DeepWiSe888/Octopus/hardware/README.md

# Getting to Know the Hardware

We offer information about the hardware and tips on how to use the hardware. For more details about the hardware, please refer to the schematics. Here, we just list the key components in the following pictures.

## Antenna Array Board

<p align="center">
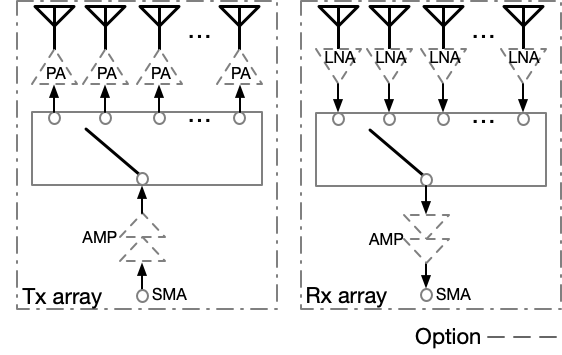
[picture p3: image/array_block.png]
   
</p>

<!-- ![Aaron Swartz](https://raw.githubusercontent.com/DeepWiSe888/Octopus/main/image/array_block.png) -->

The above figure is the top-level schematic of antenna array board. The PA, LNAs and AMPs of Tx/Rx array are optional components for some special reqirements. 

<p align="center">
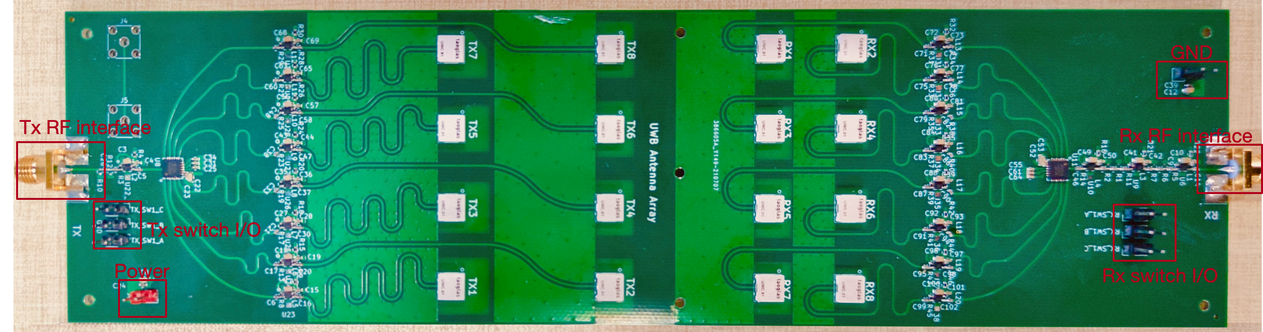
[picture p4: image/array_board.png]
   
</p>

<!-- ![Aaron Swartz](https://raw.githubusercontent.com/DeepWiSe888/Octopus/main/image/array_board.png) -->

- *Tx RF interface*: This interface connects to the Tx radio that allows RF signals to be transmitted at range from 0 GHz and 8 GHz. 
- *Rx RF interface*: This interface connects to the Rx radio that allows RF signals to be received at range from 0 GHz and 8 GHz. 
- *Tx switch I/Os*: The header pins are used for Tx antenna switching. FPGA sends the controlling signals through these I/O pins. 
- *Rx switch I/Os*: The header pins are used for Rx antenna switching. FPGA sends the controlling signals through these I/O pins. 
- *Power*: The power jack is used to connect to the power supply.
- *GND*: The ground is used to connect to other developing boards in ground plane.

## Principle of the MIMO Radar
To understand the working principles of the MIMO radar, we first look at a simple example. In the simple antenna array, we have 1 Tx antenna and 4 Rx antennas, and the Rx antennas are separated by a distance of λ/2, as shown below.

<p align="center">
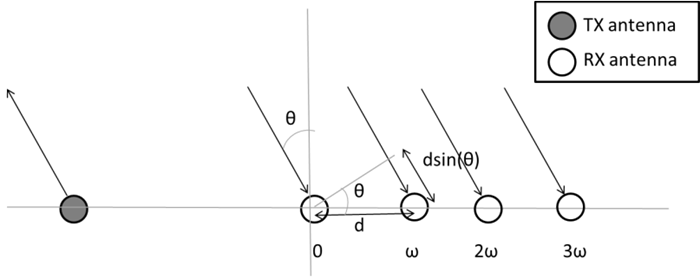
[picture p5: image/mimo0.png]
   
</p>

<!-- ![Aaron Swartz](https://raw.githubusercontent.com/DeepWiSe888/Octopus/main/image/mimo0.png) -->

If we want to double the angle resolution capability of the array, one possible solution is to double the number of Rx antenna, as shown in the figure below.

<p align="center">
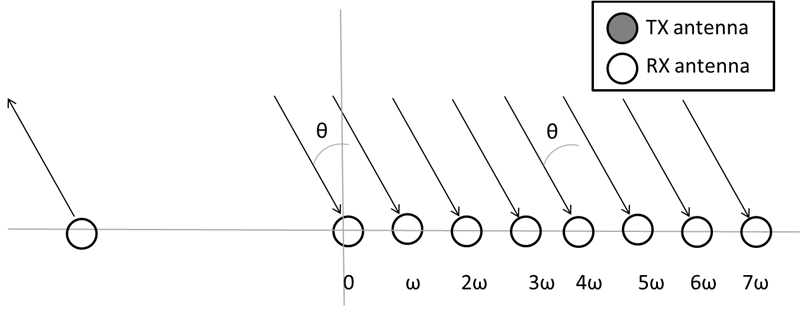
[picture p6: image/mimo1.png]
   
</p>

<!-- ![Aaron Swartz](https://raw.githubusercontent.com/DeepWiSe888/Octopus/main/image/mimo1.png) -->

Using MIMO concepts, the same result can be achieved with just one additional Tx antenna, as shown below.

<p align="center">
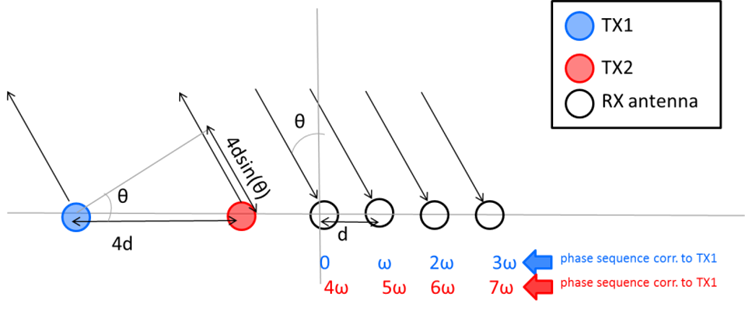
[picture p7: image/mimo2.png]
   
</p>

<!-- ![Aaron Swartz](https://raw.githubusercontent.com/DeepWiSe888/Octopus/main/image/mimo2.png) -->

In the above figure, the antenna array has two transmit antennas, Tx1 and Tx2. A transmission from Tx1 results in a phase of \[0 ω 2ω 3ω\] at the four RX antennas (with the first Rx antenna as a reference). Because the second Tx antenna (Tx2) is placed a distance of 4d from Tx1, any signal emanating from Tx2 traverses an additional path of length 4dsin(θ) compared to Tx1. Correspondingly, the signal at each Rx antenna sees an additional phase-shift of 4ω (with regard to transmission from Tx1). The phase of the signal at the four Rx antennas, due to a transmission from Tx2, is \[4ω 5ω 6ω 7ω\]. Concatenating the phase sequences at the four Rx antennas, due to transmissions from Tx1 and Tx2, gets the sequence \[0 ω 2ω 3ω 4ω 5ω 6ω 7ω\], which is the same sequence as the configuration of 1 Tx and eight Rx antennas. It can be said that the 2Tx – 4Rx antenna configuration synthesizes a virtual array of eight RX antennas (with one Tx antenna being implied).

To generalize the previous discussion, with N<sub>Tx</sub> and N<sub>RX</sub> antennas, users can generate (with proper antenna placement) a virtual antenna array of N<sub>TX</sub> X N<sub>Rx</sub>. Thus, employing MIMO radar techniques, results in a multiplicative increase in the number of (virtual) antennas, and corresponds to improvement in the angle resolution.

If p<sub>m</sub> denotes the coordinates of the mth Tx antenna (m = 0, 1, ...N<sub>Tx</sub>), and q<sub>n</sub> denotes the coordinates of the n-th Rx antenna (n = 0, 1, 2, …N<sub>Rx</sub>), then the location of the virtual antennas can be computed as p<sub>m</sub>+q<sub>n</sub>, for all possible values of m and n. For example in Figure 5, p<sub>1</sub> = 0 and p<sub>2</sub> = 4, and q<sub>1</sub> = 0, q<sub>2</sub> = 1, q<sub>3</sub> = 2, and q<sub>4</sub> = 3 (where the coordinates are expressed in units of d, and the Tx1 (respectively Rx1) is assumed to be the origin for the Tx (respectively, Rx) antennas.

The figure below shows the principle of MIMO radar can also be extended to multidimensional arrays.

<p align="center">
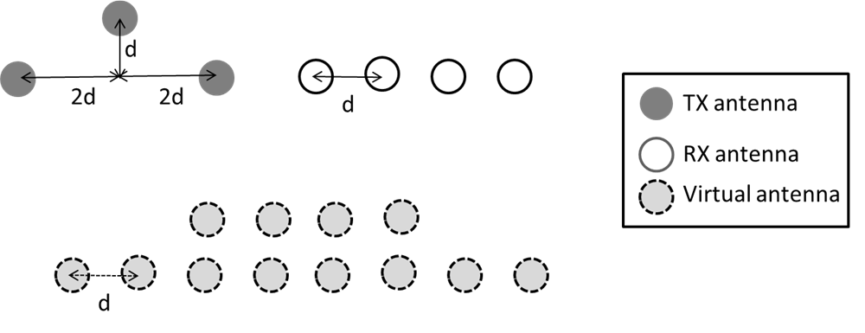
[picture p8: image/mimo3.png]
   
</p>

<!-- ![Aaron Swartz](https://raw.githubusercontent.com/DeepWiSe888/Octopus/main/image/mimo3.png) -->

Based on the above-mentioned analysis, each of Octopus antenna array can provide an equivalent of 2 x 7 x 2 = 28 virtual antennas.

## X4 Evaluation Board

<p align="center">
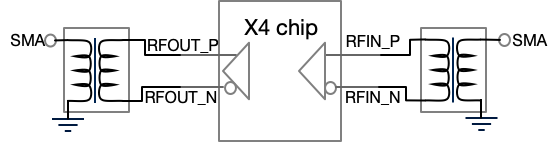
[picture p9: image/x4_eval_block.png]
   
</p>

<!-- ![Aaron Swartz](https://raw.githubusercontent.com/DeepWiSe888/Octopus/main/image/x4_eval_block.png) -->

The top-level schematic of X4 evaluation board is shown in the above figure. The Rx/Tx port of X4 chip is differential output, and then the RF balun is applied to transform it to single Rx/Tx port.  Refer to the ADI [NCR2-123+](https://www.minicircuits.com/pdfs/NCR2-123+.pdf) for full specifications.

<p align="center">
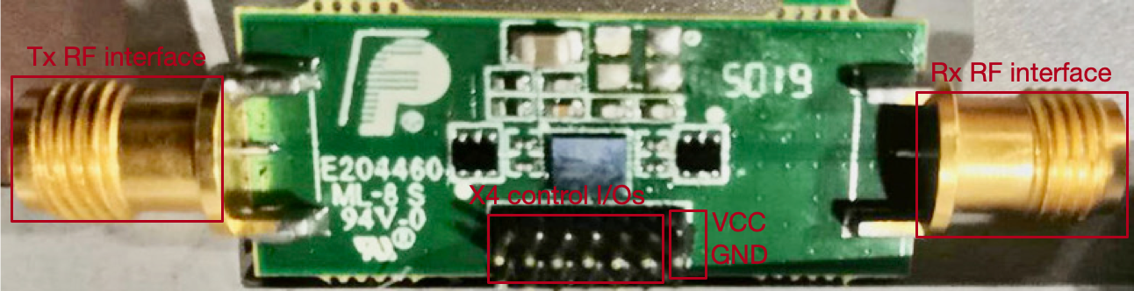
[picture p10: image/x4_board.png]
   
</p>

<!-- ![Aaron Swartz](https://raw.githubusercontent.com/DeepWiSe888/Octopus/main/image/x4_board.png) -->

- *Tx RF interface*: This interface connects to the Tx radio that allows RF signals to be transmitted at 7.29 GHz with 1.4 GHz bandwidth.
- *Rx RF interface*: This interface connects to the Rx radio that allows RF signals to be received at 7.29 GHz with 1.4 GHz bandwidth.
- *X4 control I/Os*: The header pins includes SPI pins, clock synchronization pins, trigger pins, etc. which are connected to FPGA.
- *Power*: The power jack is where the power supply that comes with power source.
- *GND*: The ground is used to connect to other developing boards in ground plane.

## X4 Chip Circuit Overview

X4 chip is a radar transceiver SoC for UWB applications.  The overview of X4 internal circuit is shown in the figure below. The figure also illustrates our hardware design rationale in the previous sections. This figure come from Page 12 of the X4 chip datasheet.

<p align="center">
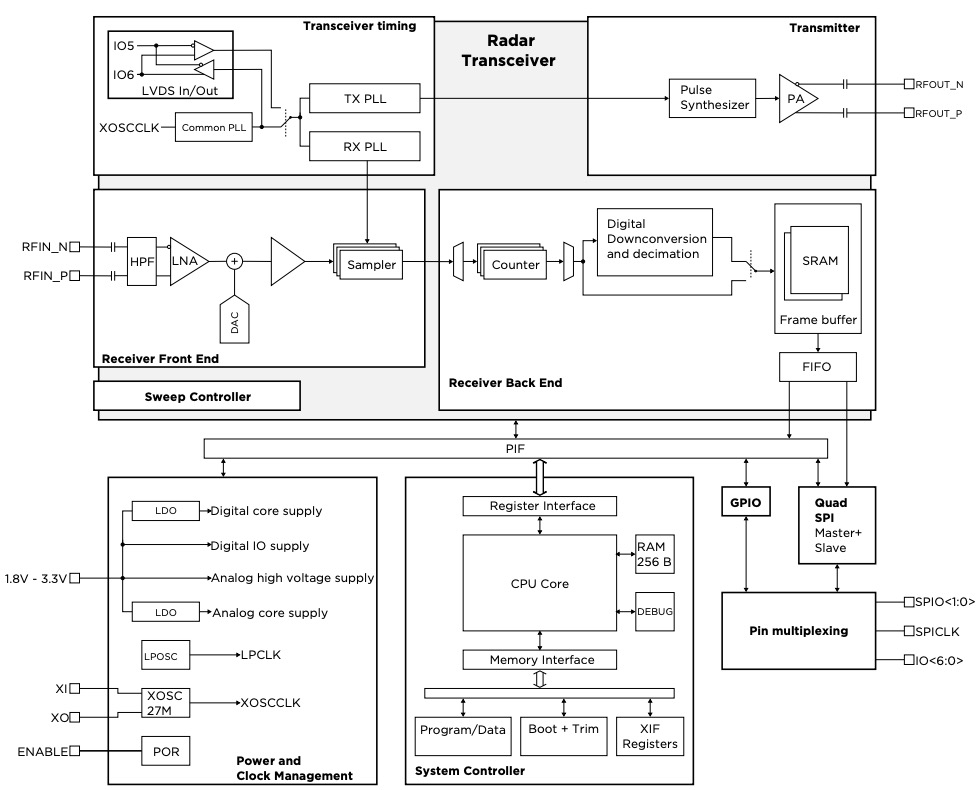
[picture p11: image/x4_circuit.jpg]
   
</p>

<!-- ![Aaron Swartz](https://raw.githubusercontent.com/DeepWiSe888/Octopus/main/image/x4_circuit.jpg) -->

### Tx Data Path

The Tx data path of the X4 consists of a pulse generator that is capable of generating pulses (max rate of 60.75 MHz). The center frequency and bandwidth of the output pulse is designed in compliance with worldwide RF regulations.

### Rx Data Path

The Rx data path of the X4 includes a Low Noise Amplifier (LNA), a Digital-to-Analog Converter (DAC) for setting thresholds, 1536 parallel comparators/samplers and digital integrators, as well as an output memory buffer, which is accessible through the SPI interface. The Rx data path is closely integrated with the transmitter (Tx) and is designed for coherent integration of the received energy.

### Clock

There are two types of clocks in the X4 chip: internal and external clocks. We shall elaborate on these clocks in the following:

#### Internal Clock

The crystal oscillator (XOSC) is designed for providing the radar transceiver core with a stable and accurate reference clock signal.  In the figure below, we show a typical block schematic when the X4 is clocked using the XOSC.

<p align="center">
   [YOUR_ALT]
</p>
<!-- ![Aaron Swartz](https://raw.githubusercontent.com/DeepWiSe888/Octopus/main/image/x4_interClock.jpg) -->

#### External Clock

- In XOSC bypass mode the radar core is clocked by an external low frequency clock source. This mode can be useful if there is already a clock signal available on the application PCB. The external clock input pin supports single-ended inputs. In the figure below, we show a typical block schematic when the X4 is clocked using the XOSC bypass mode.

<p align="center">
   [YOUR_ALT]
</p>

<!--   ![Aaron Swartz](https://raw.githubusercontent.com/DeepWiSe888/Octopus/main/image/x4_exClock1.jpg) -->

- In Common PLL bypass mode the radar transceiver core is clocked by an external high frequency clock from the LVDS interface on pins IO5 and IO6 and the Common PLL is bypassed. This allows multiple radars to stay synchronized which is required for digital beamforming applications. In the figure below, we show a block diagram of the Common PLL in bypass mode.

<p align="center">
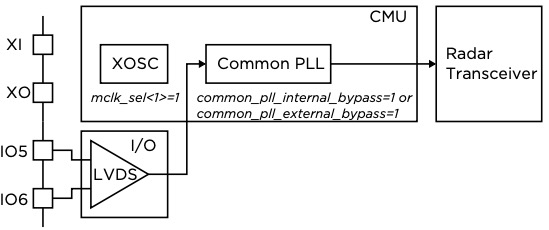
[picture p12: image/x4_exClock2.jpg]
   
</p>

<!--   ![Aaron Swartz](https://raw.githubusercontent.com/DeepWiSe888/Octopus/main/image/x4_exClock2.jpg) -->

For more information, please refer to X4 chip [datasheet](https://www.radartutorial.eu/19.kartei/13.labs/pubs/x4_datasheet_revE_restricted.pdf).

## RF Port

A 50 ohm SMA jack is employed to connect to each RF interface. This connector is a standard-thread and standard-polarity SMA jack.  

## Power Supply

All the boards requires an external 5V DC power supply. 

## Design Files

[*sch/X4_ArrayUnit.pdf*](https://github.com/DeepWiSe888/Octopus/blob/main/hardware/sch/X4_ArrayUnit.pdf): This  file is the schematic of the whole antenna array board.

[*sch/X4_TestingBoard.pdf*](https://github.com/DeepWiSe888/Octopus/blob/main/hardware/sch/X4_TestingBoard.pdf): This file describe the testing RF switch board for loopback evaluation.

[*sch/X4_DevBoard.pdf*](https://github.com/DeepWiSe888/Octopus/blob/main/hardware/sch/X4_DevBoard.pdf): This file is the X4 Evaluation Board
