DeepWiSe888/Octopus/image/mimo4.png

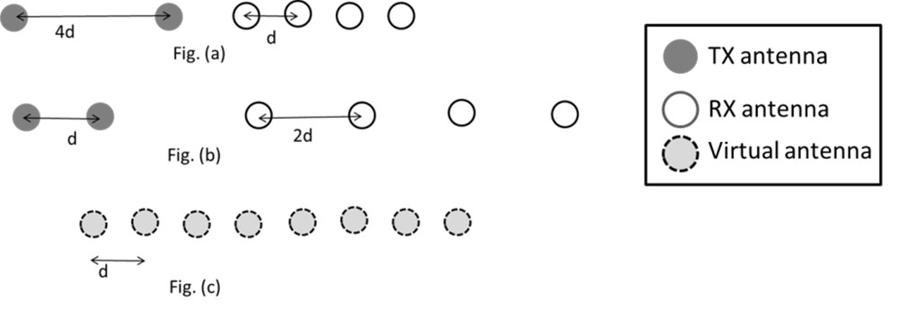
image/mimo4.png
