DeepWiSe888/Octopus/(list of files, cad)

Other CAD files:
source/FPGA_qxp_prj/prj/output_files/gg.stp
