DeepWiSe888/Octopus/hardware/sch/AW_UWB_TS_01.pdf

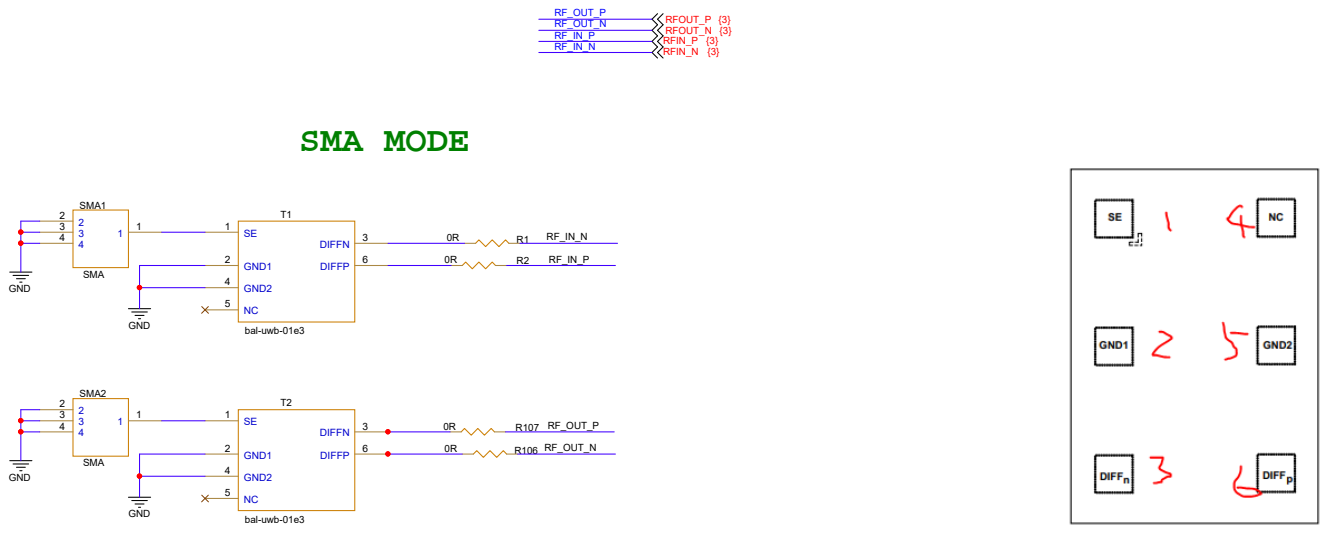
[picture p15: page 1]
SMA MODE; GND; RFOUT_P {3} RFOUT_N {3} RFIN_P {3} RFIN_N {3}; Title; MODE; SMA2; SMA; bal-uwb-01e3; GND1 2; GND2 4; DIFFP; DIFFN; SMA1; RF_OUT_P RF_OUT_N RF_IN_P RF_IN_N; RF_OUT_N; RF_OUT_P

Size A3 | Document Number SCH | Rev V1.0

Date: Wednesday, November 27, 2019 Wednesday, November 27, 2019 Wednesday, November 27, 2019 | Sheet 1 1 1 of 3 3 3

VDD_IN | VDD_X4
R100 | 0R

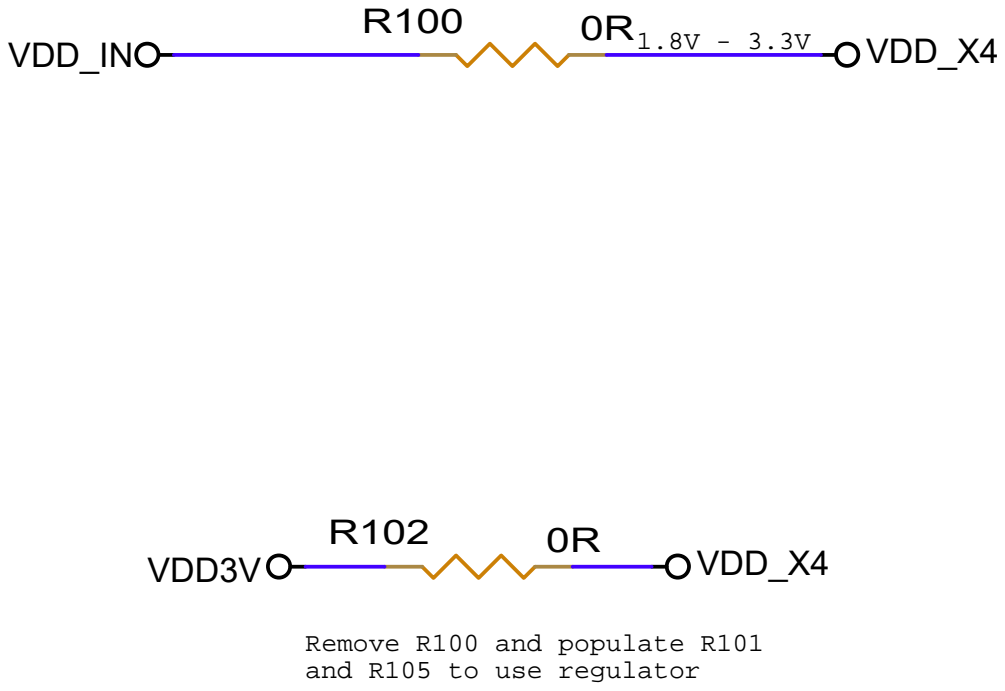
[picture p16: page 2]
VDD3V; VDD_X4; Title; LTC3621EDCB; Wednesday, November 27, 2019

Remove R100 and populate R101
and R105 to use regulator

# TO MCU MODULE

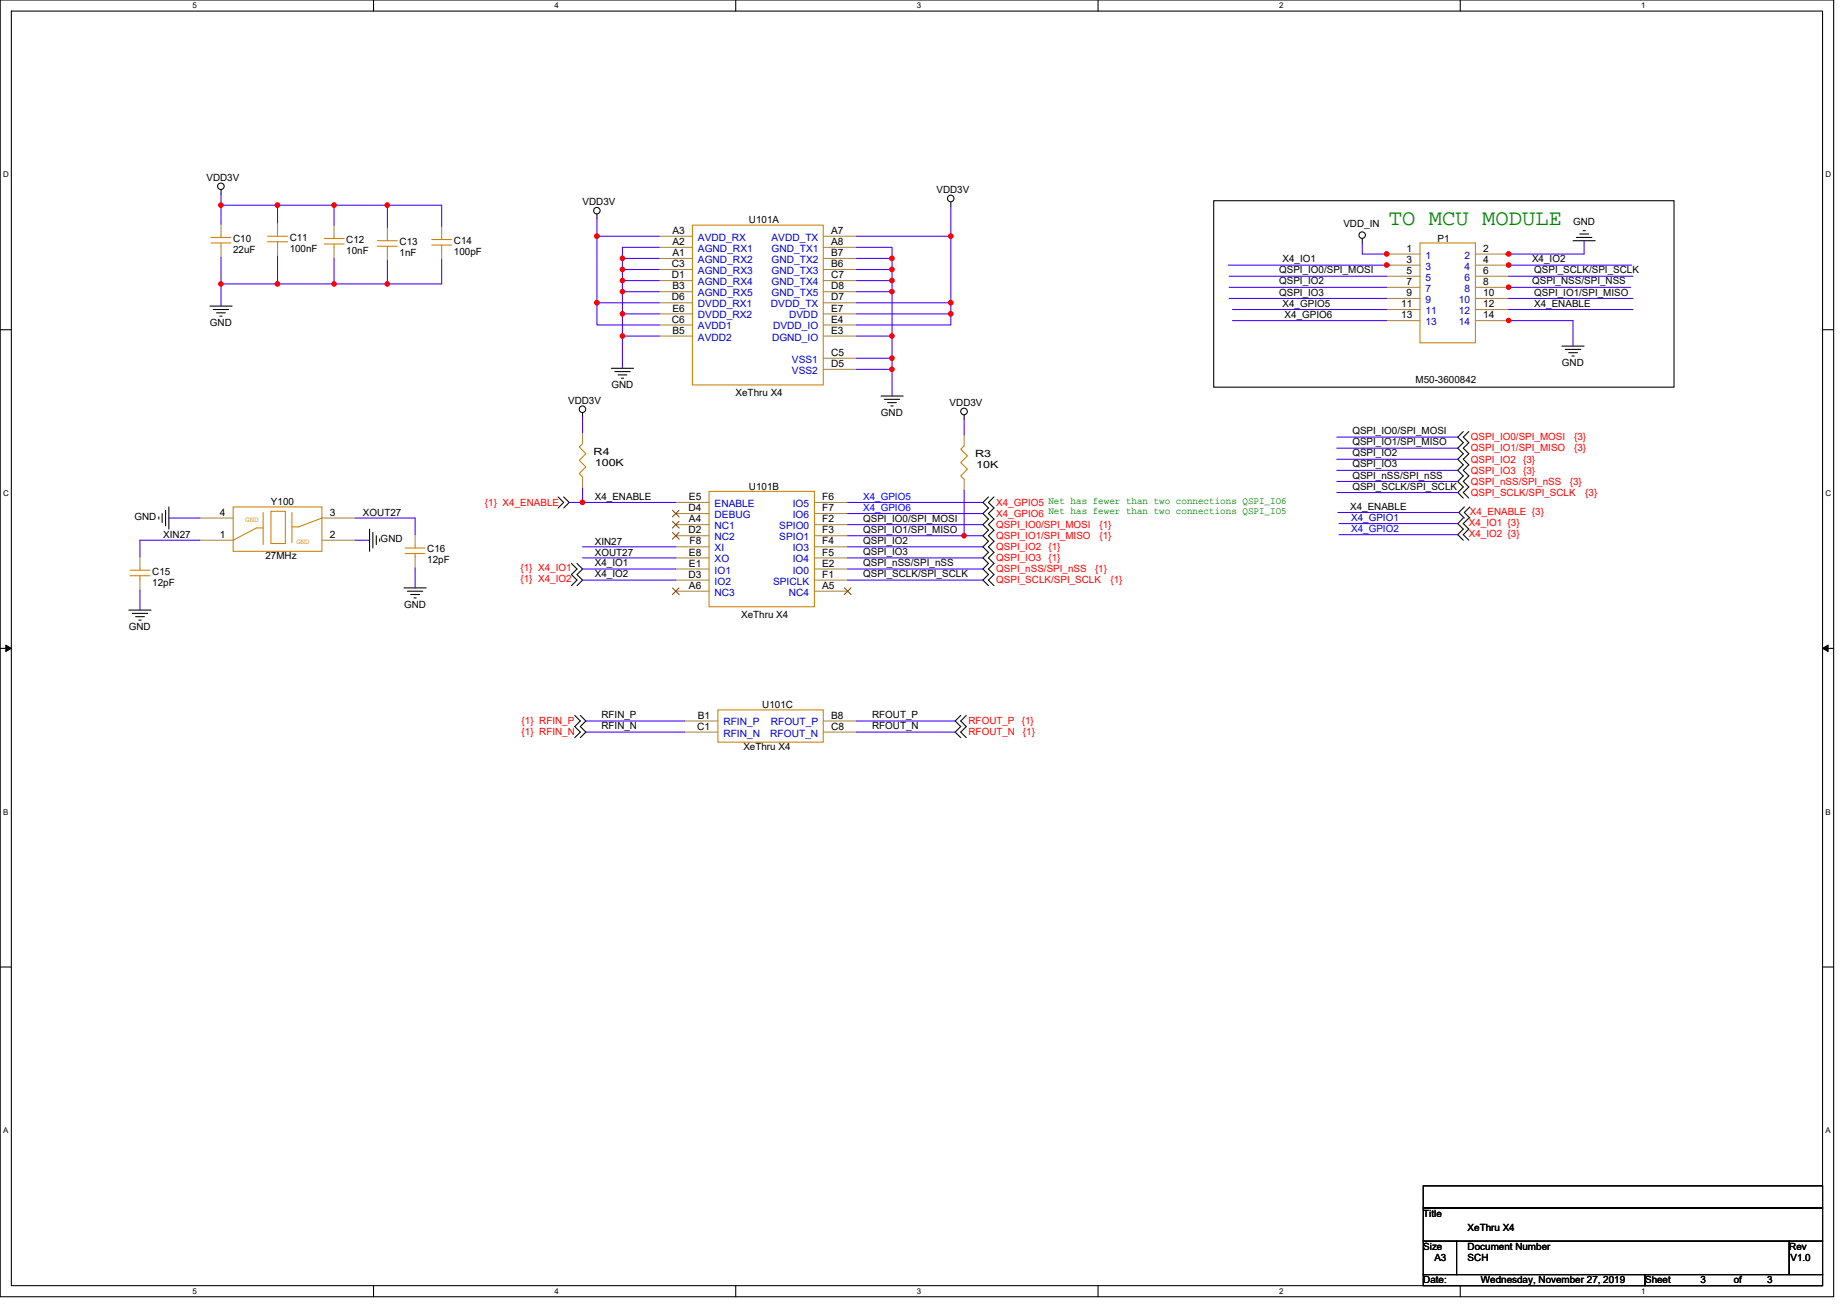
[picture p17: page 3]

Net has fewer than two connections QSPI_IO6
Net has fewer than two connections QSPI_IO5
