DeepWiSe888/Octopus/hardware/sch/X4_TestingBoard.pdf

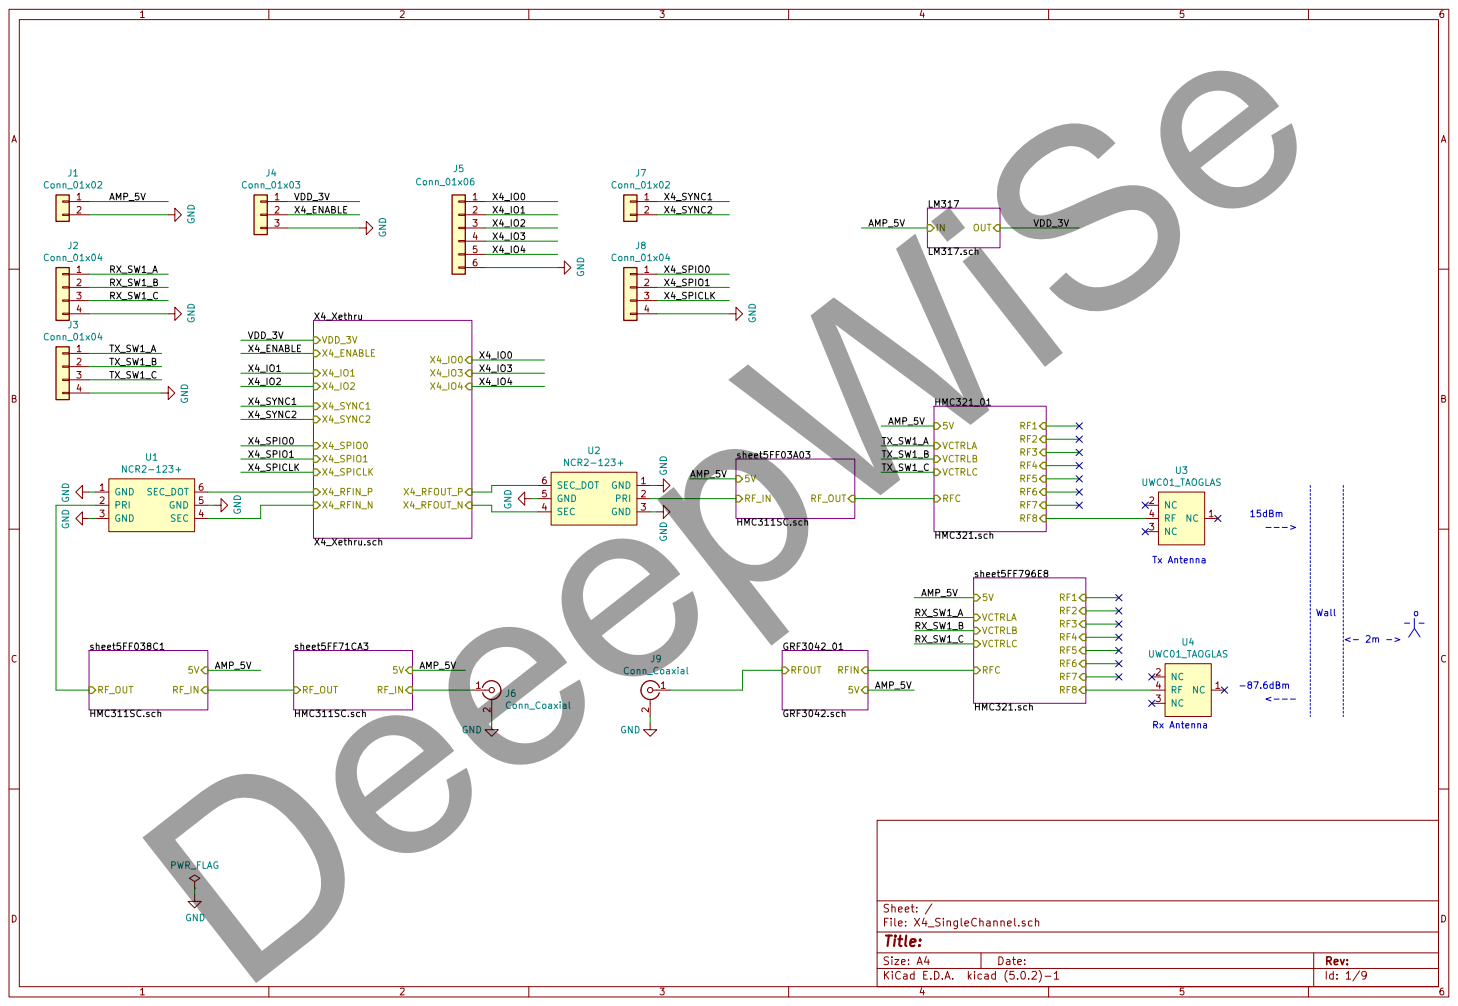
[picture p18: page 1]

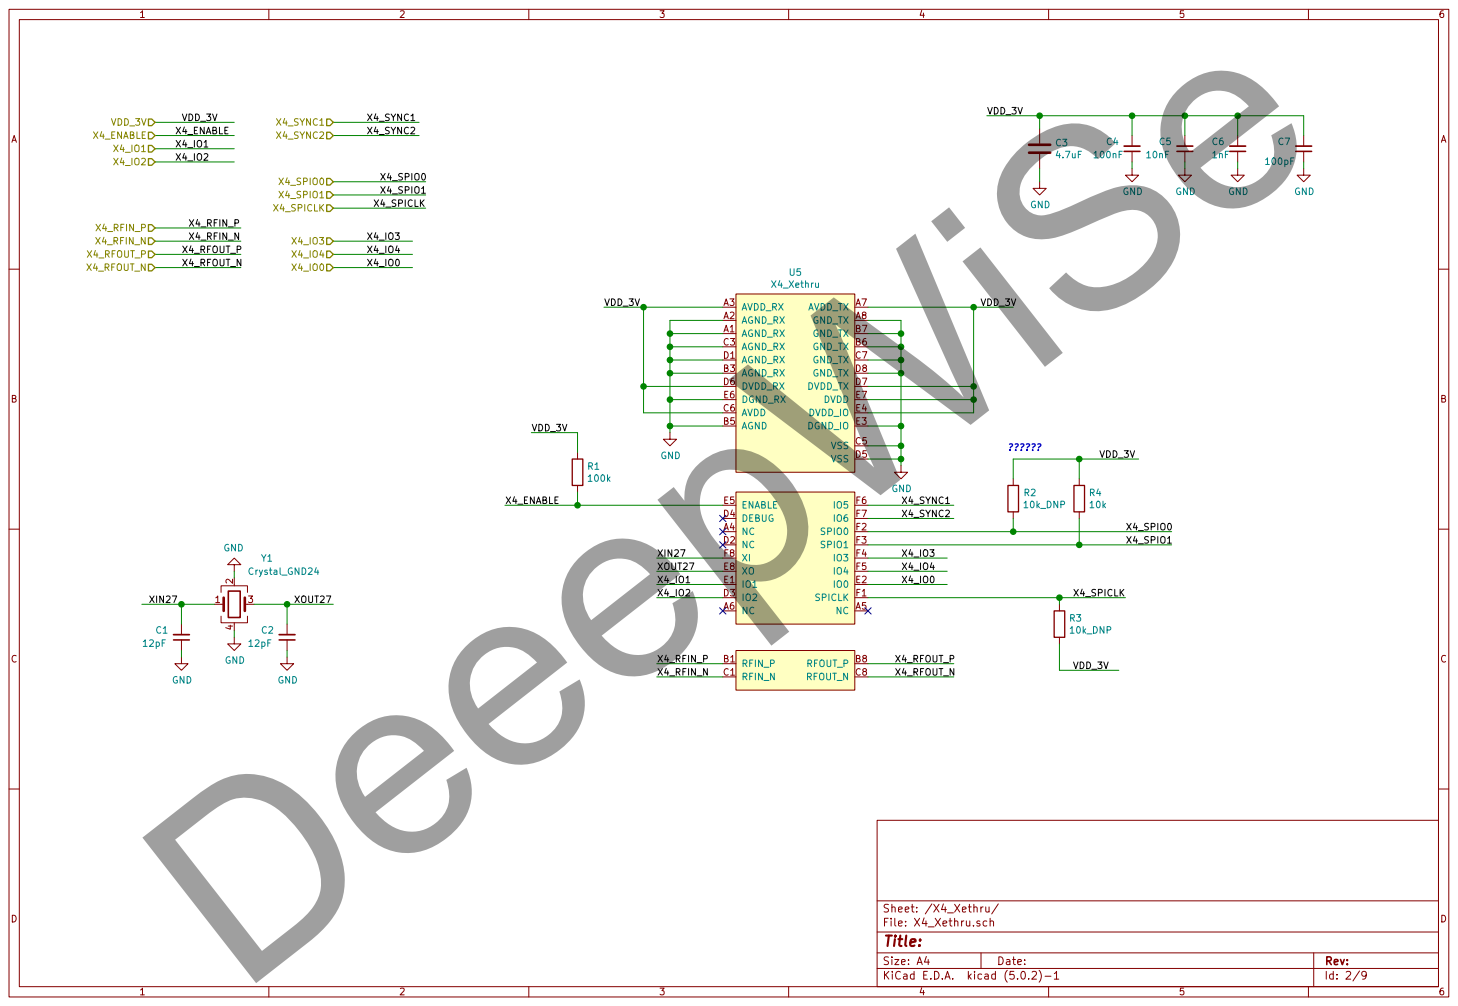
[picture p19: page 2]

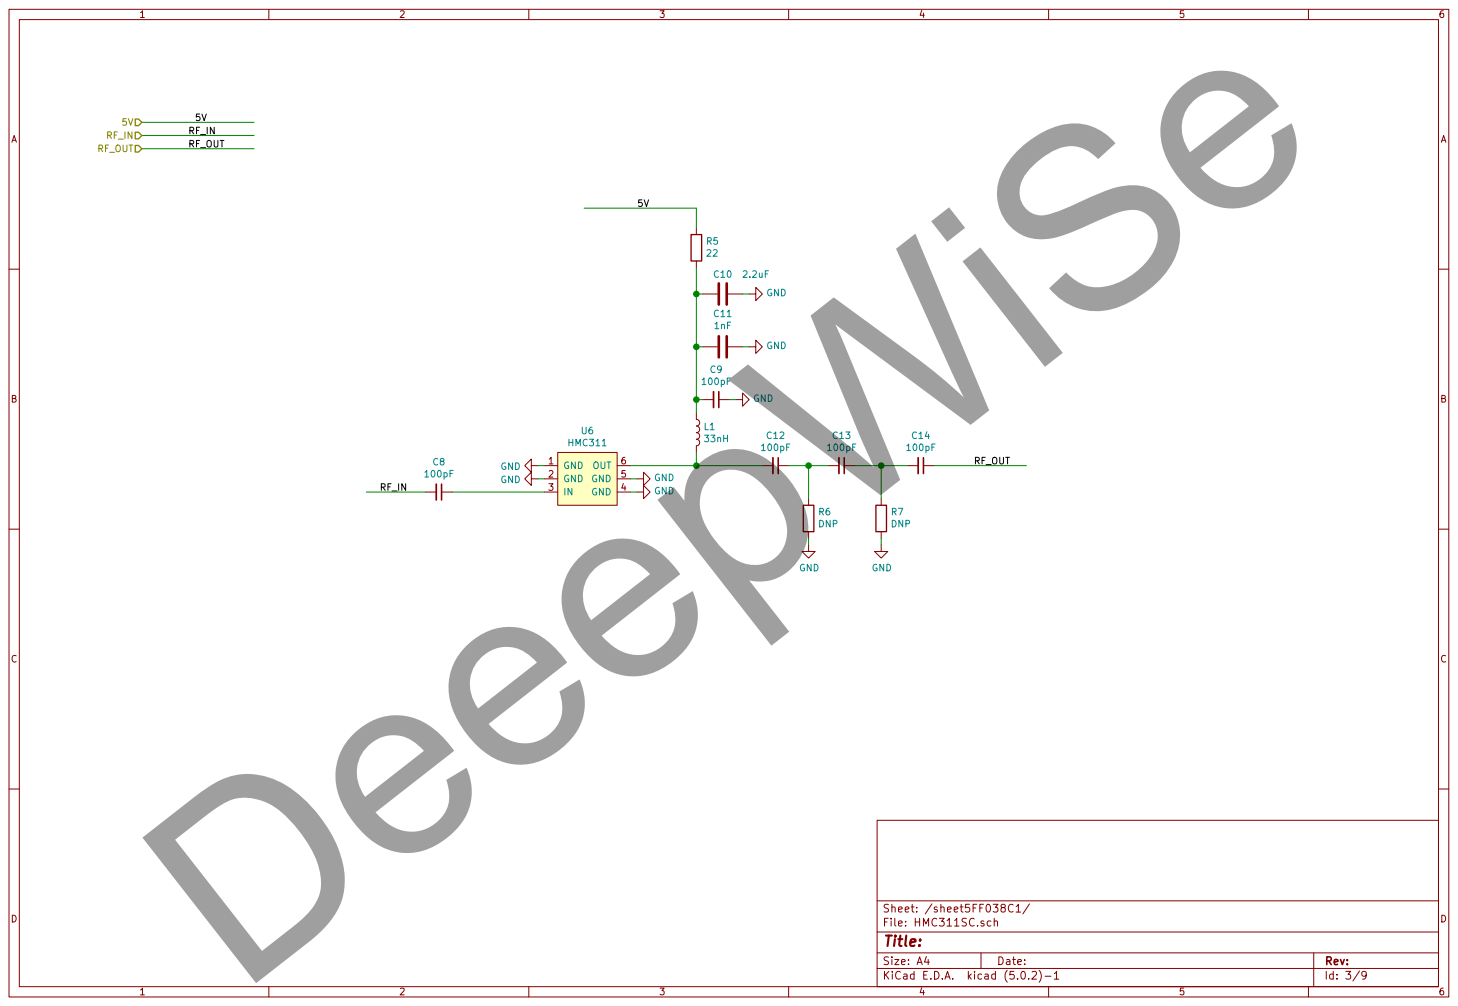
[picture p20: page 3]

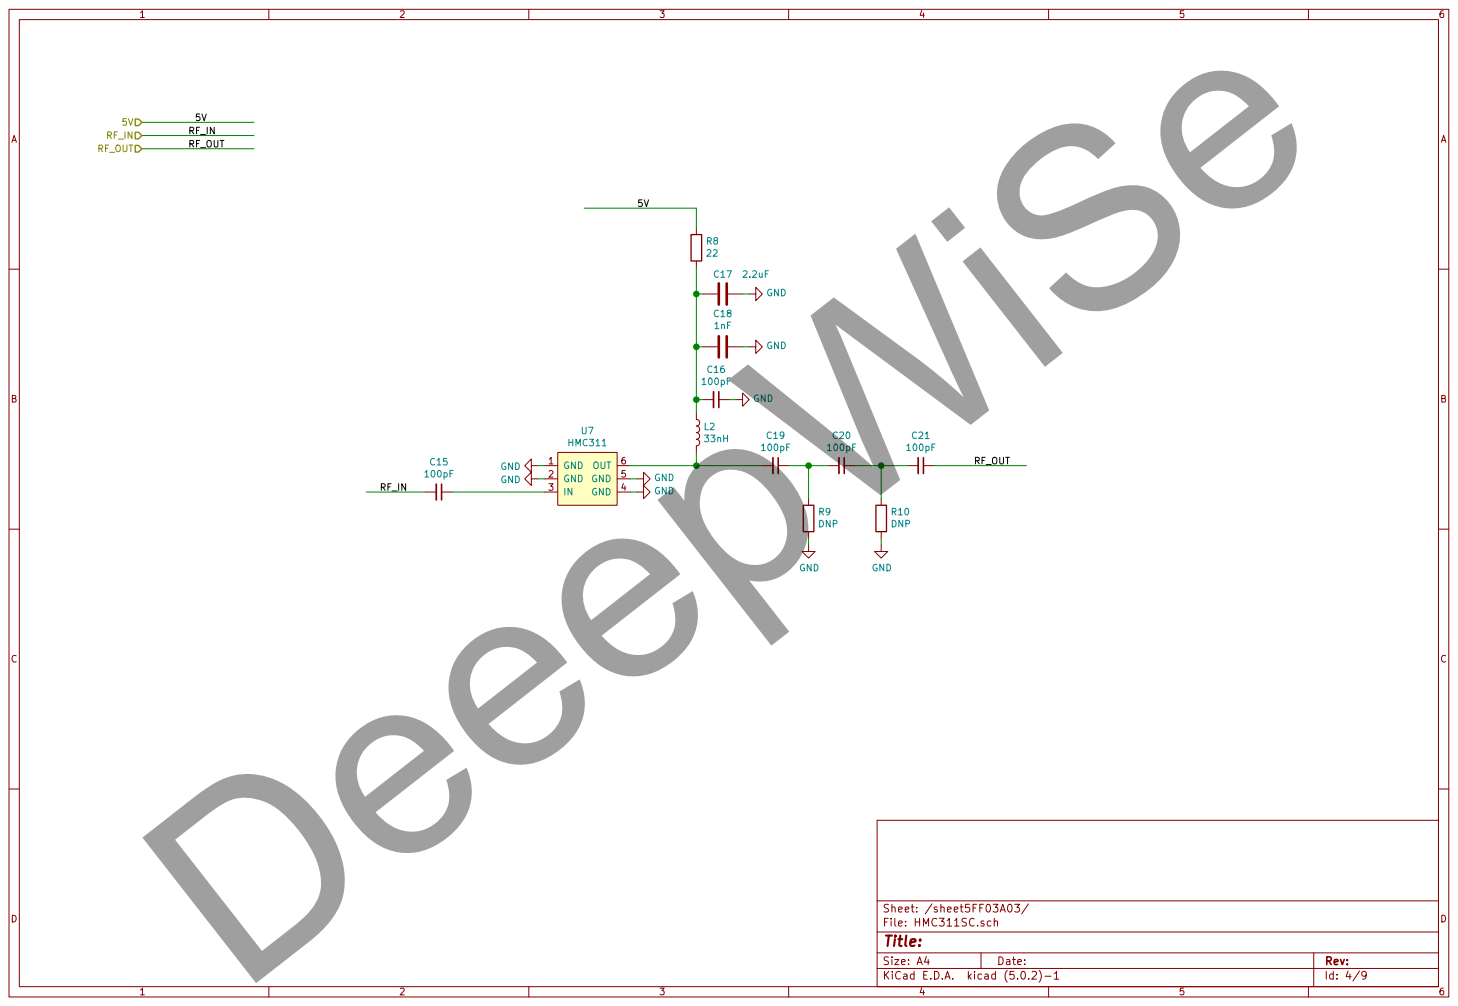
[picture p21: page 4]

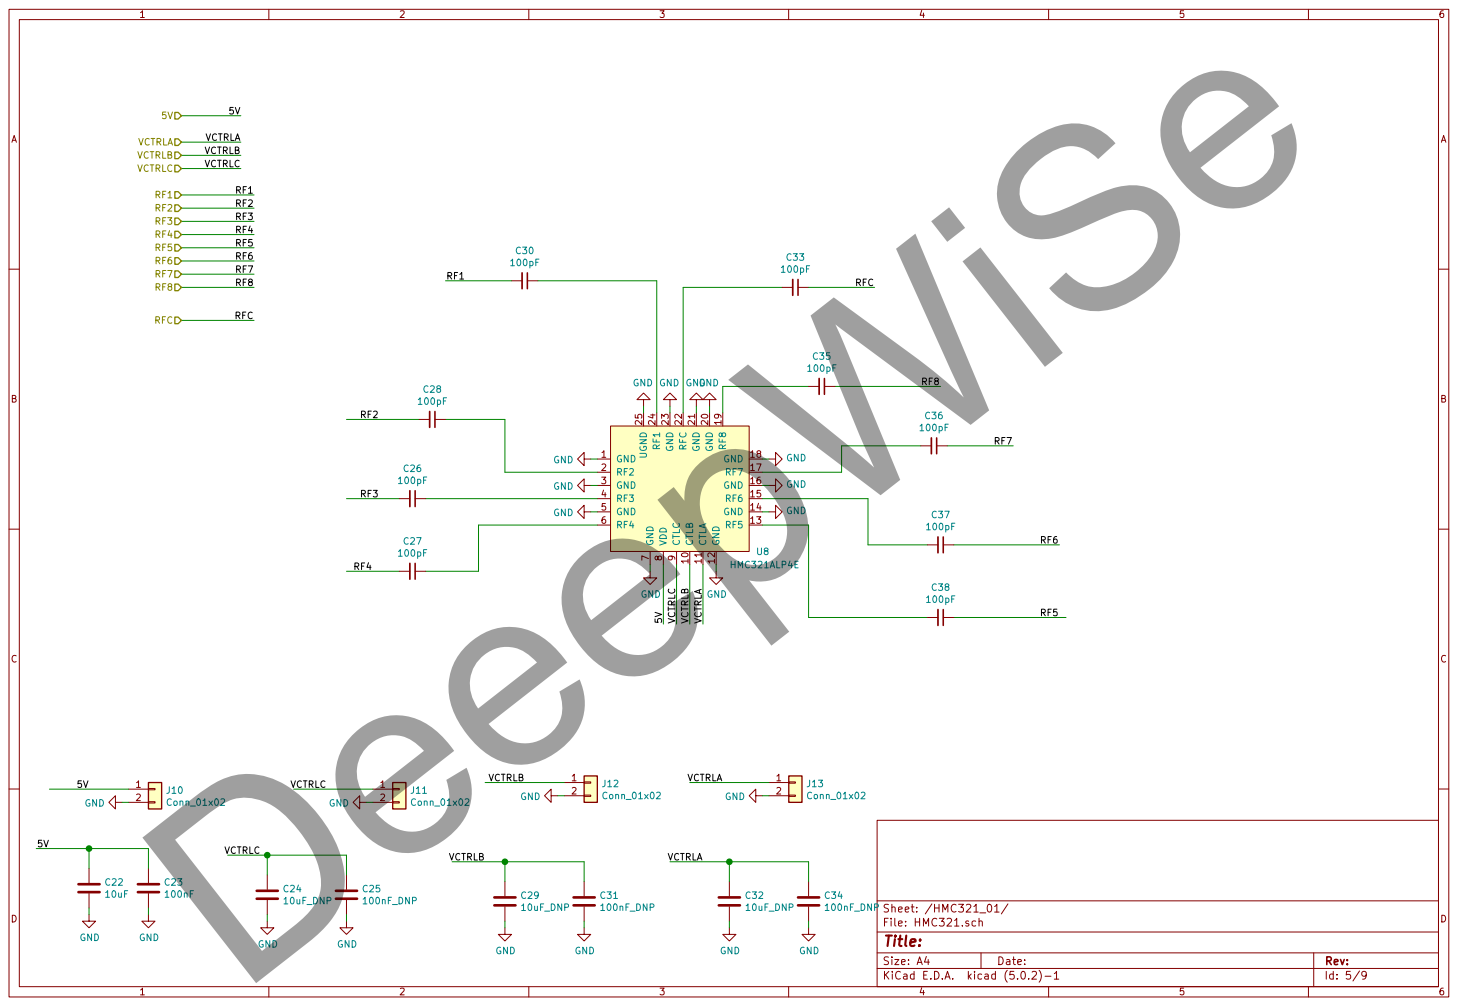
[picture p22: page 5]

9U8 HMC321ALP4E GND GND GNDGND GND GND GND GND 5VVCTRLC VCTRLB VCTRLAGND GND GND GND

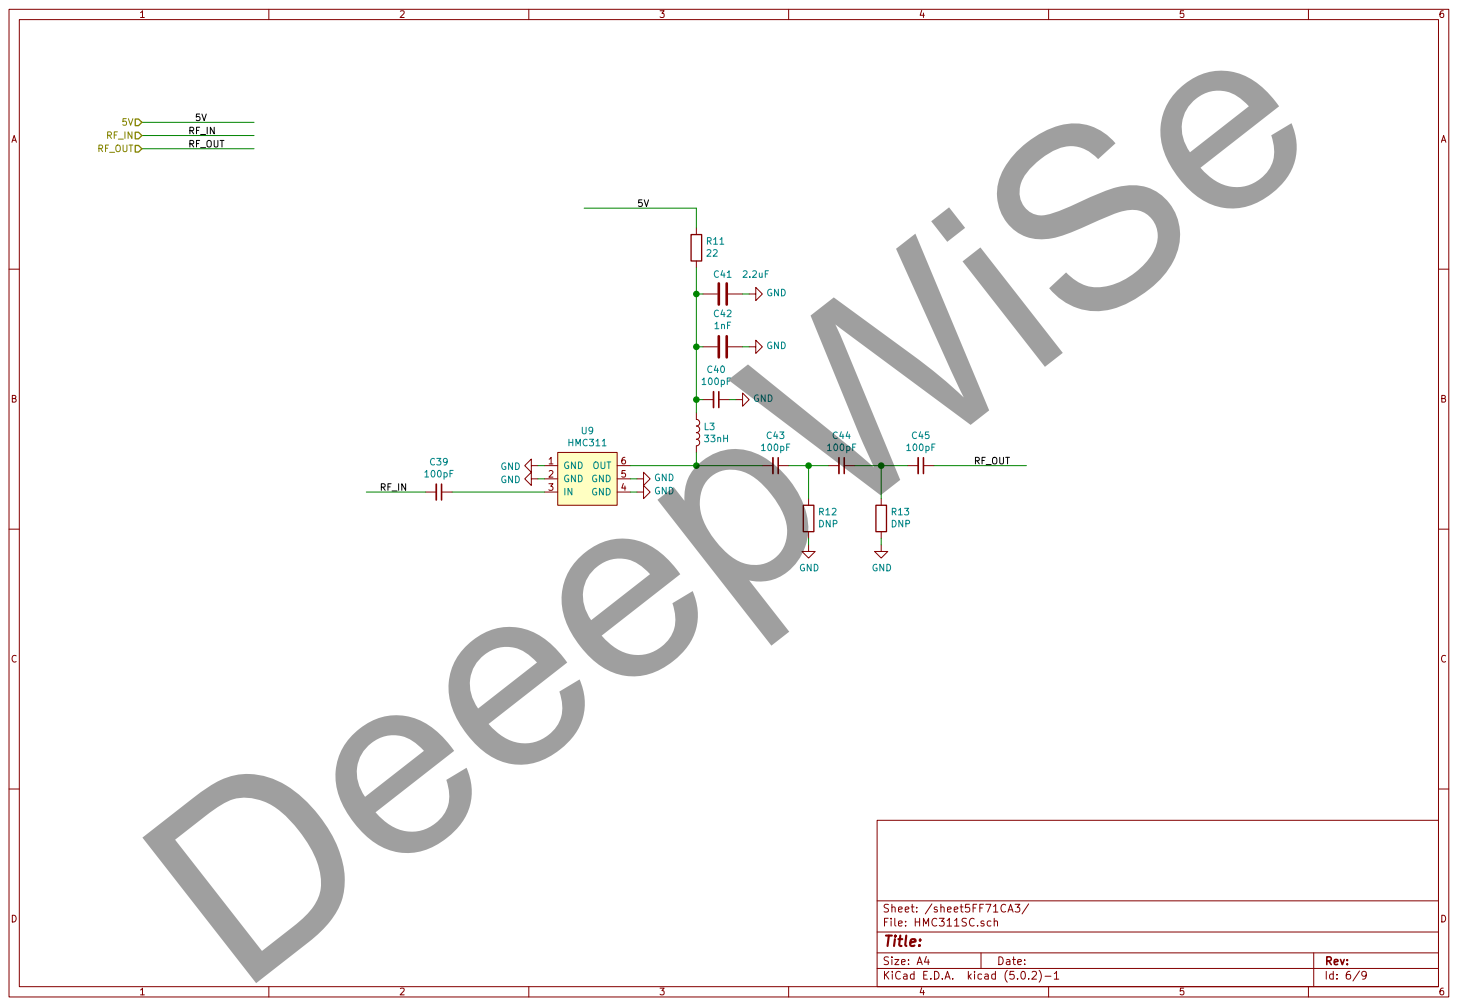
[picture p23: page 6]

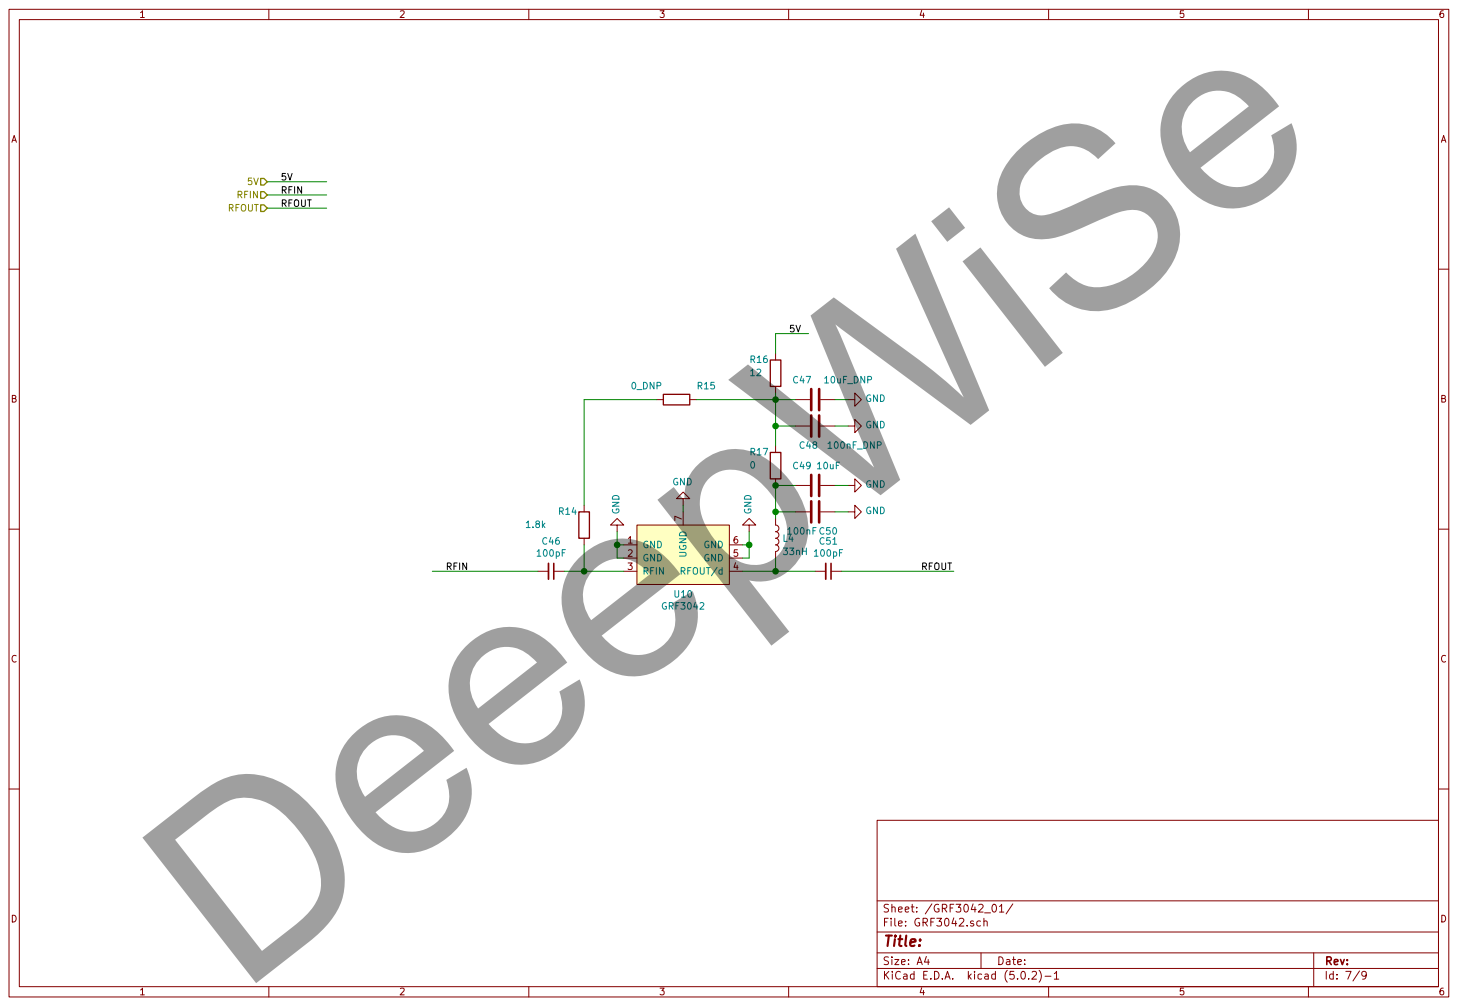
[picture p24: page 7]

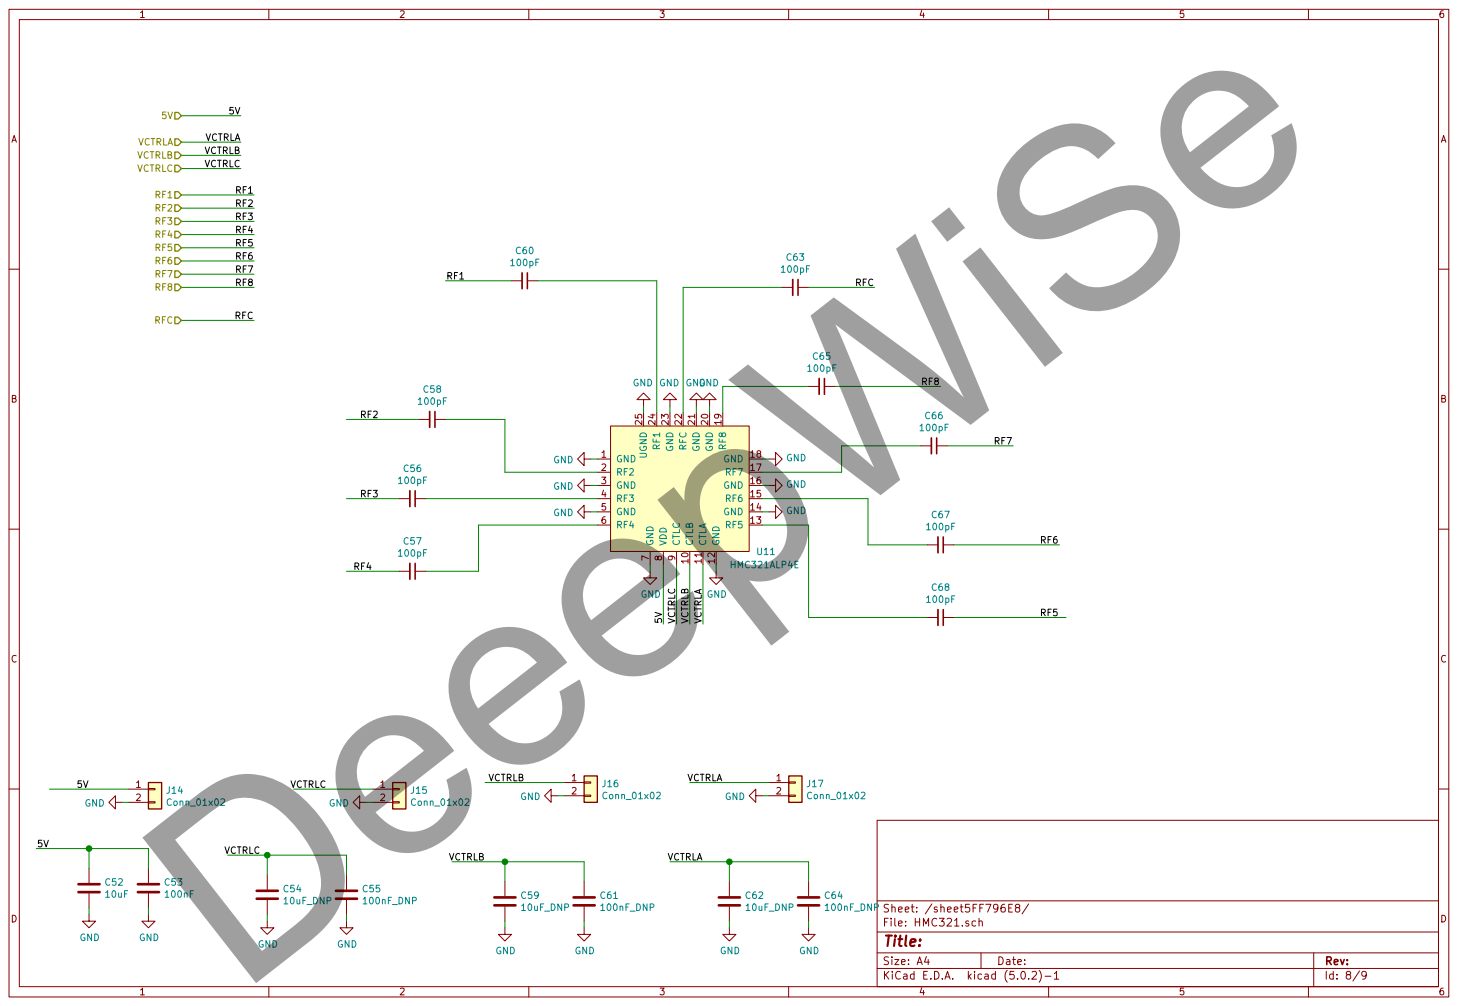
[picture p25: page 8]

9U11 HMC321ALP4E GND GND GNDGND GND GND GND GND 5VVCTRLC VCTRLB VCTRLAGND GND GND GND

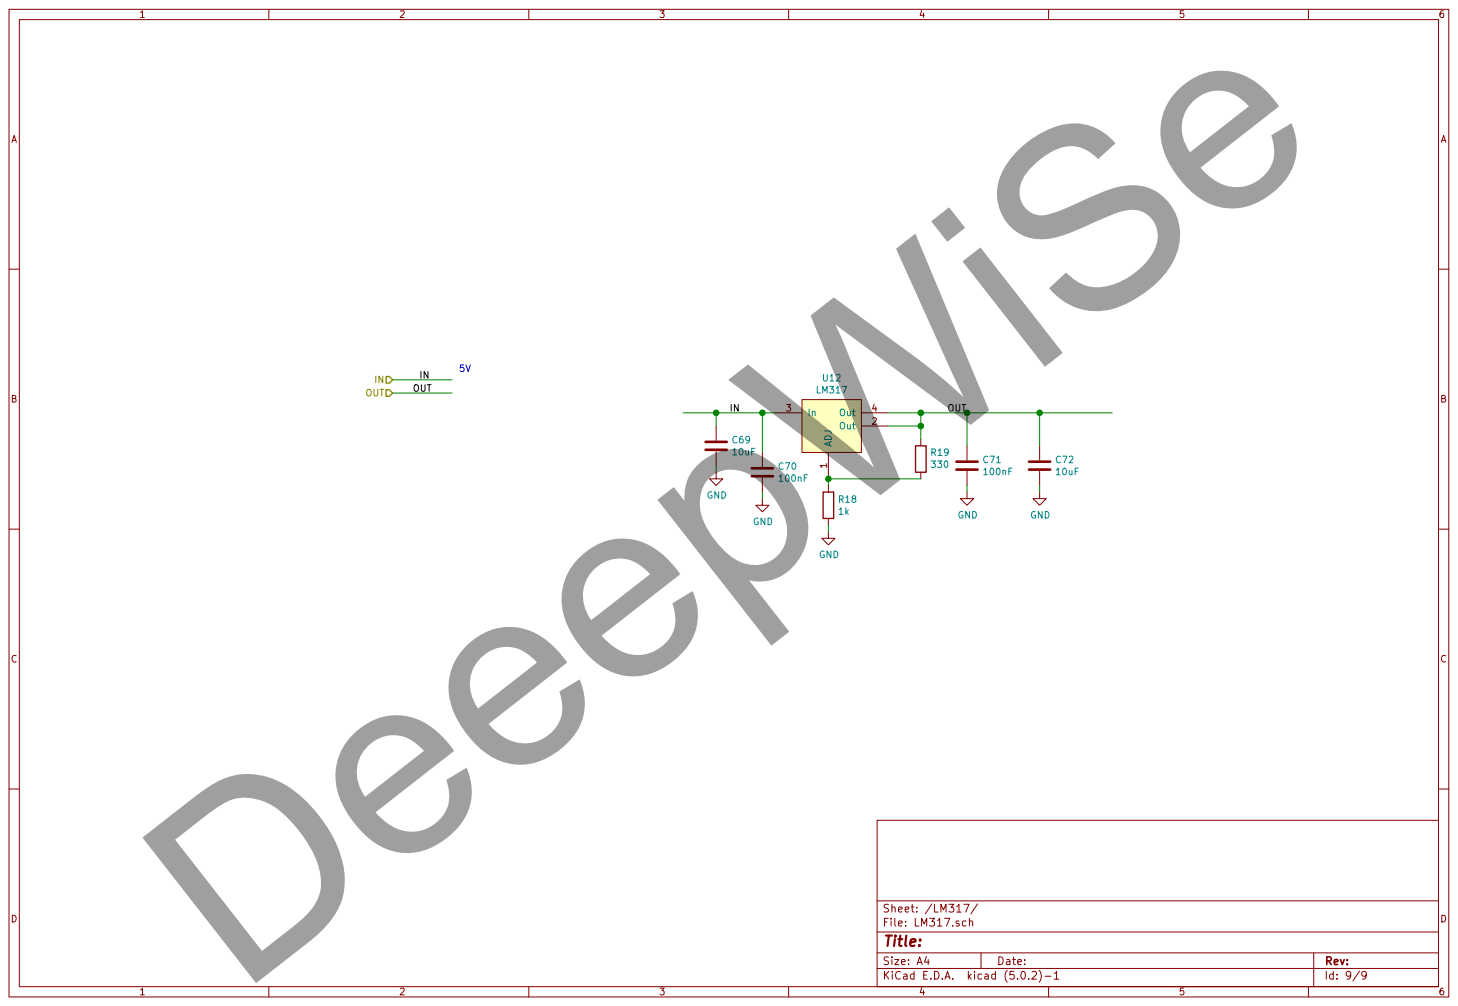
[picture p26: page 9]
