DeepWiSe888/Octopus/hardware/PCB_Print.pdf

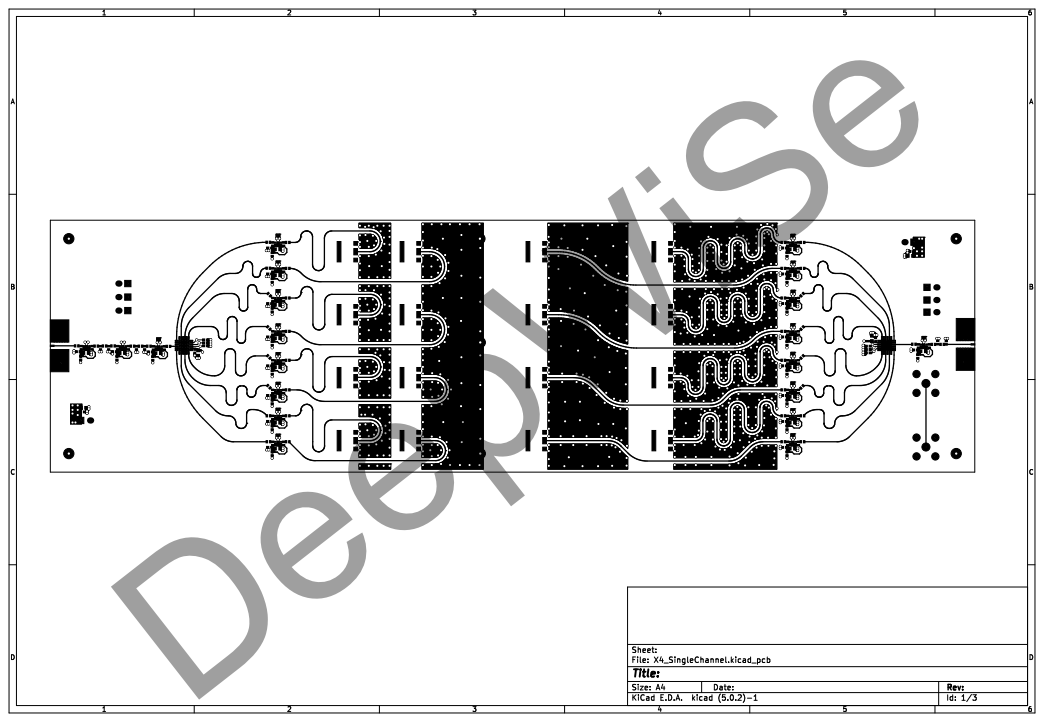
[picture p27: page 1]
DeepWiSe

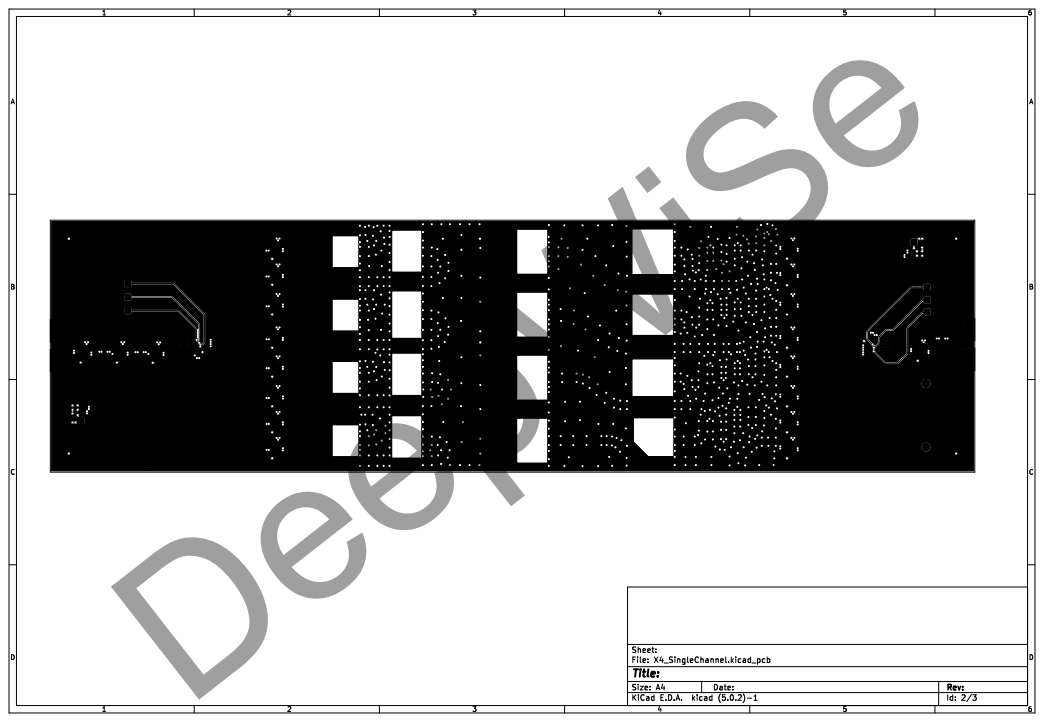
[picture p28: page 2]
DeepWiSe

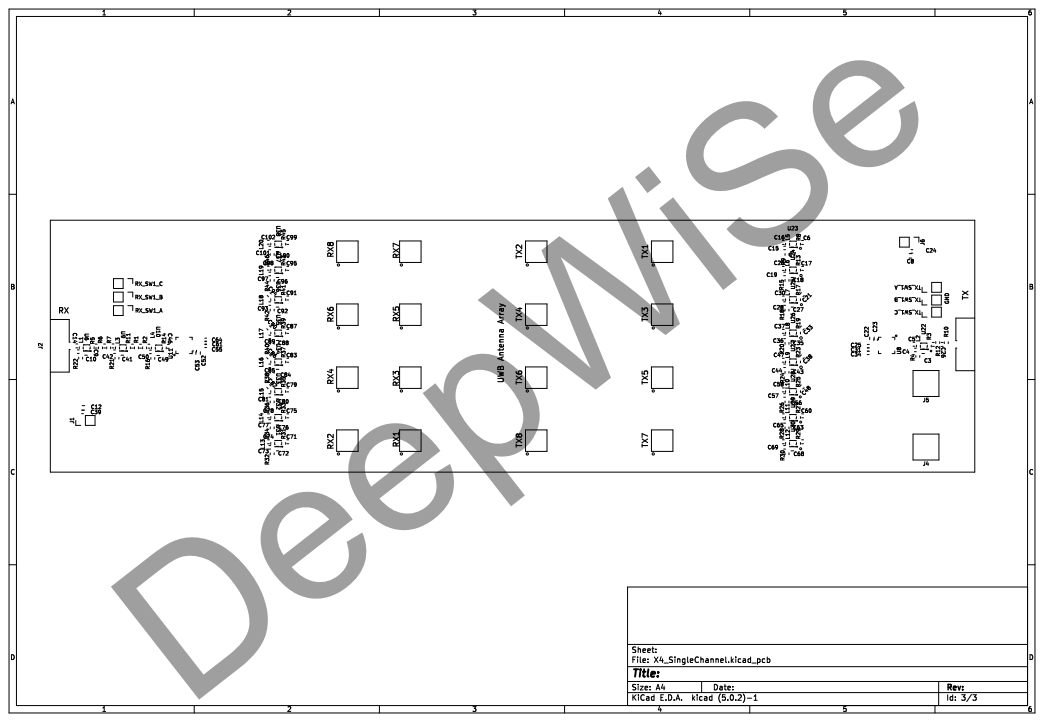
[picture p29: page 3]
DeepWiSe
