DeepWiSe888/Octopus/hardware/sch/X4_DevBoard.pdf

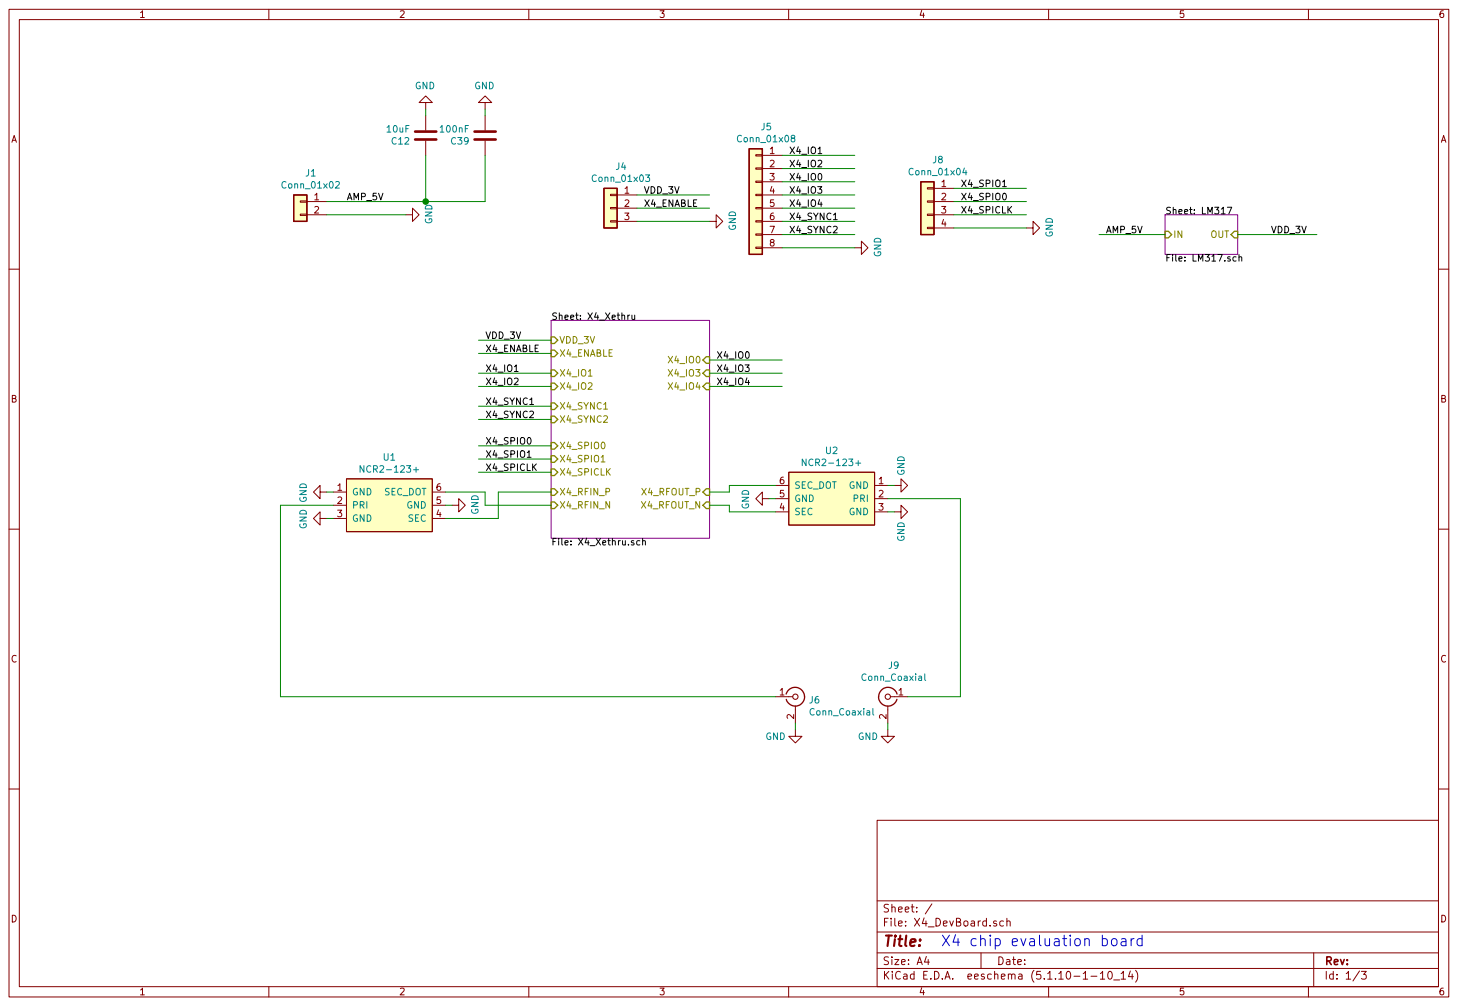
[picture p30: page 1]

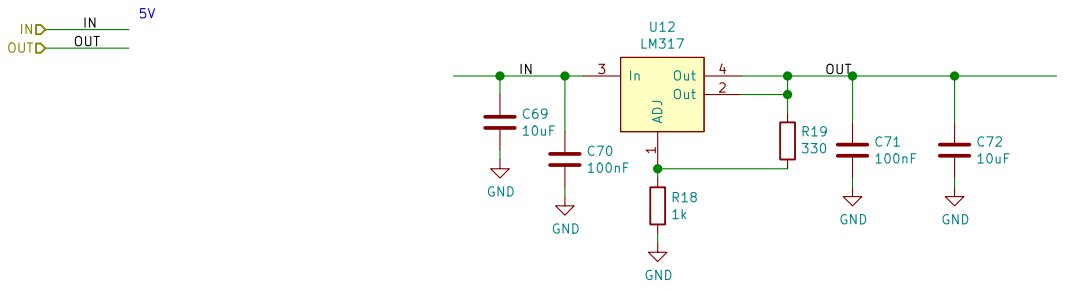
[picture p31: page 2]

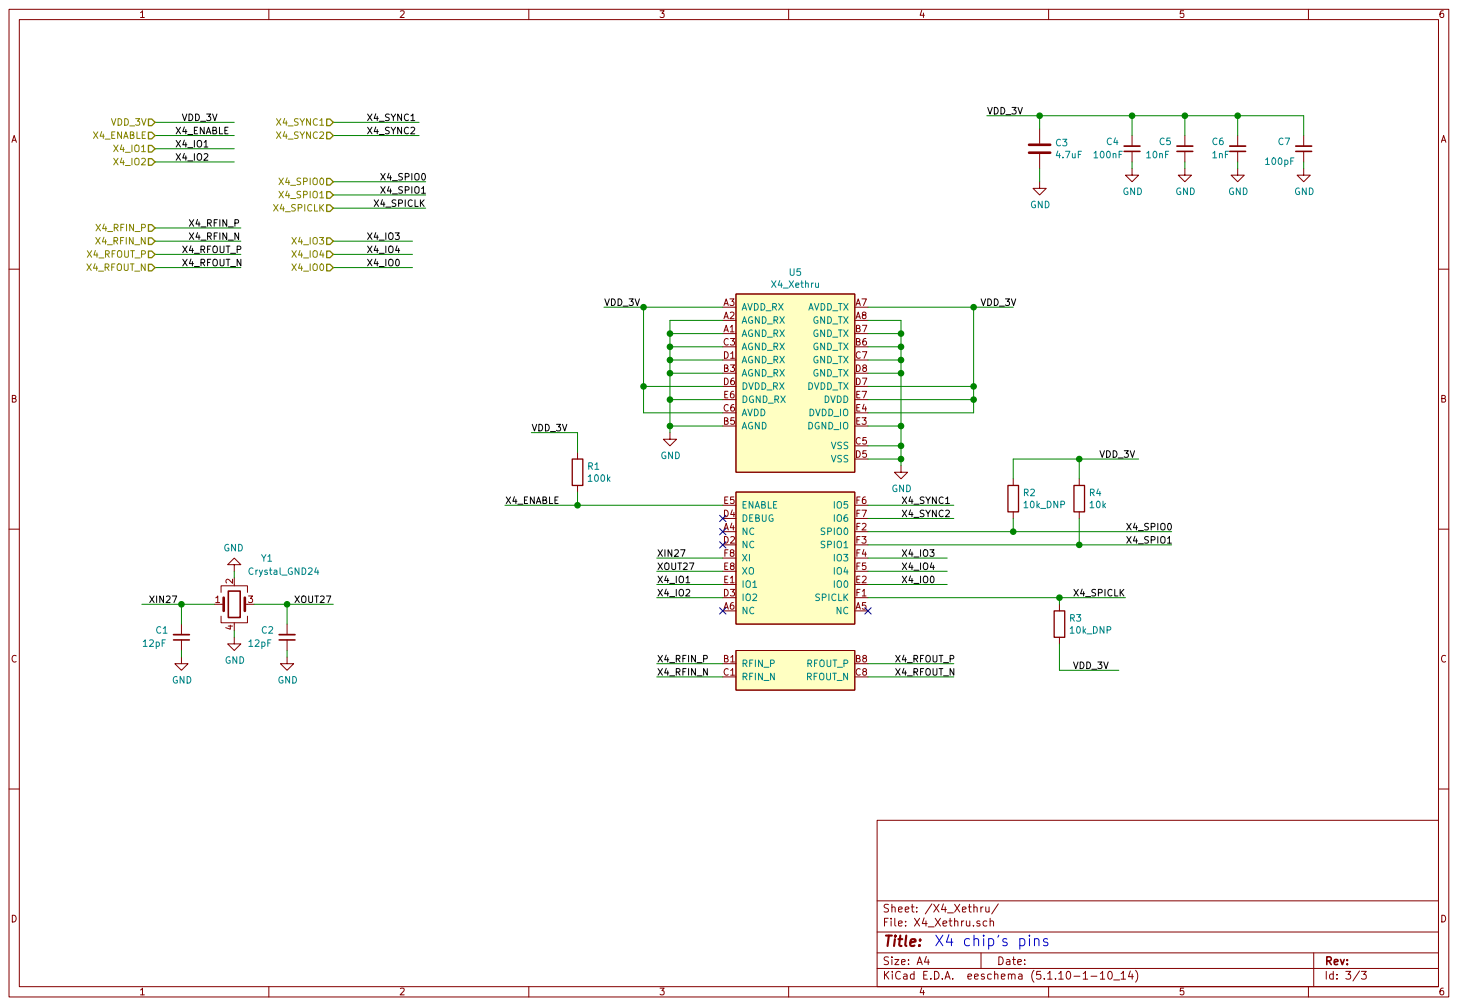
[picture p32: page 3]
