DeepWiSe888/Octopus/hardware/sch/X4_ArrayUnit.pdf

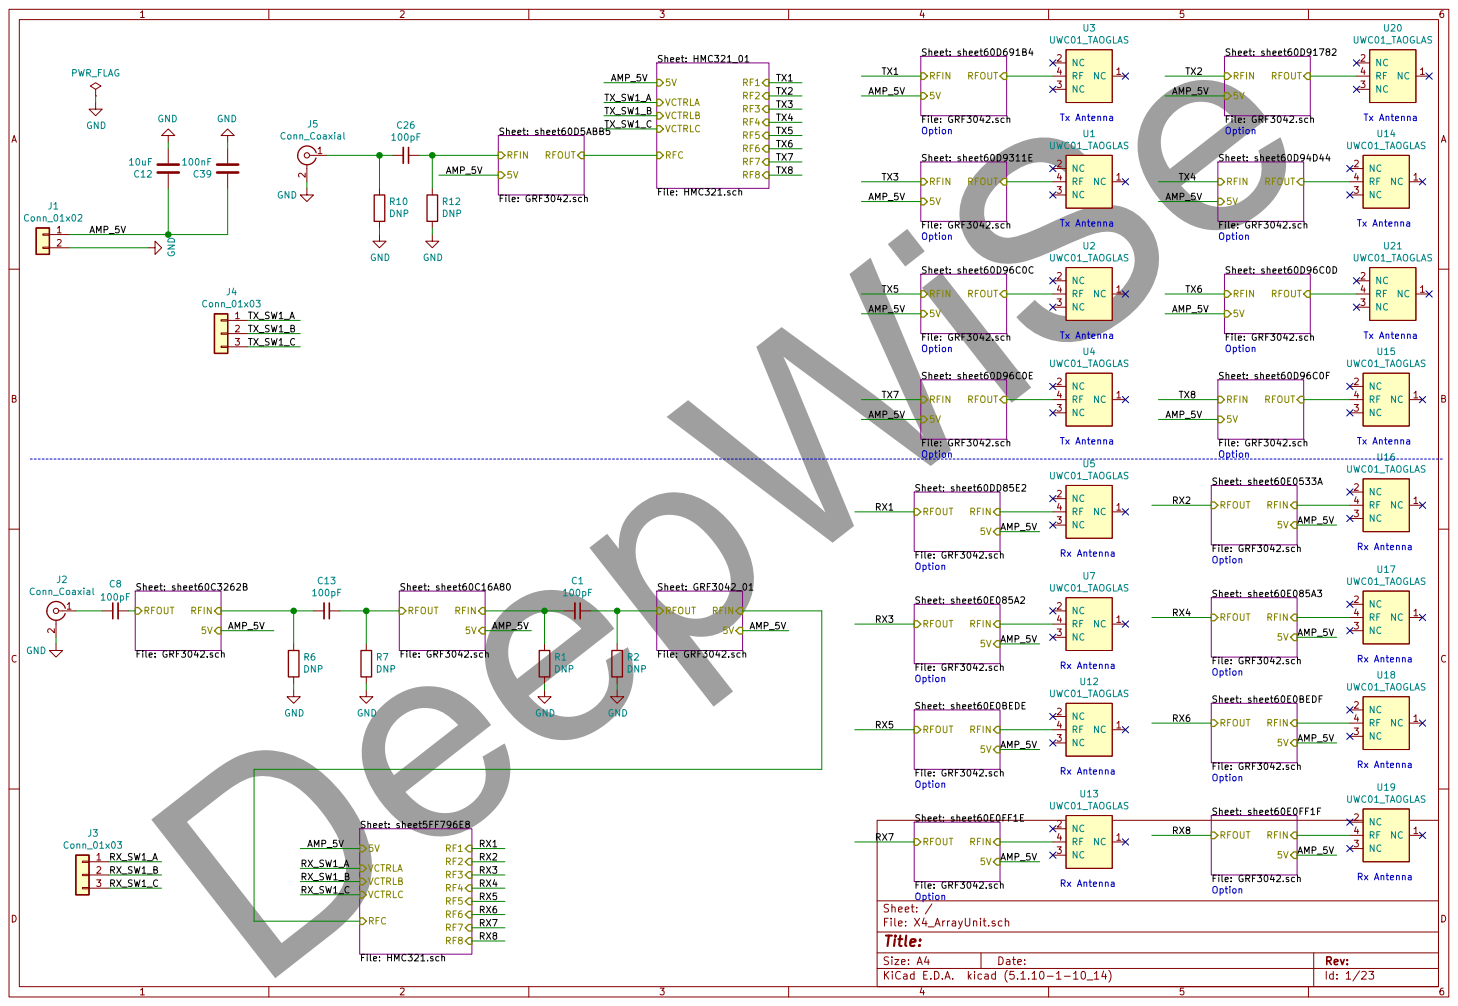
[picture p33: page 1]

2 J5 Conn_Coaxial NC 1 NC 2 NC 3 RF 4 U3 UWC01_TAOGLAS GND

File: X4_ArrayUnit.sch Sheet: / Sheet: sheet60C16A80 File: GRF3042.sch

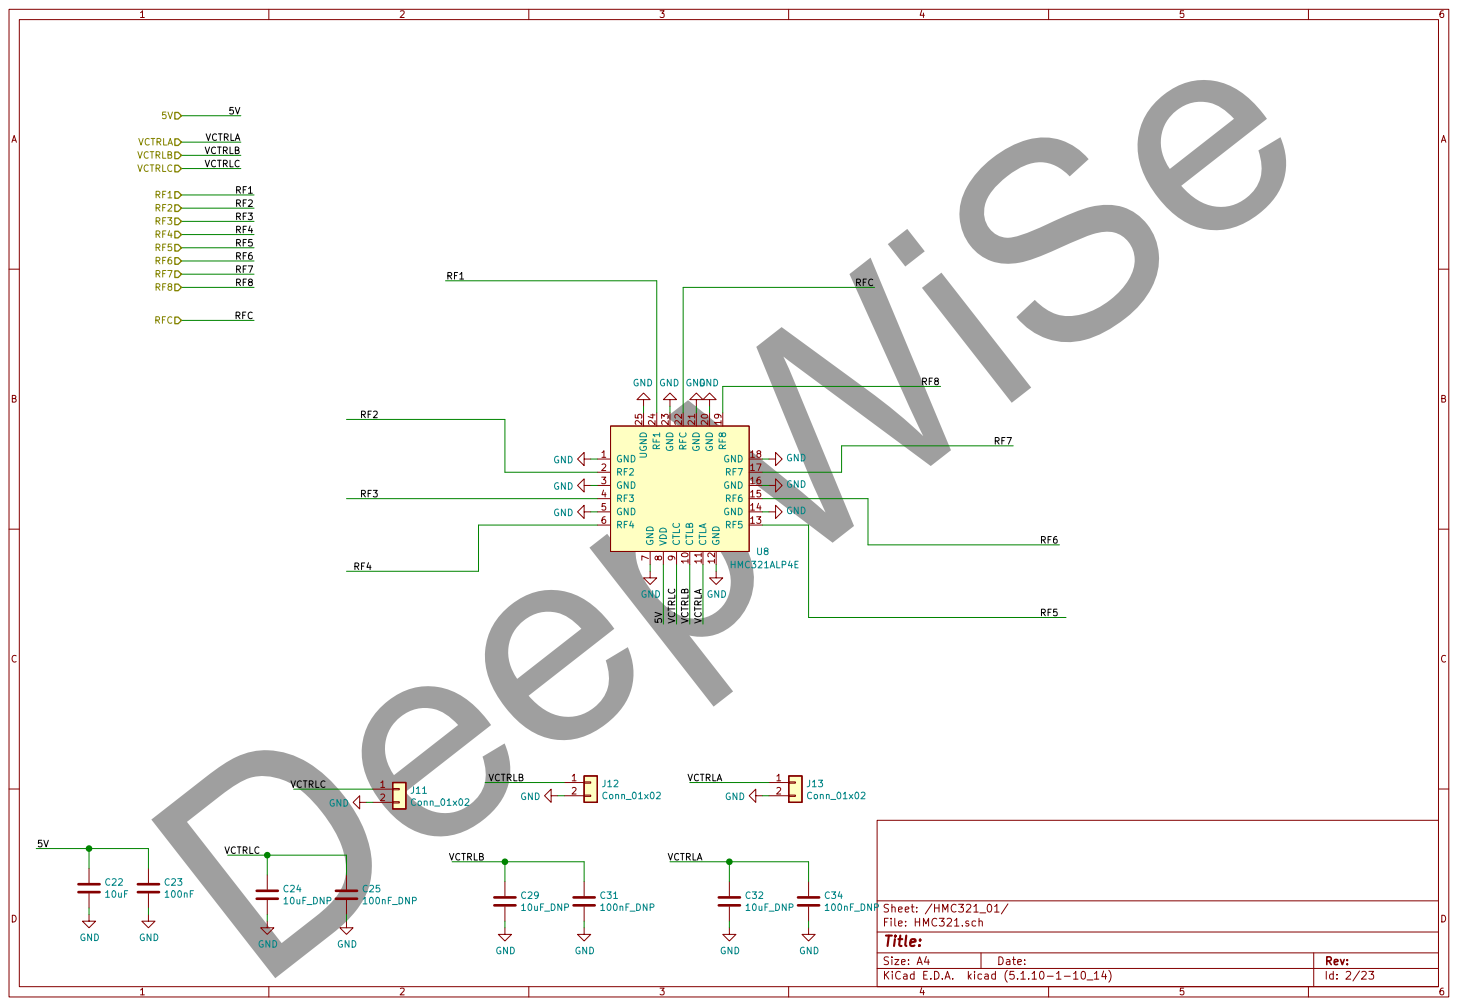
[picture p34: page 2]

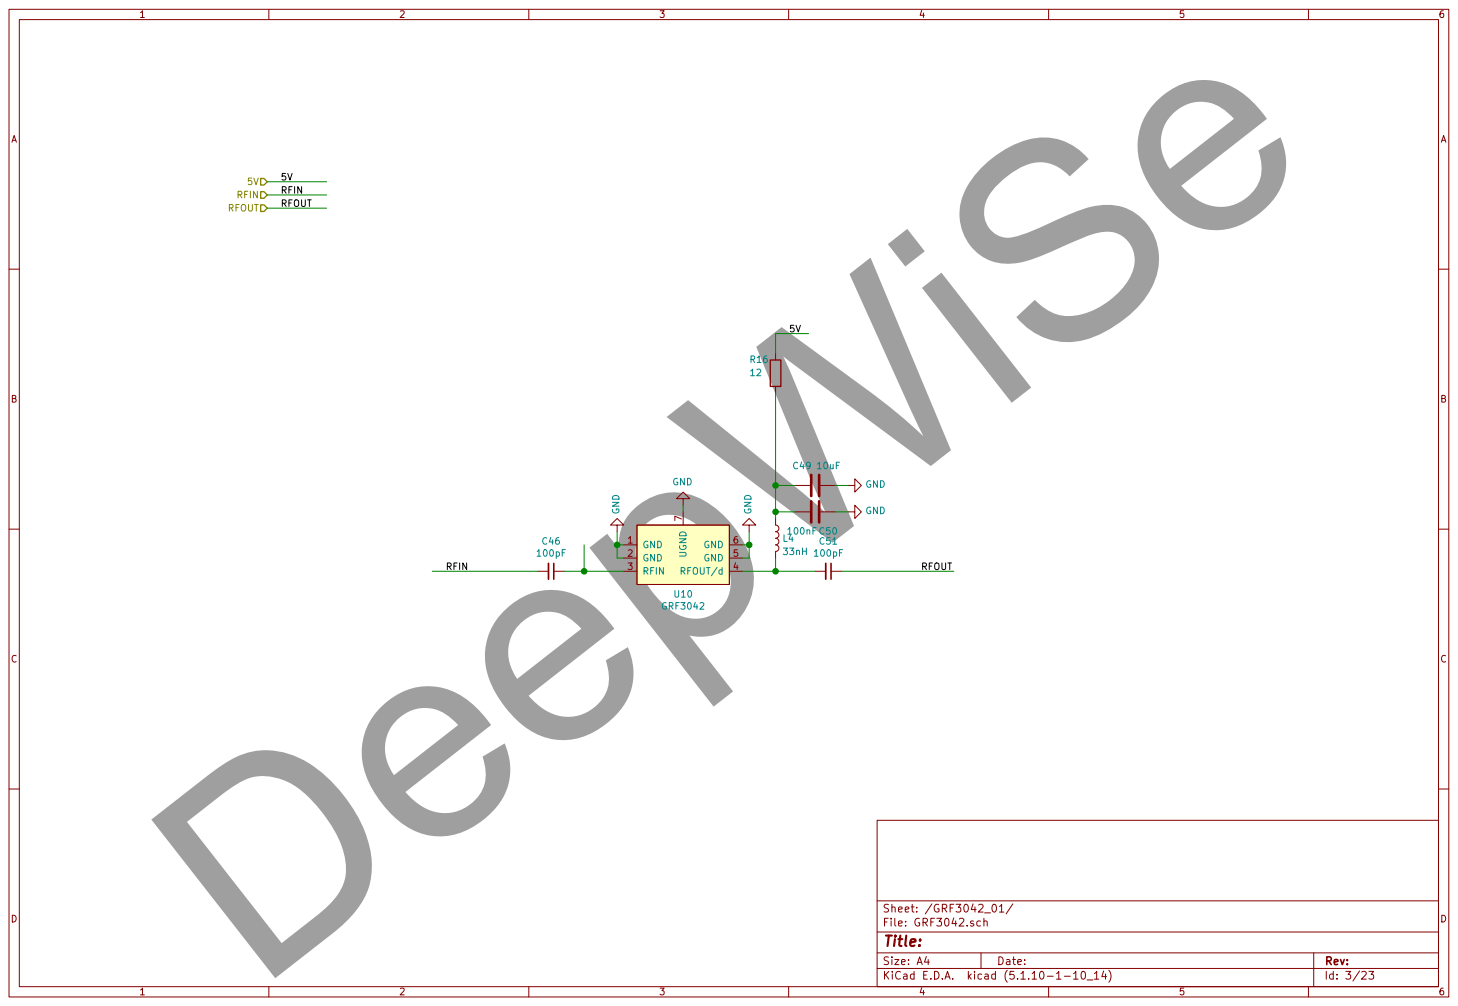
[picture p35: page 3]

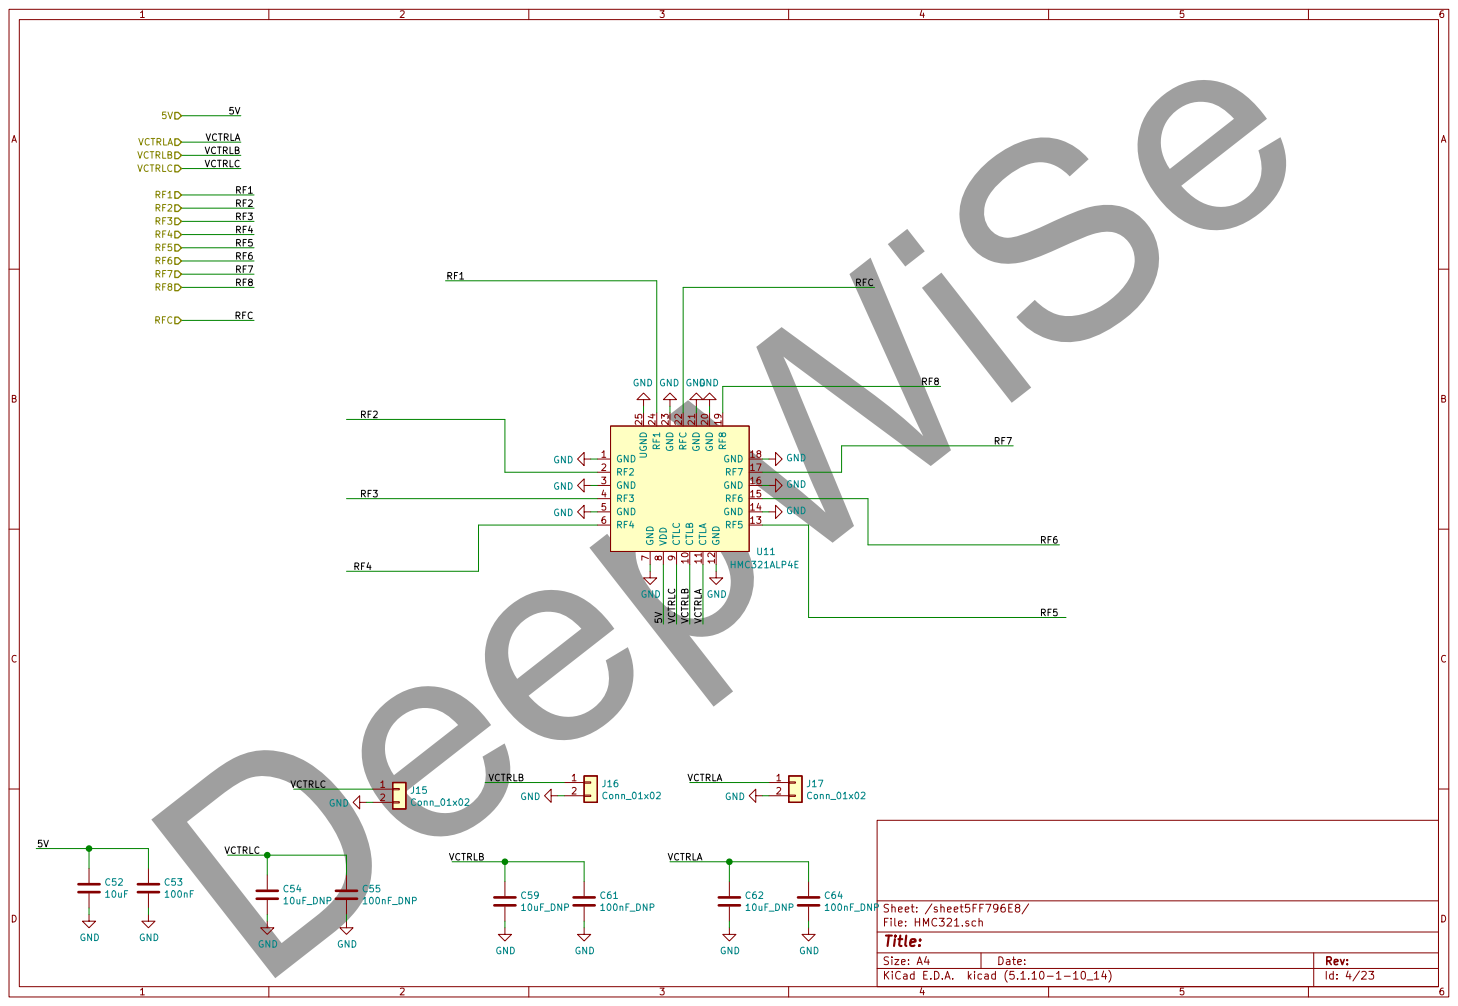
[picture p36: page 4]

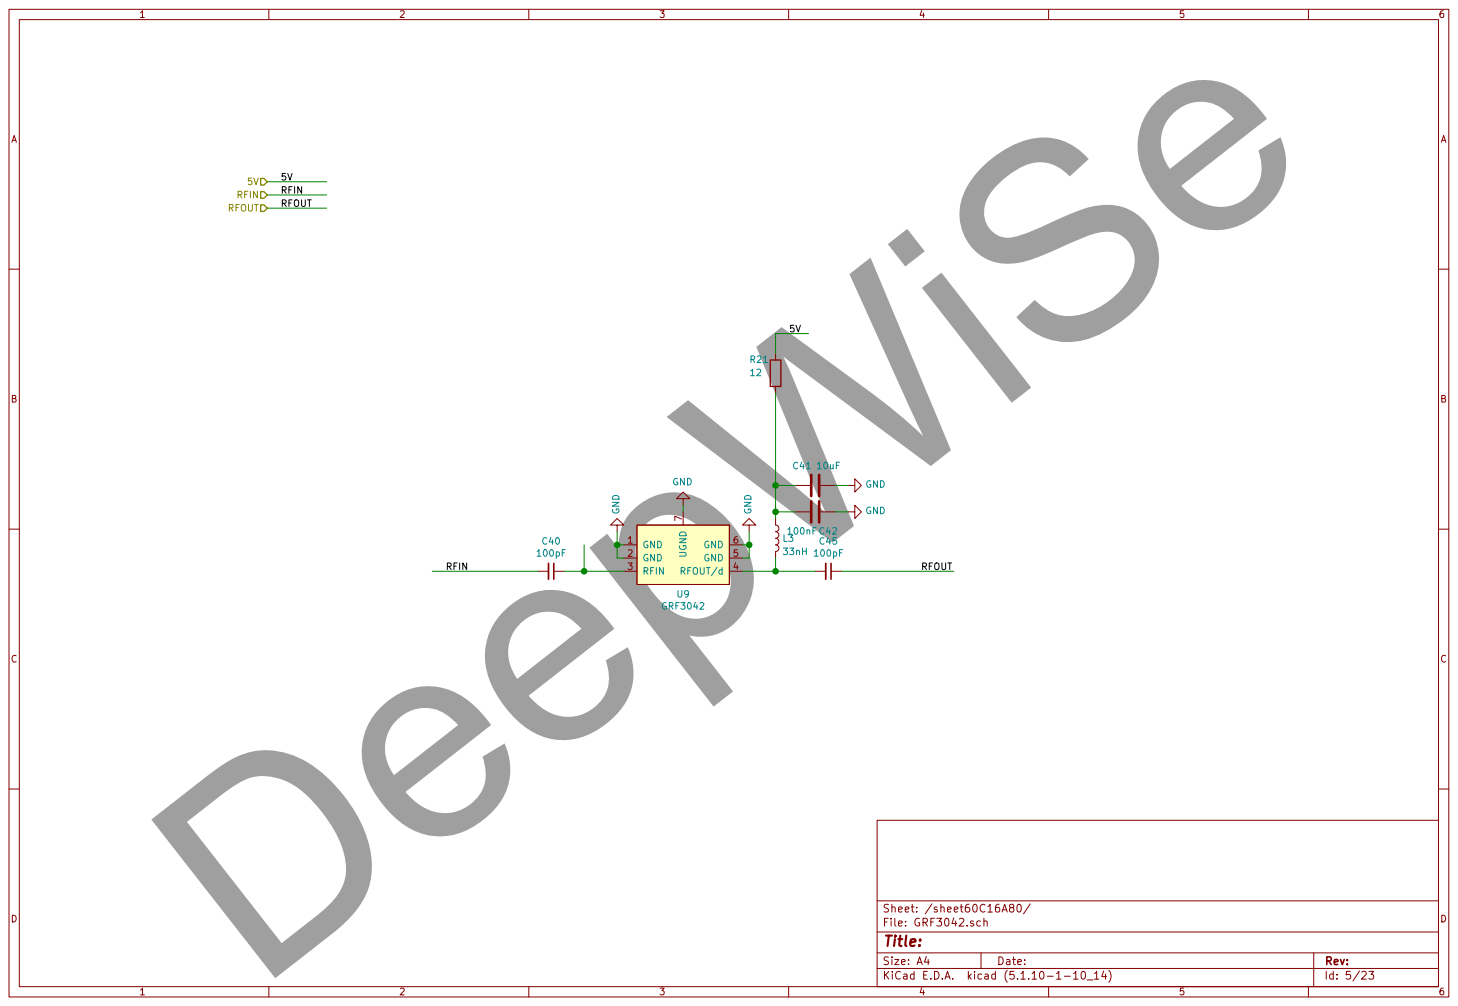
[picture p37: page 5]

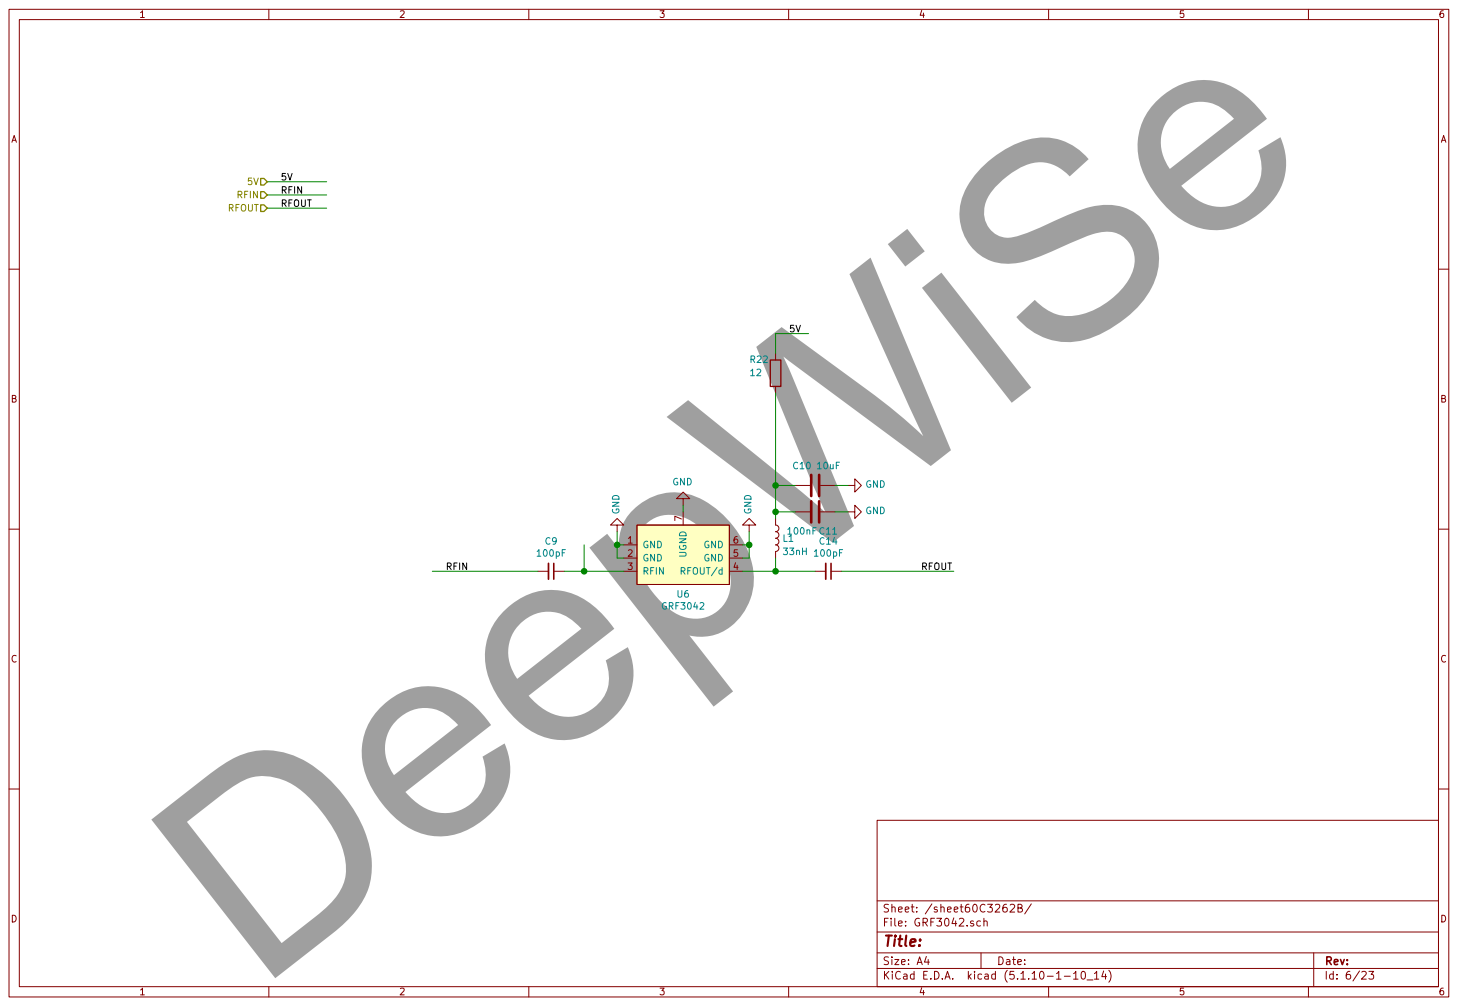
[picture p38: page 6]

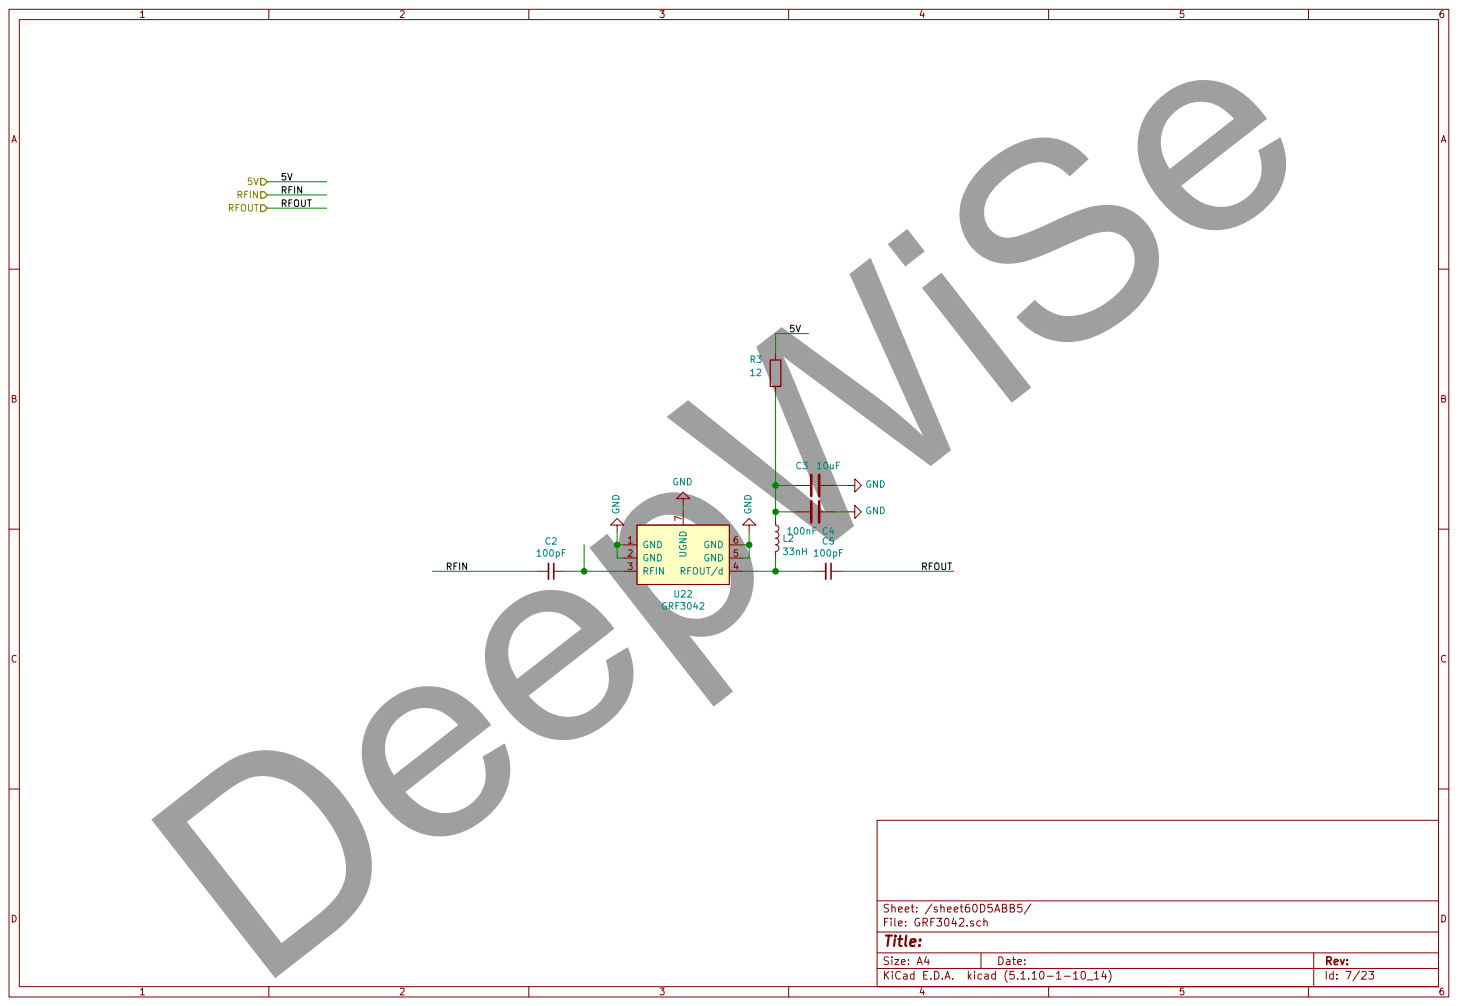
[picture p39: page 7]

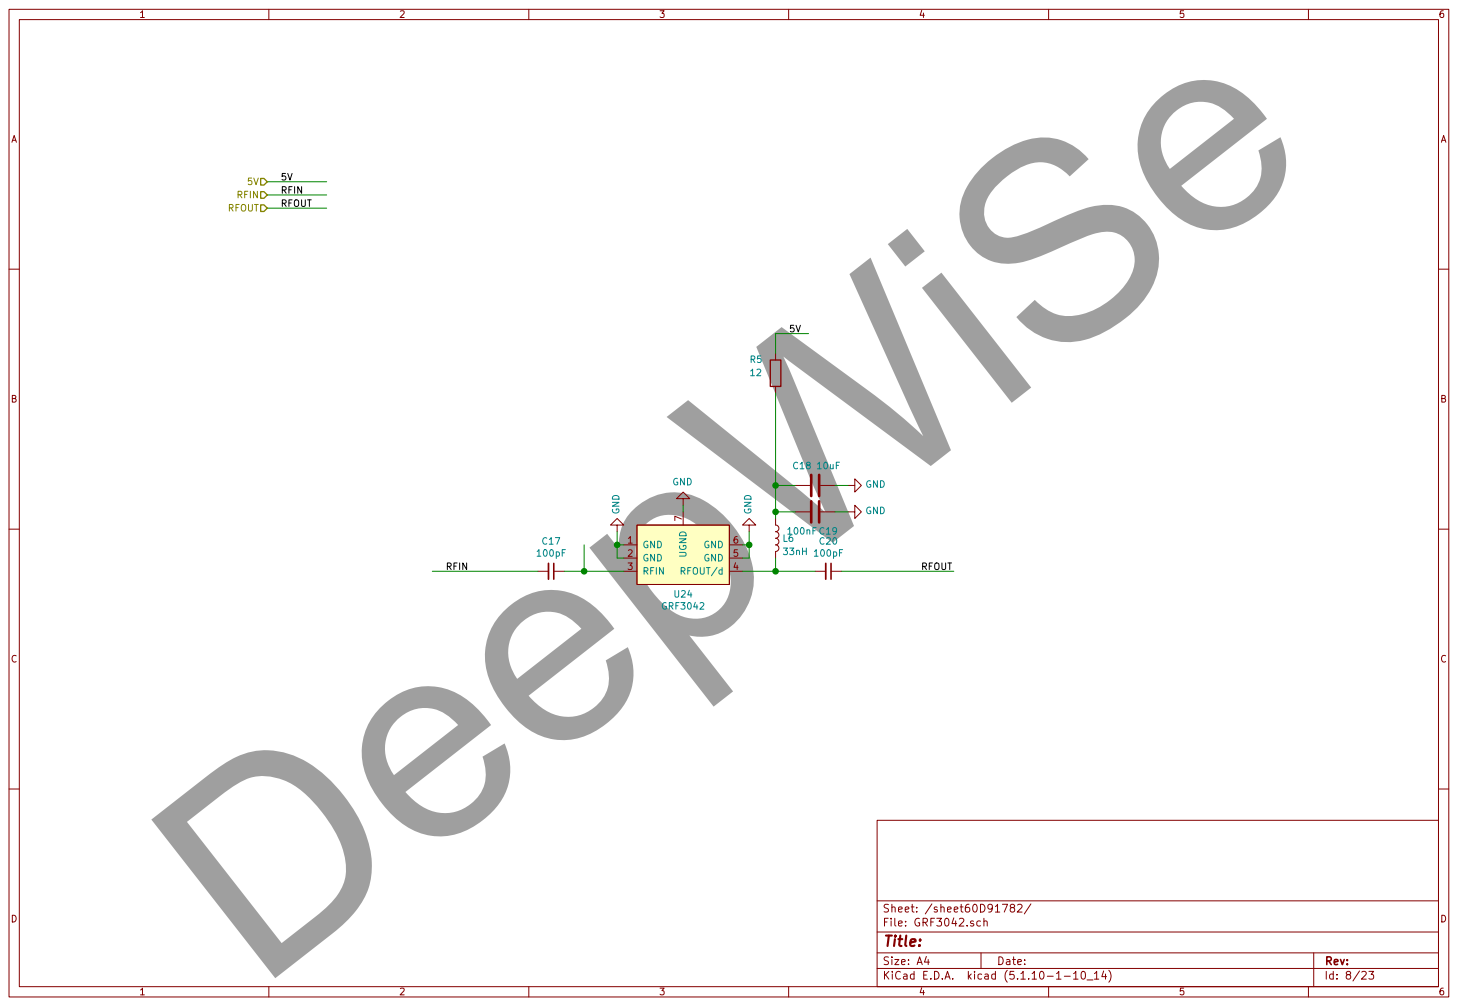
[picture p40: page 8]

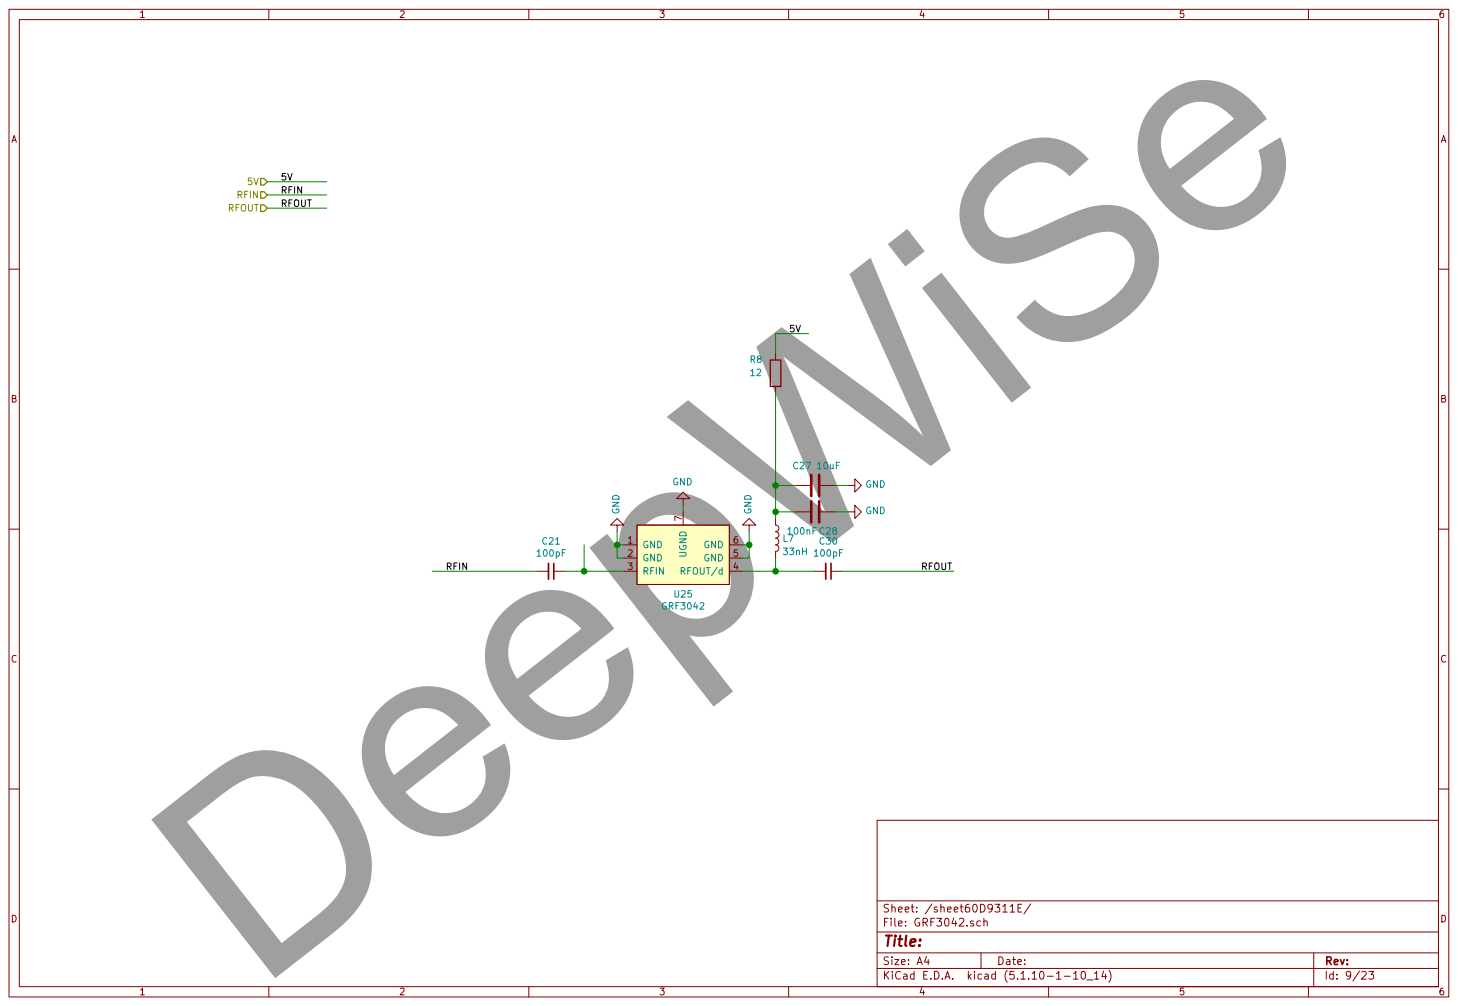
[picture p41: page 9]

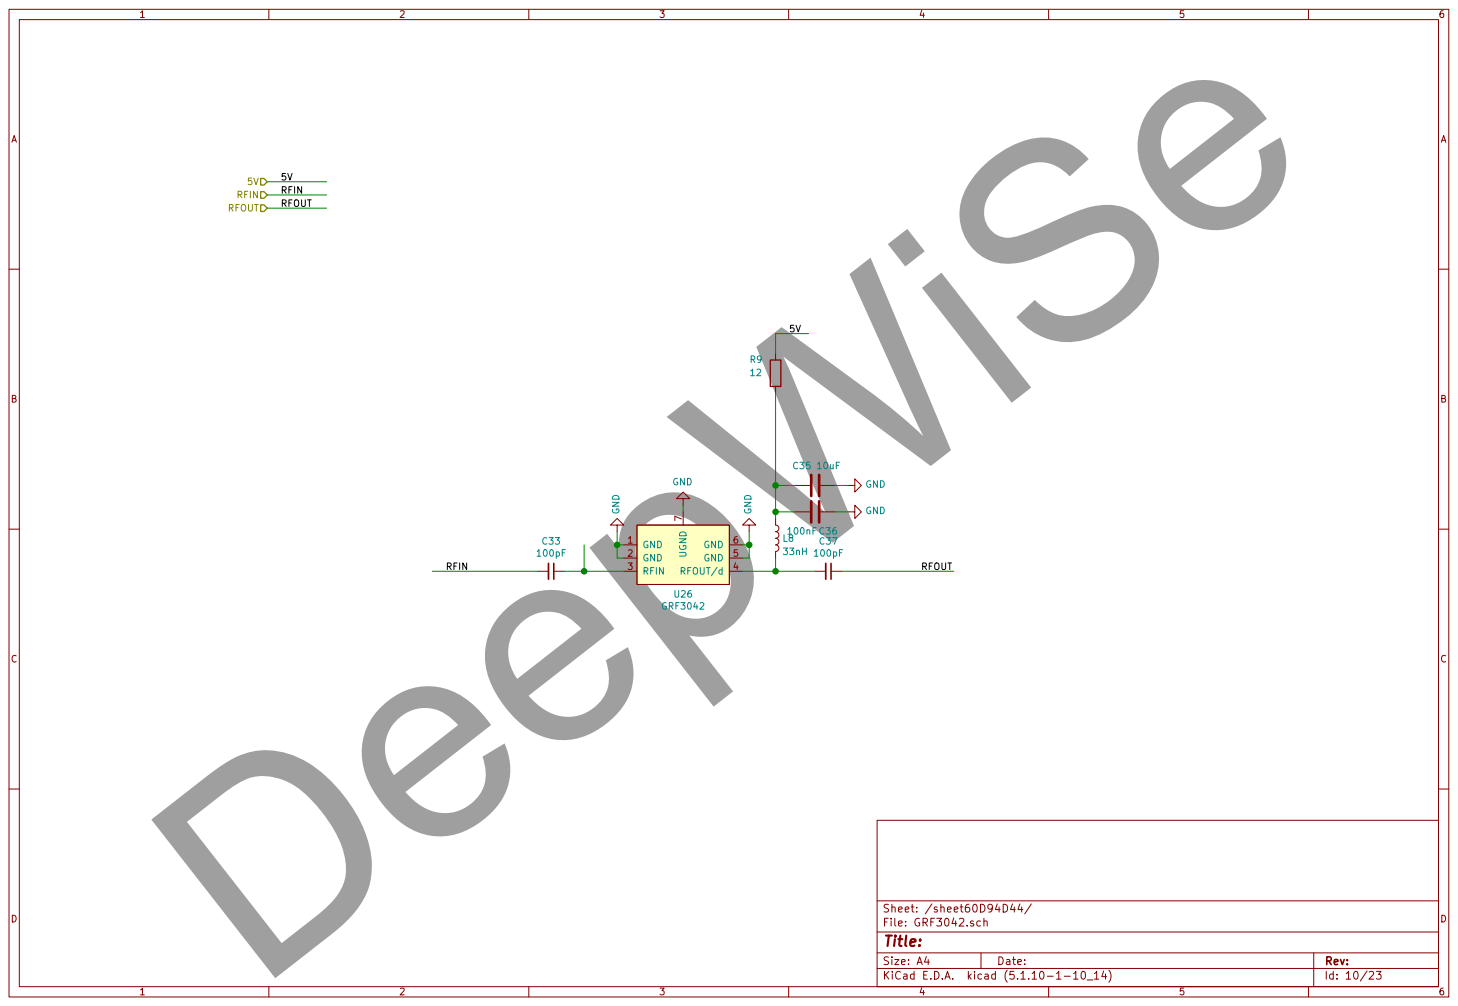
[picture p42: page 10]

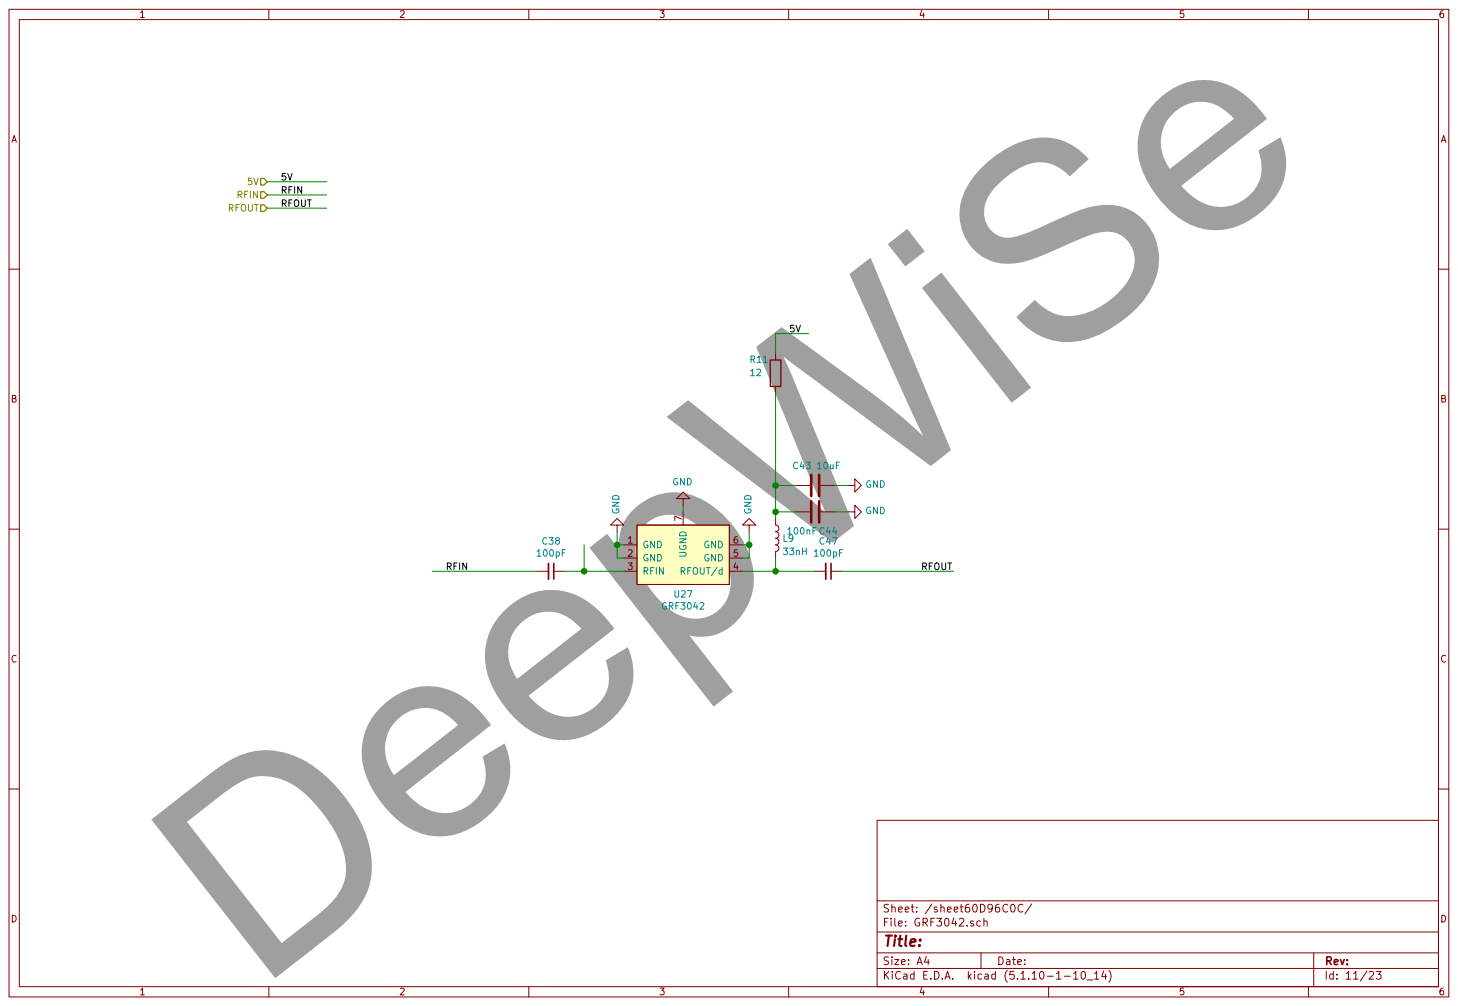
[picture p43: page 11]

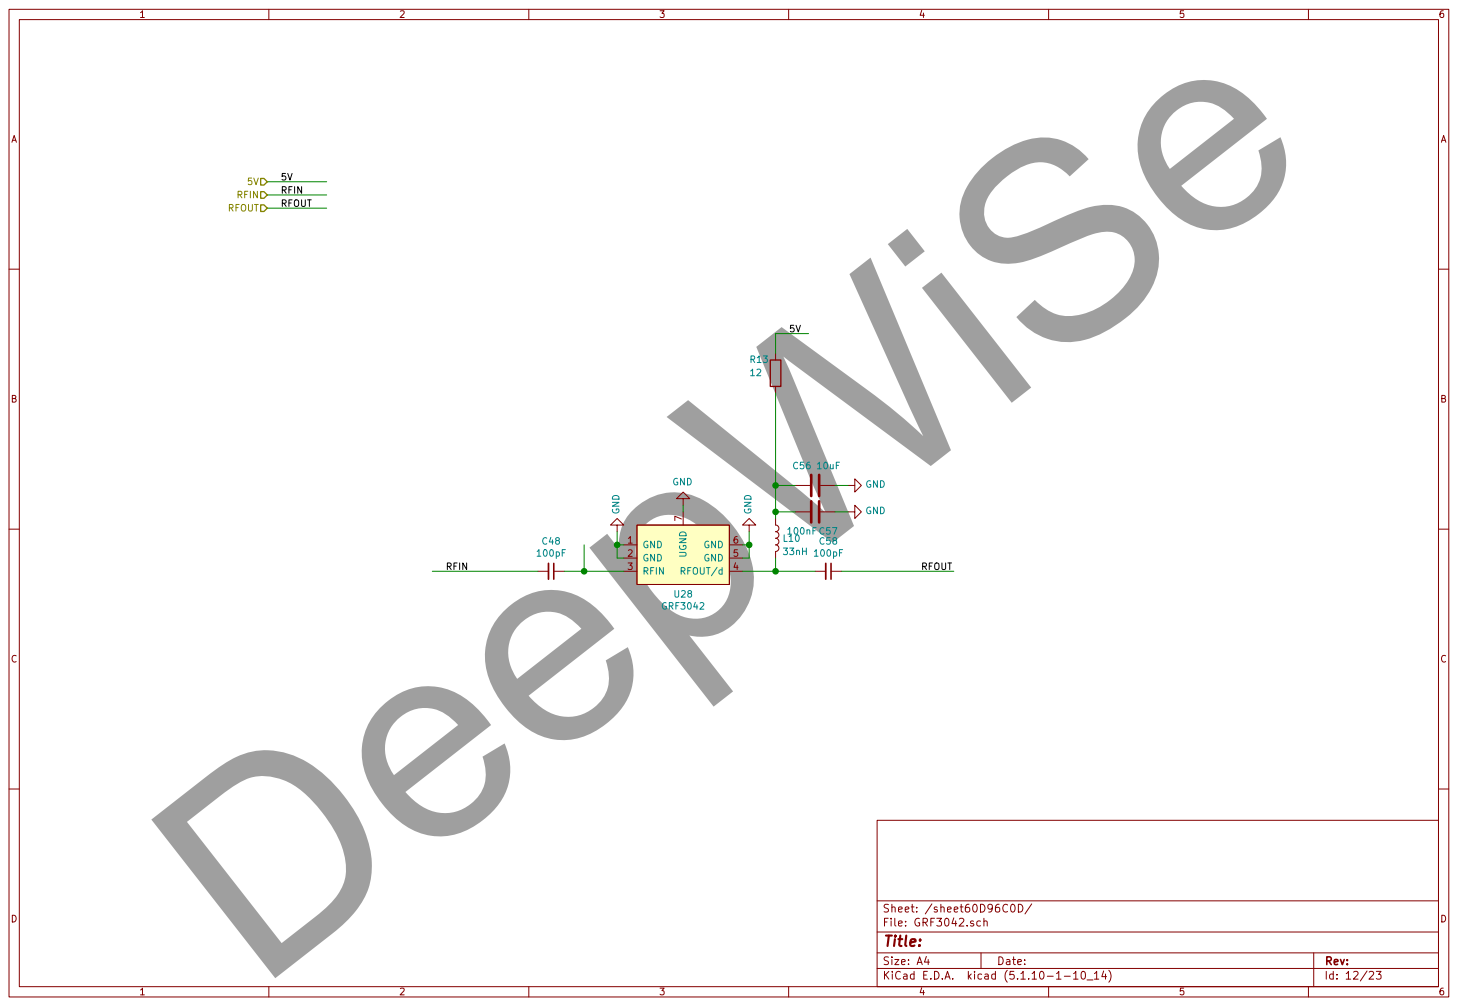
[picture p44: page 12]

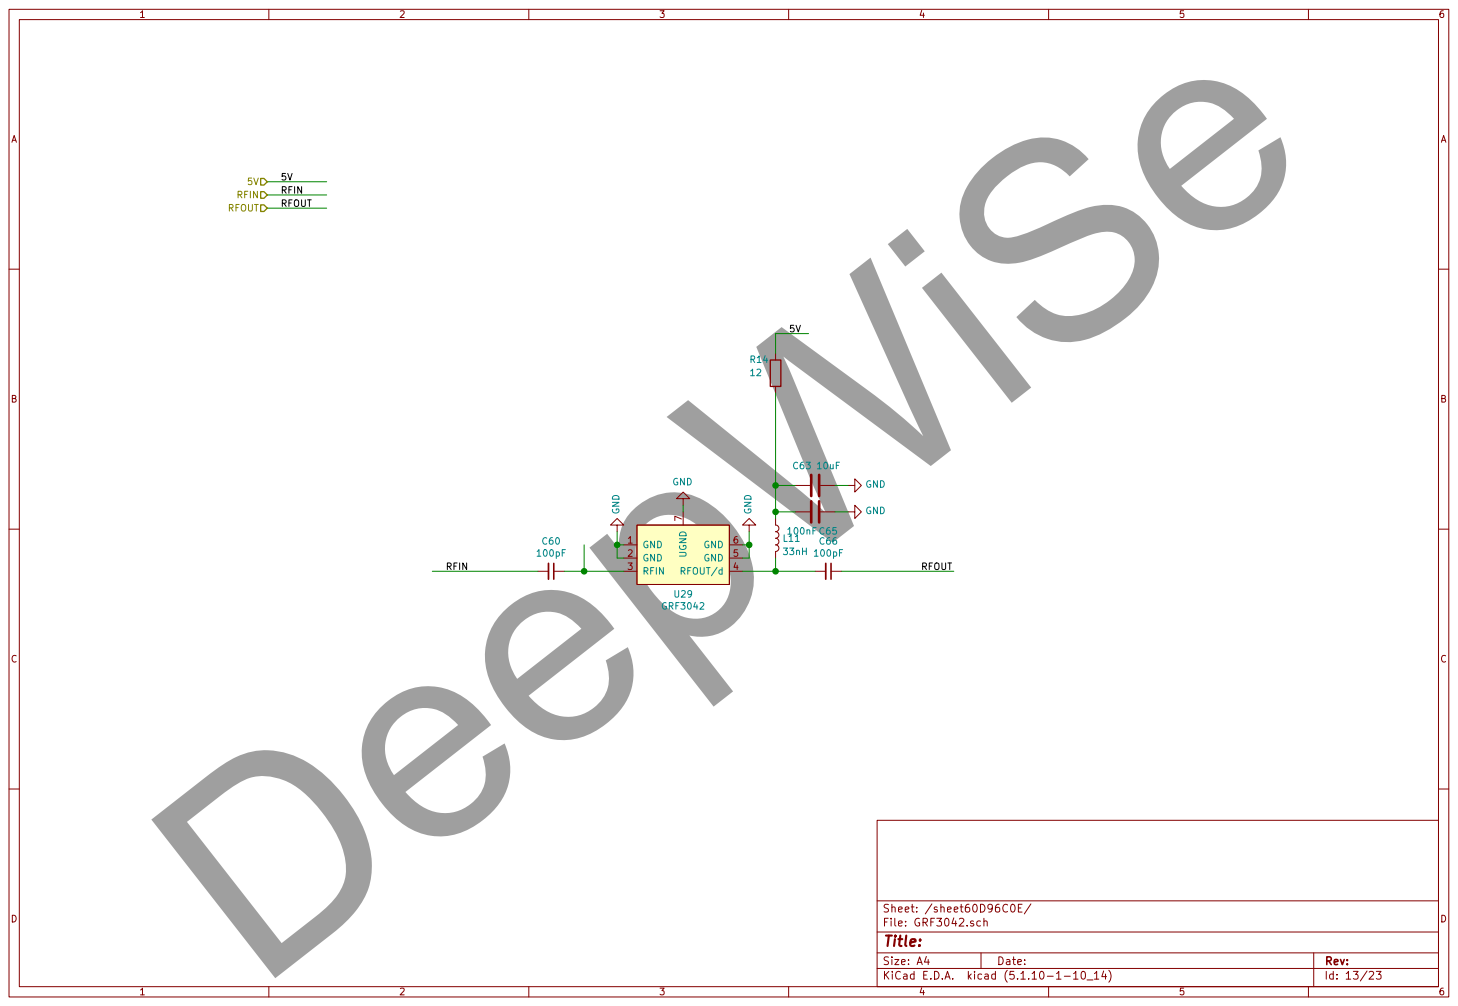
[picture p45: page 13]

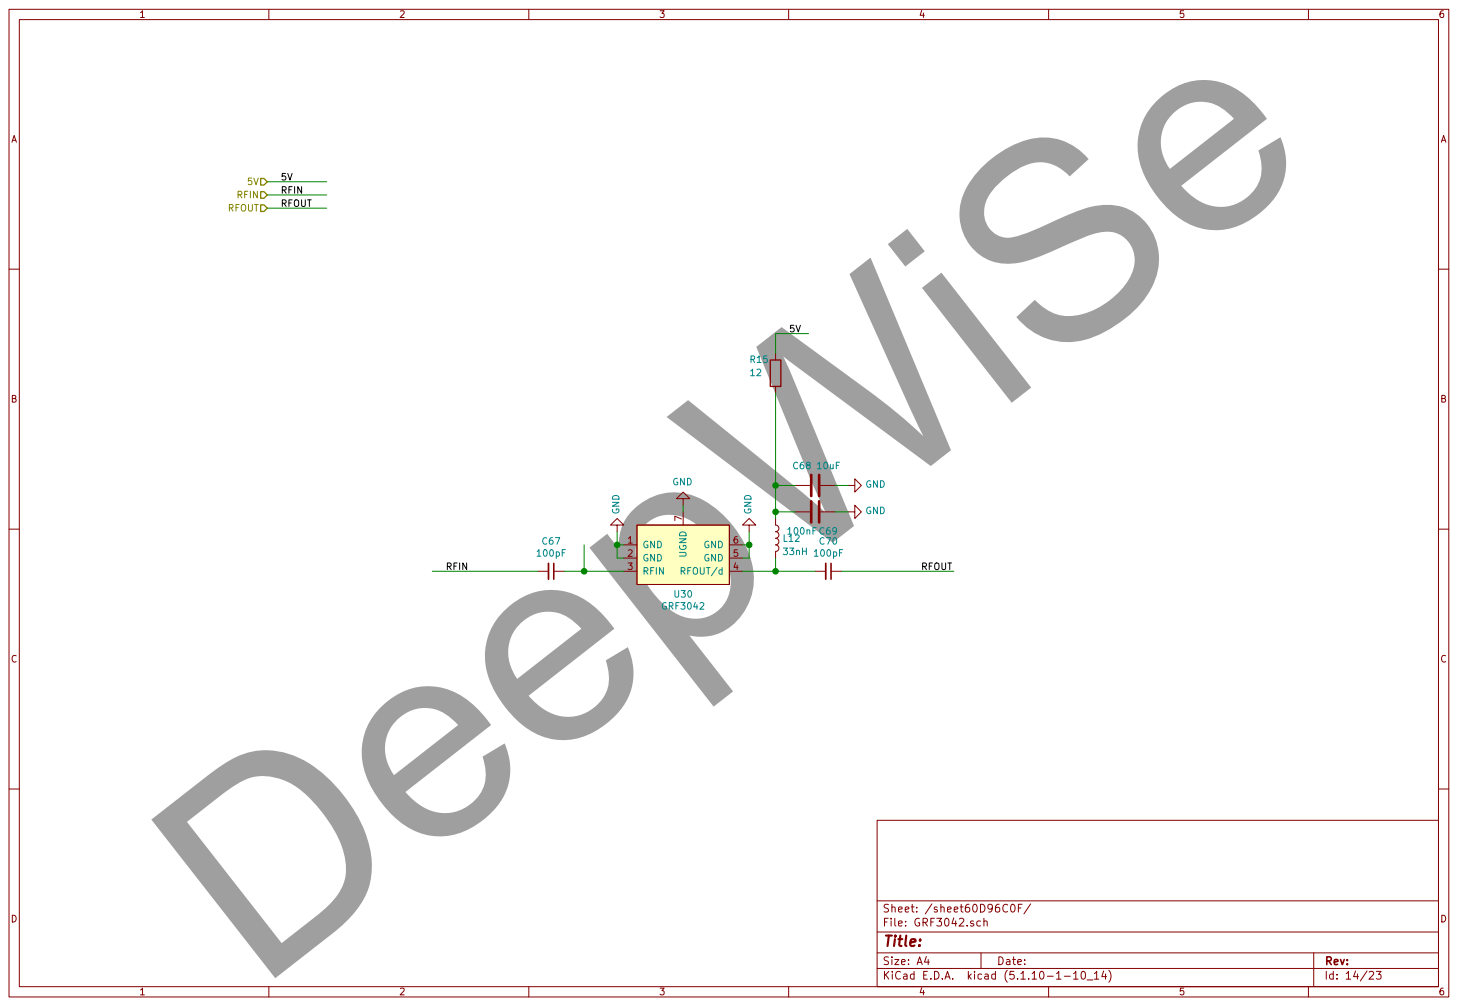
[picture p46: page 14]

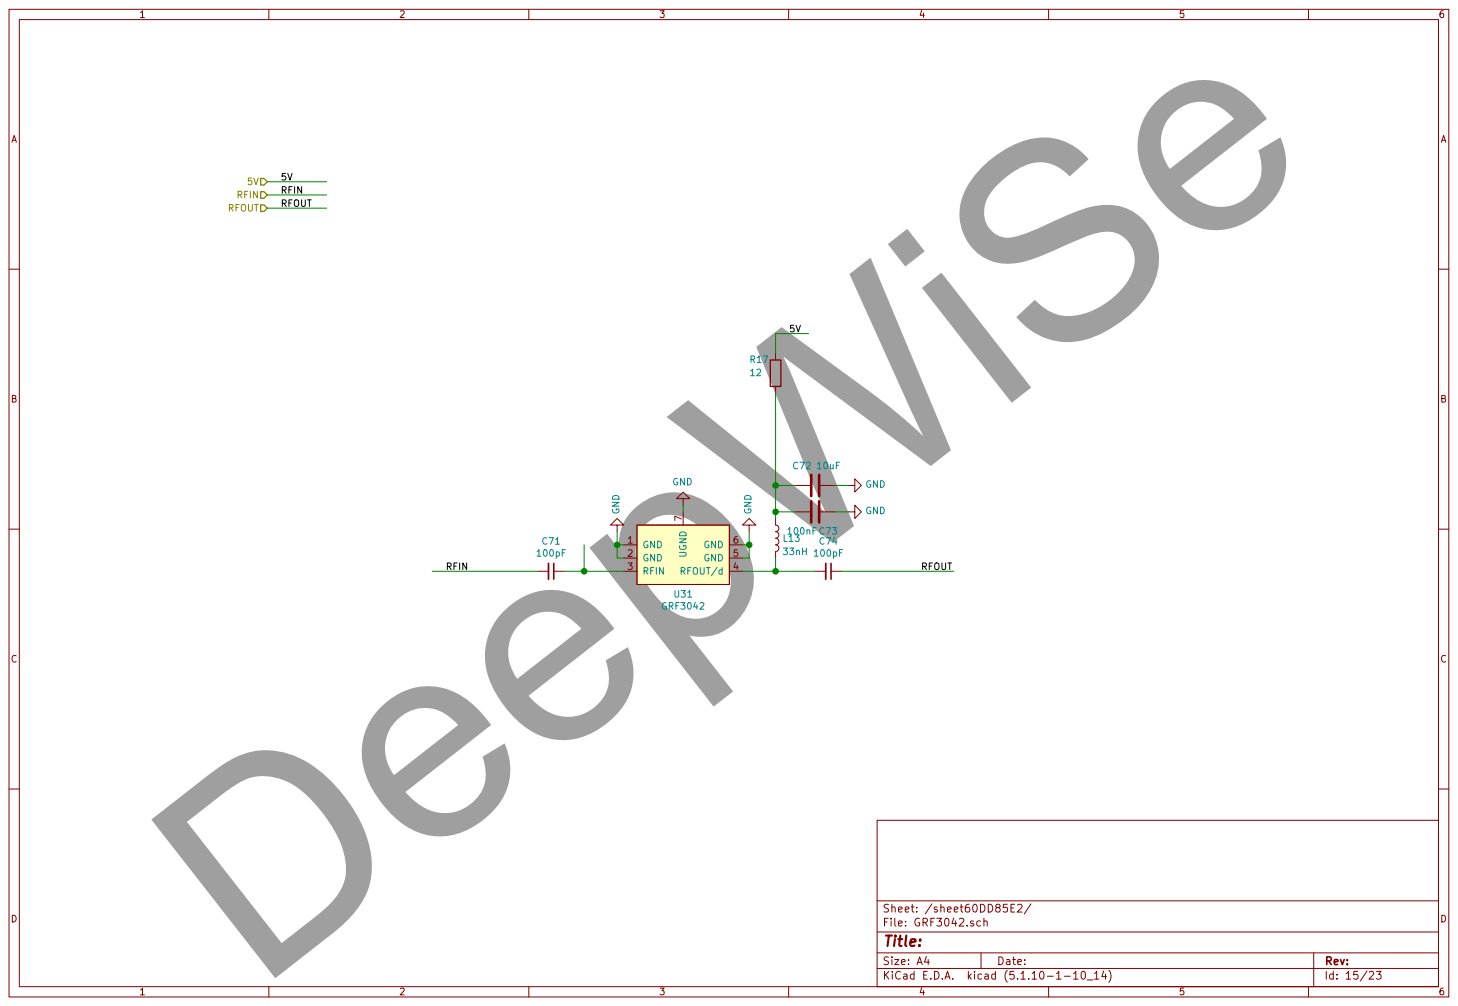
[picture p47: page 15]

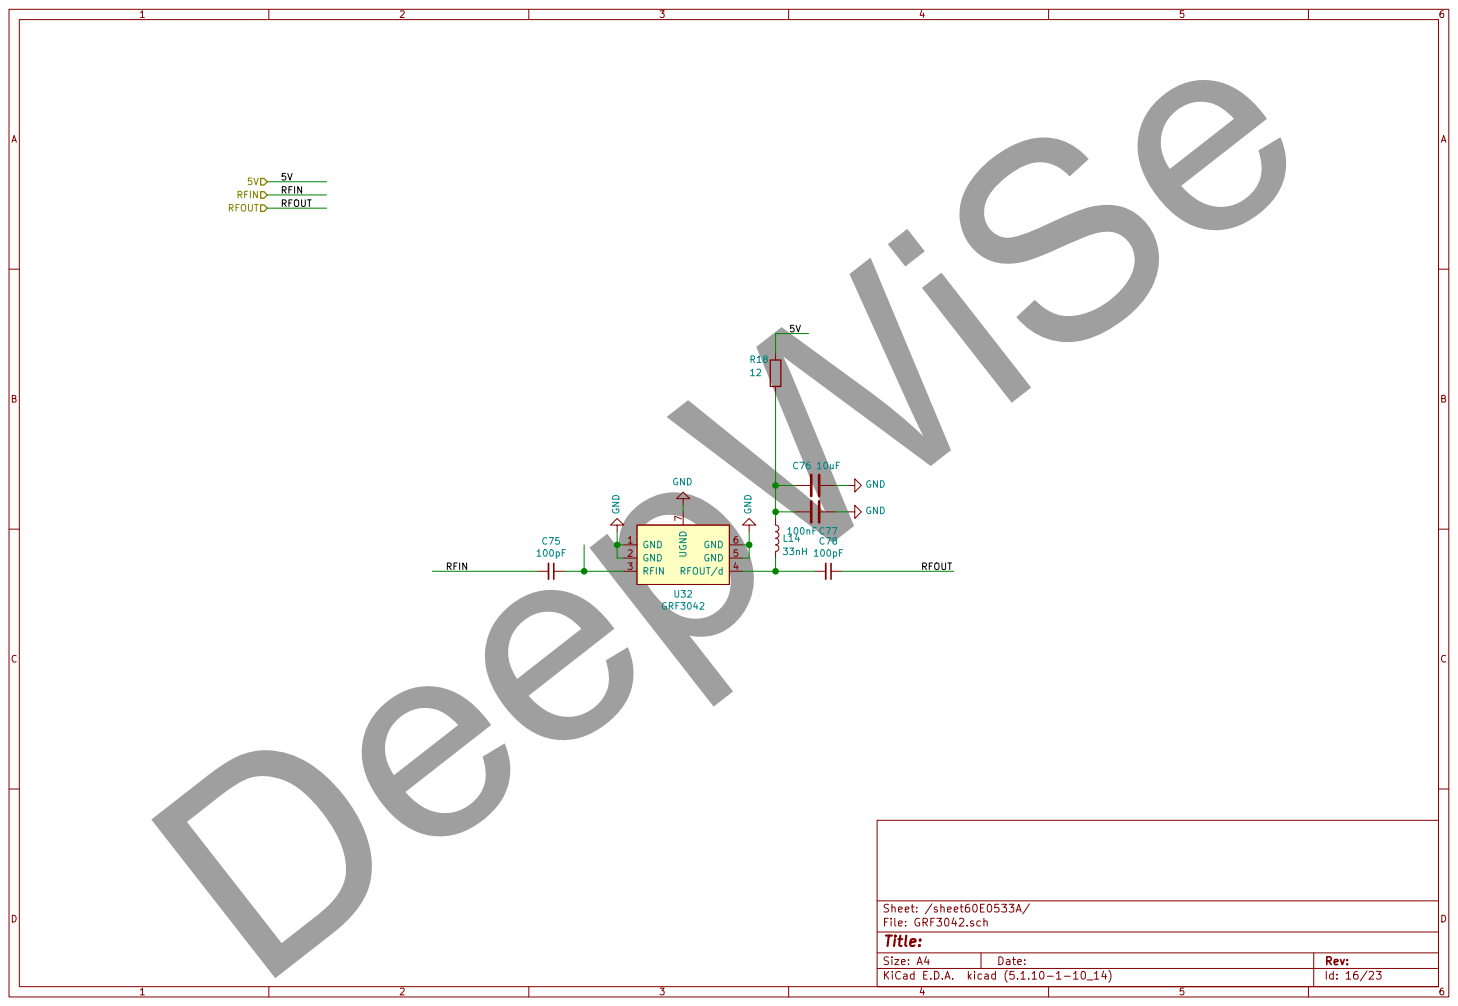
[picture p48: page 16]

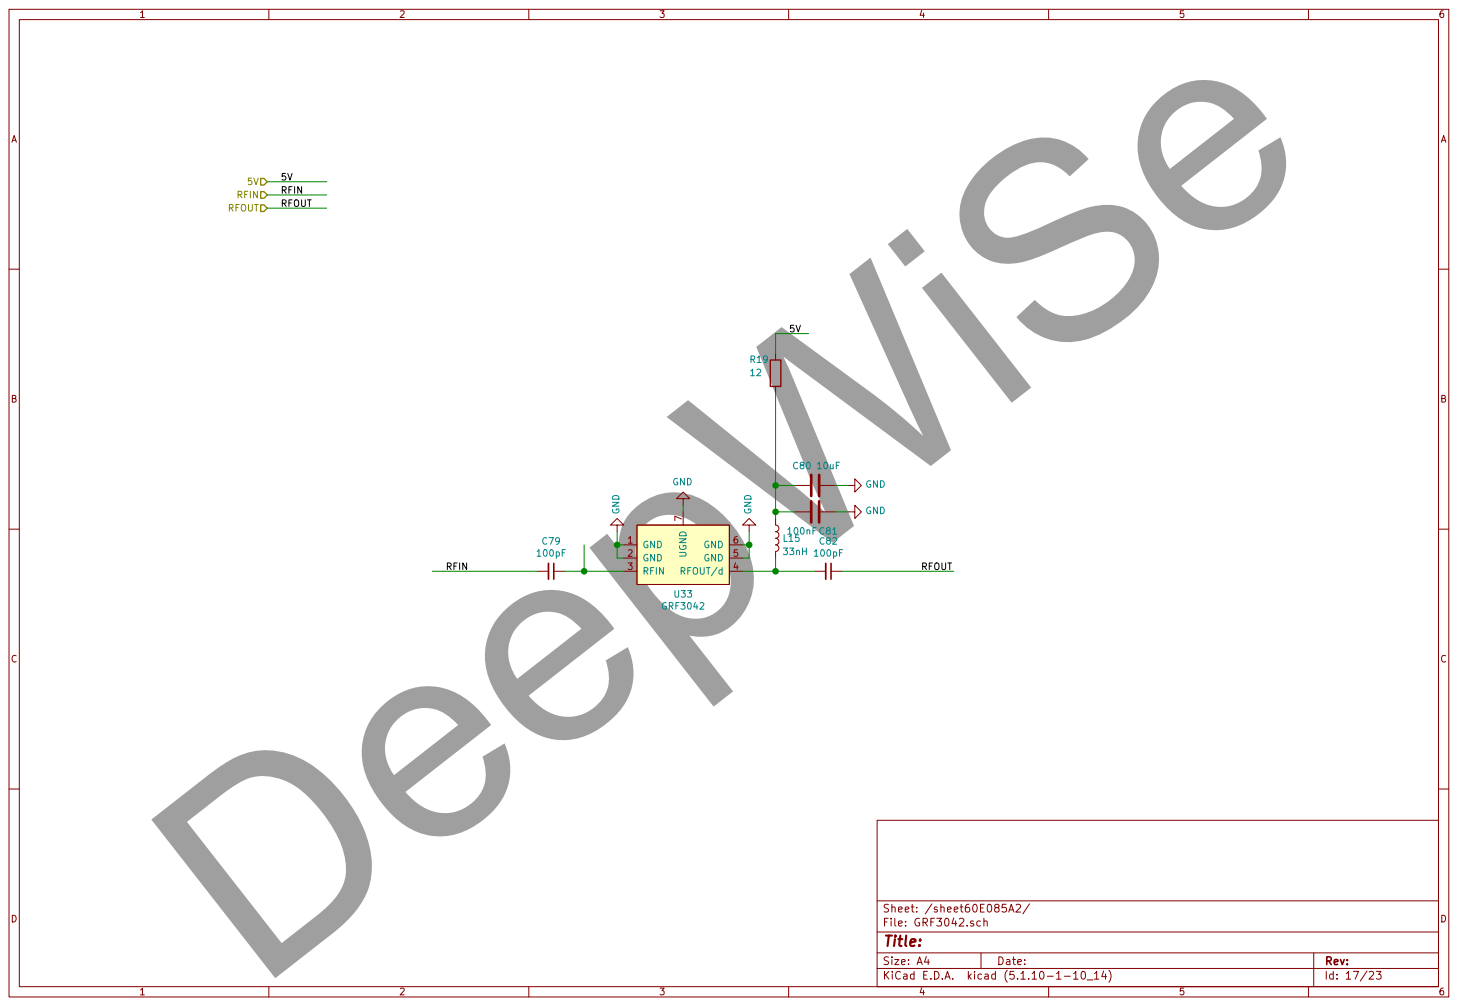
[picture p49: page 17]

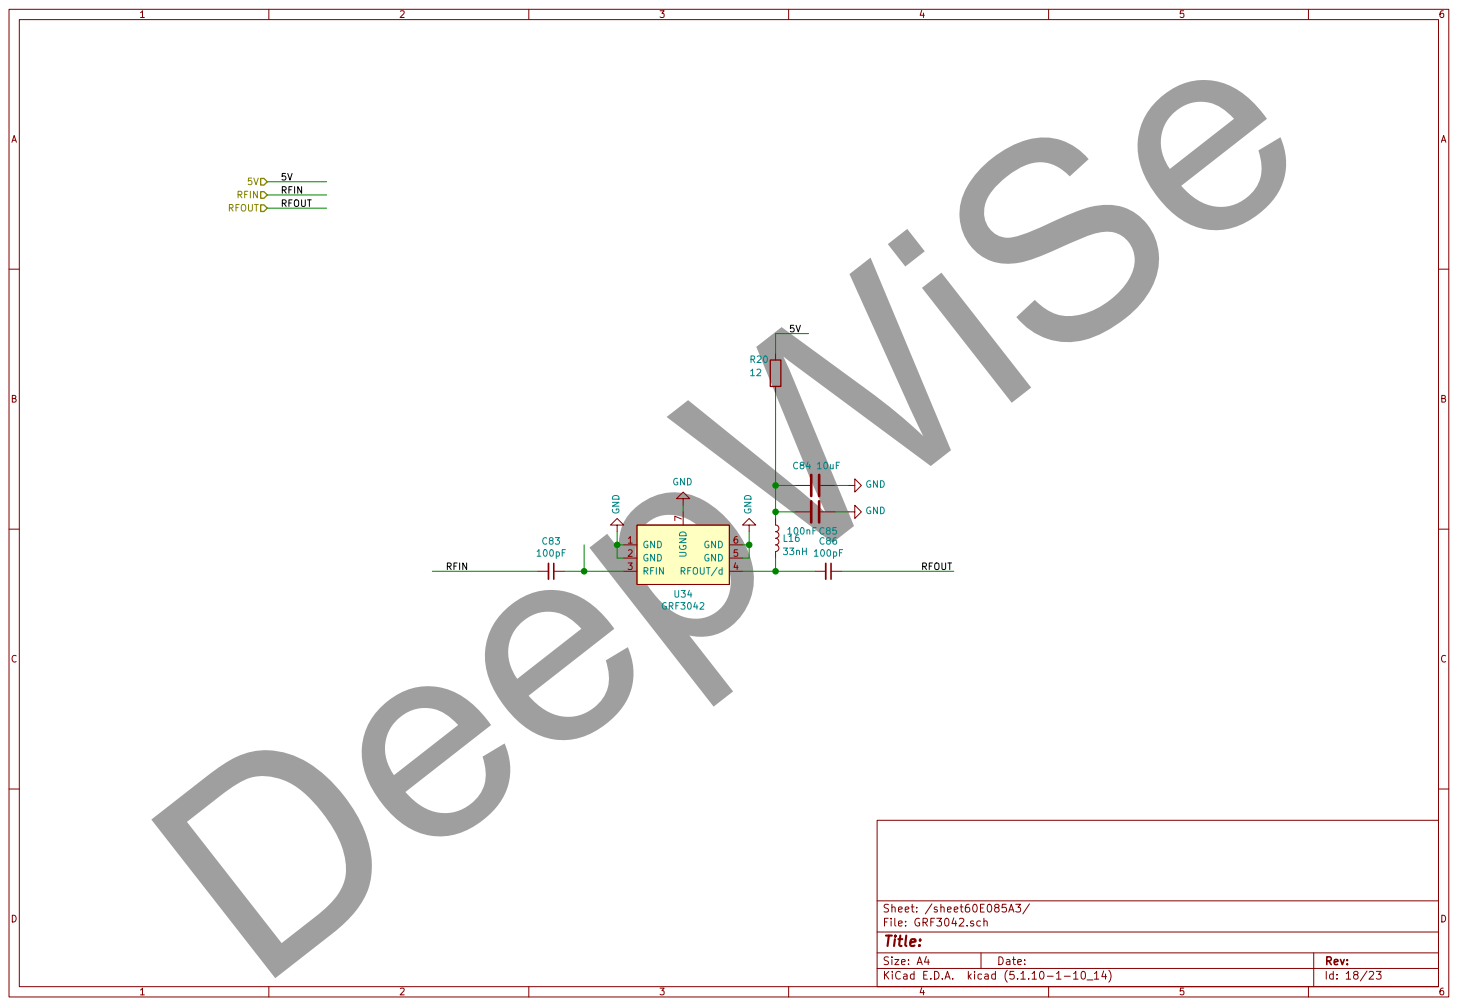
[picture p50: page 18]

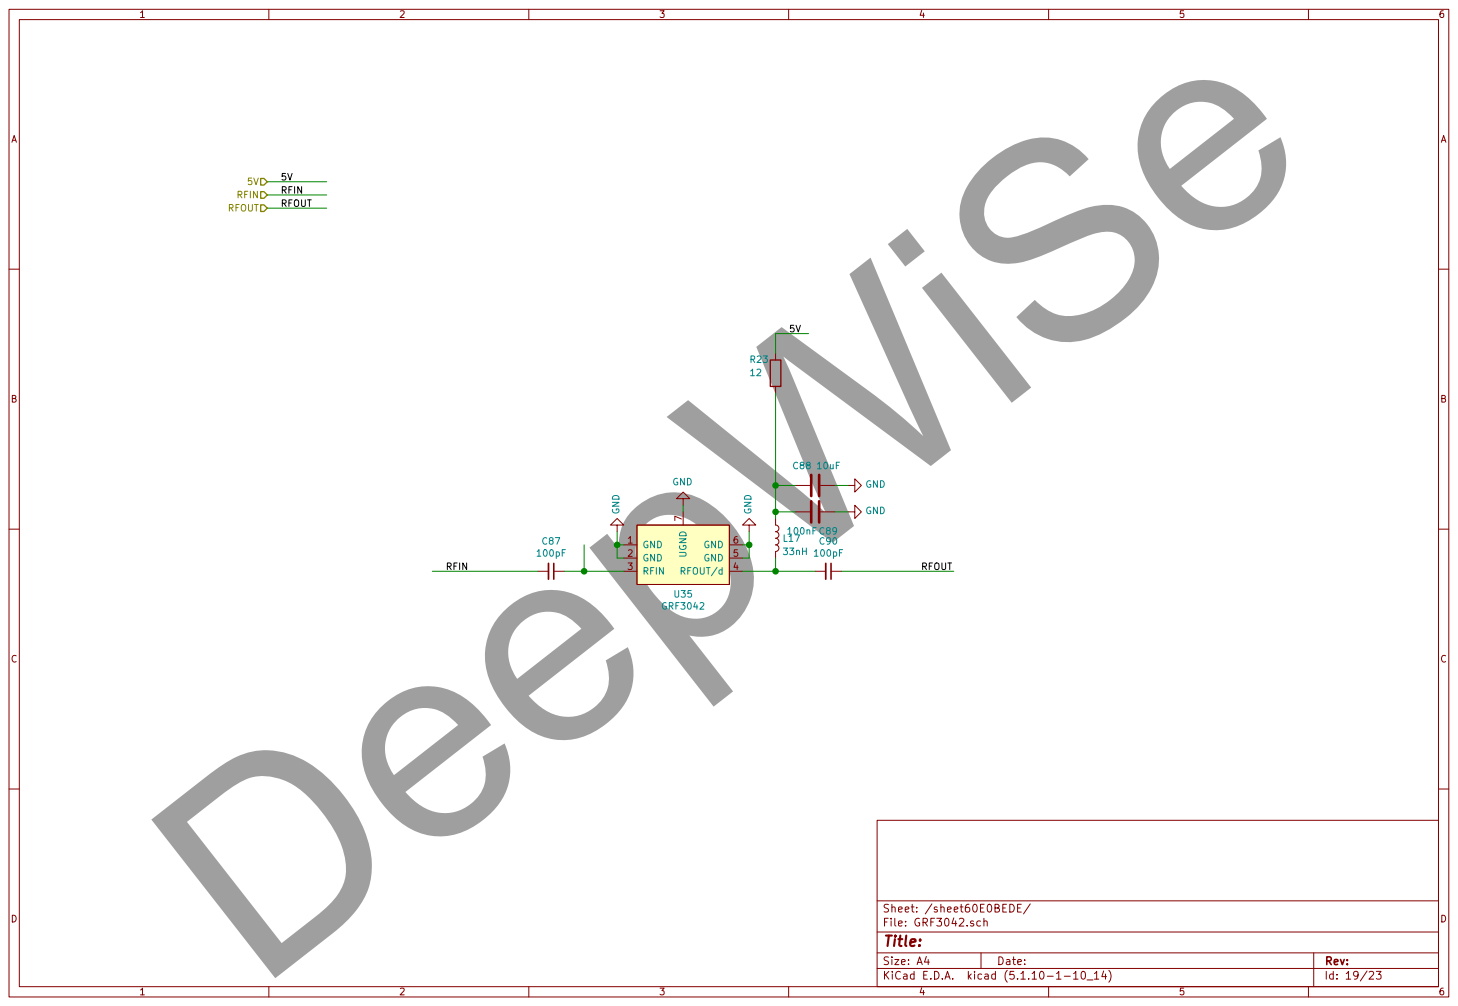
[picture p51: page 19]

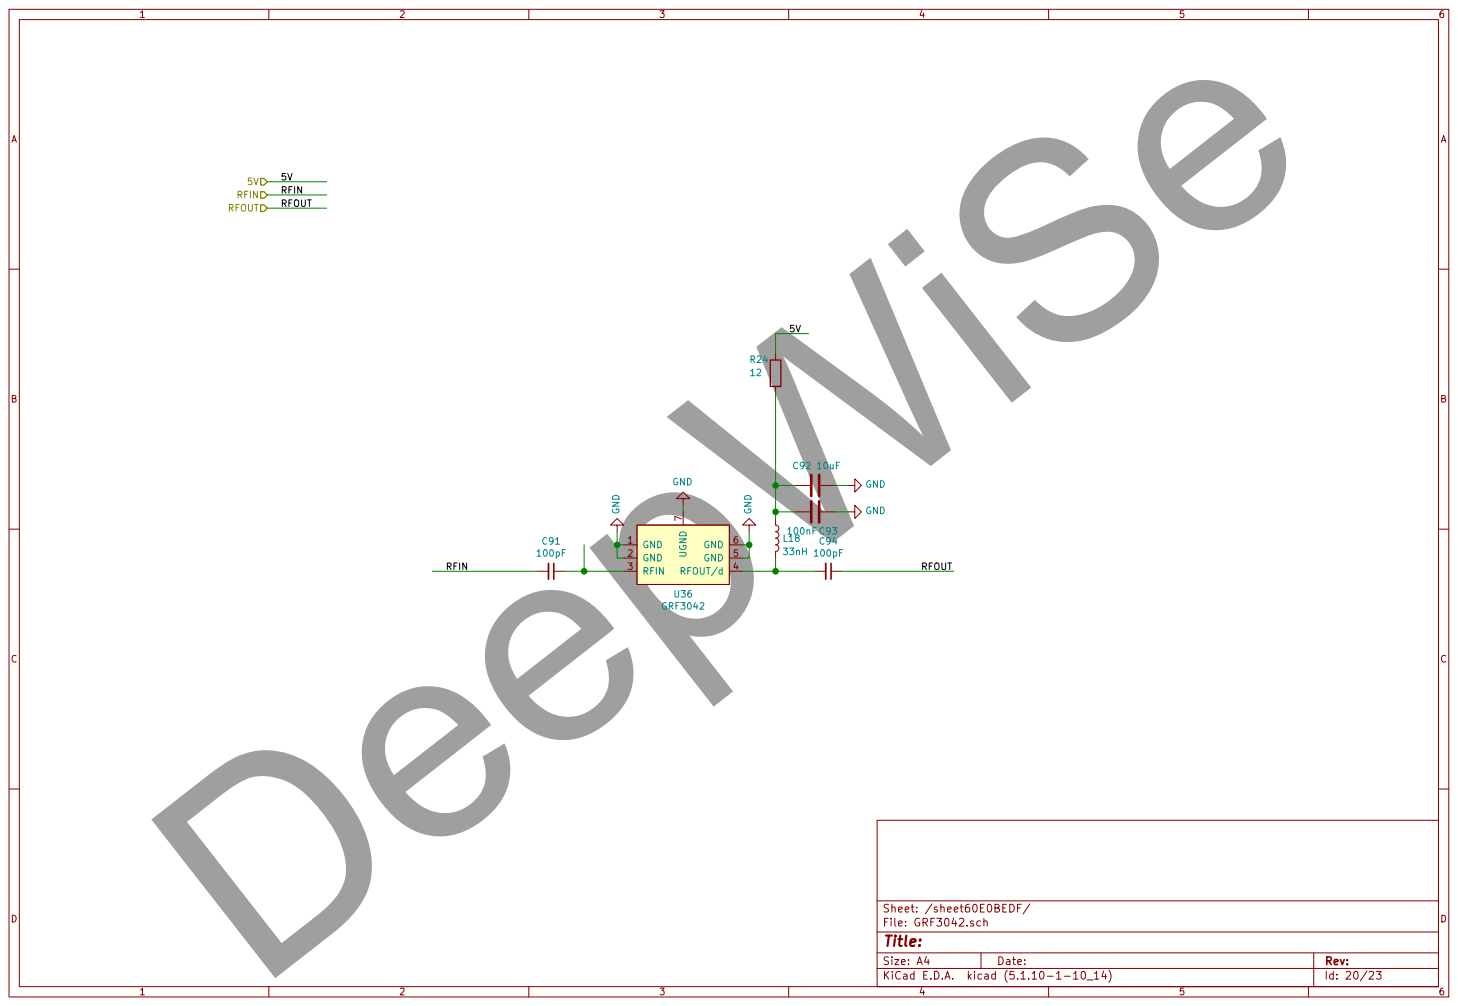
[picture p52: page 20]

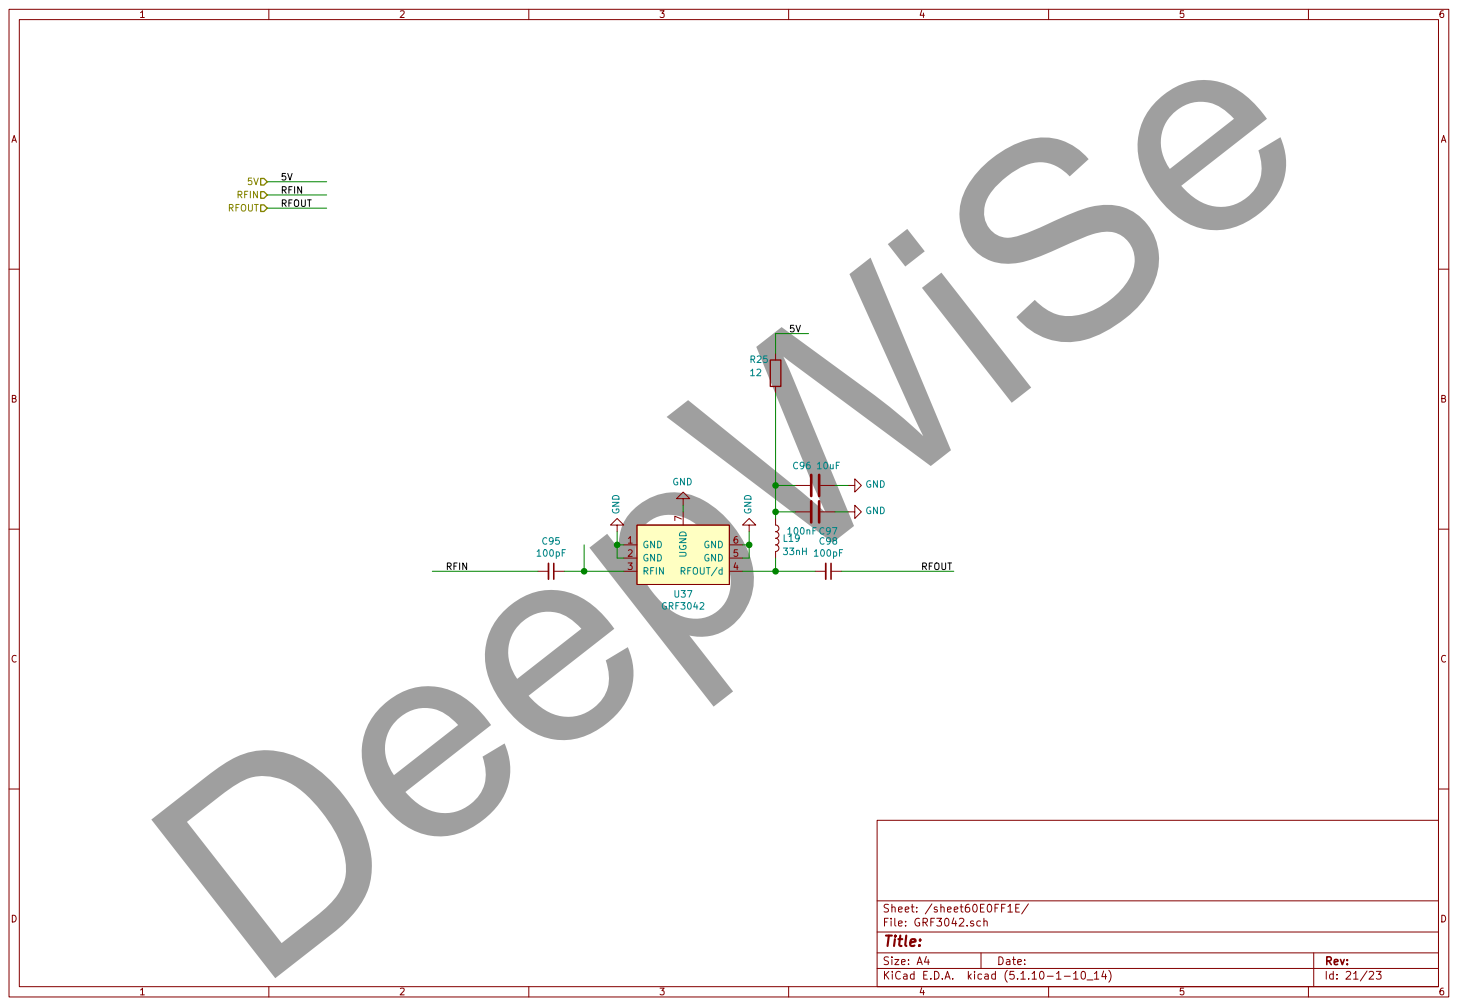
[picture p53: page 21]

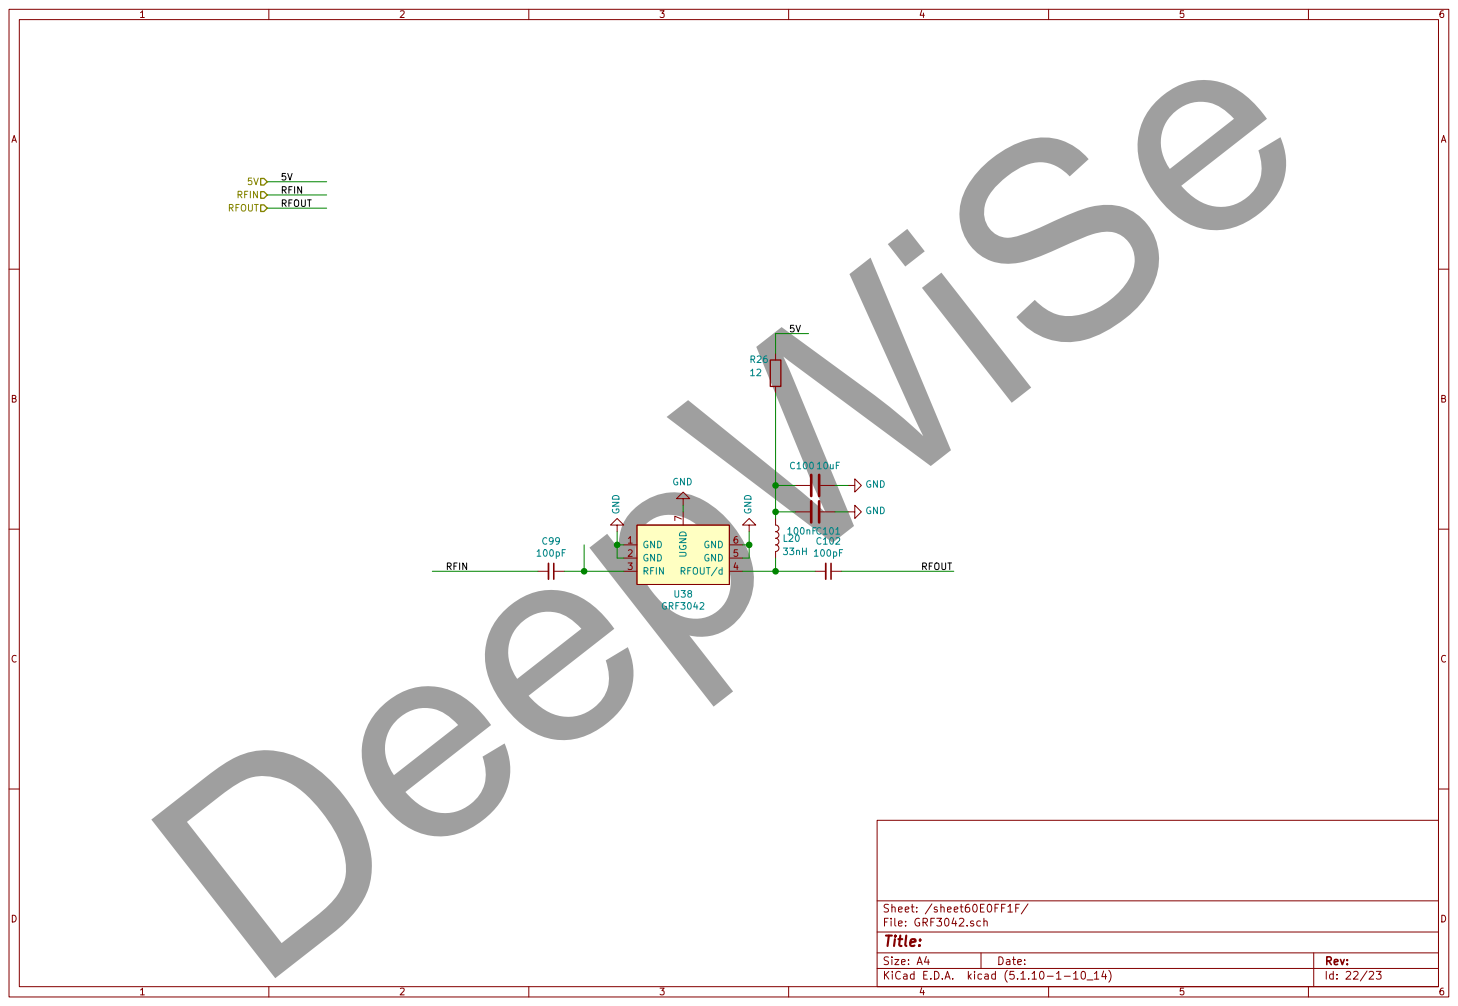
[picture p54: page 22]

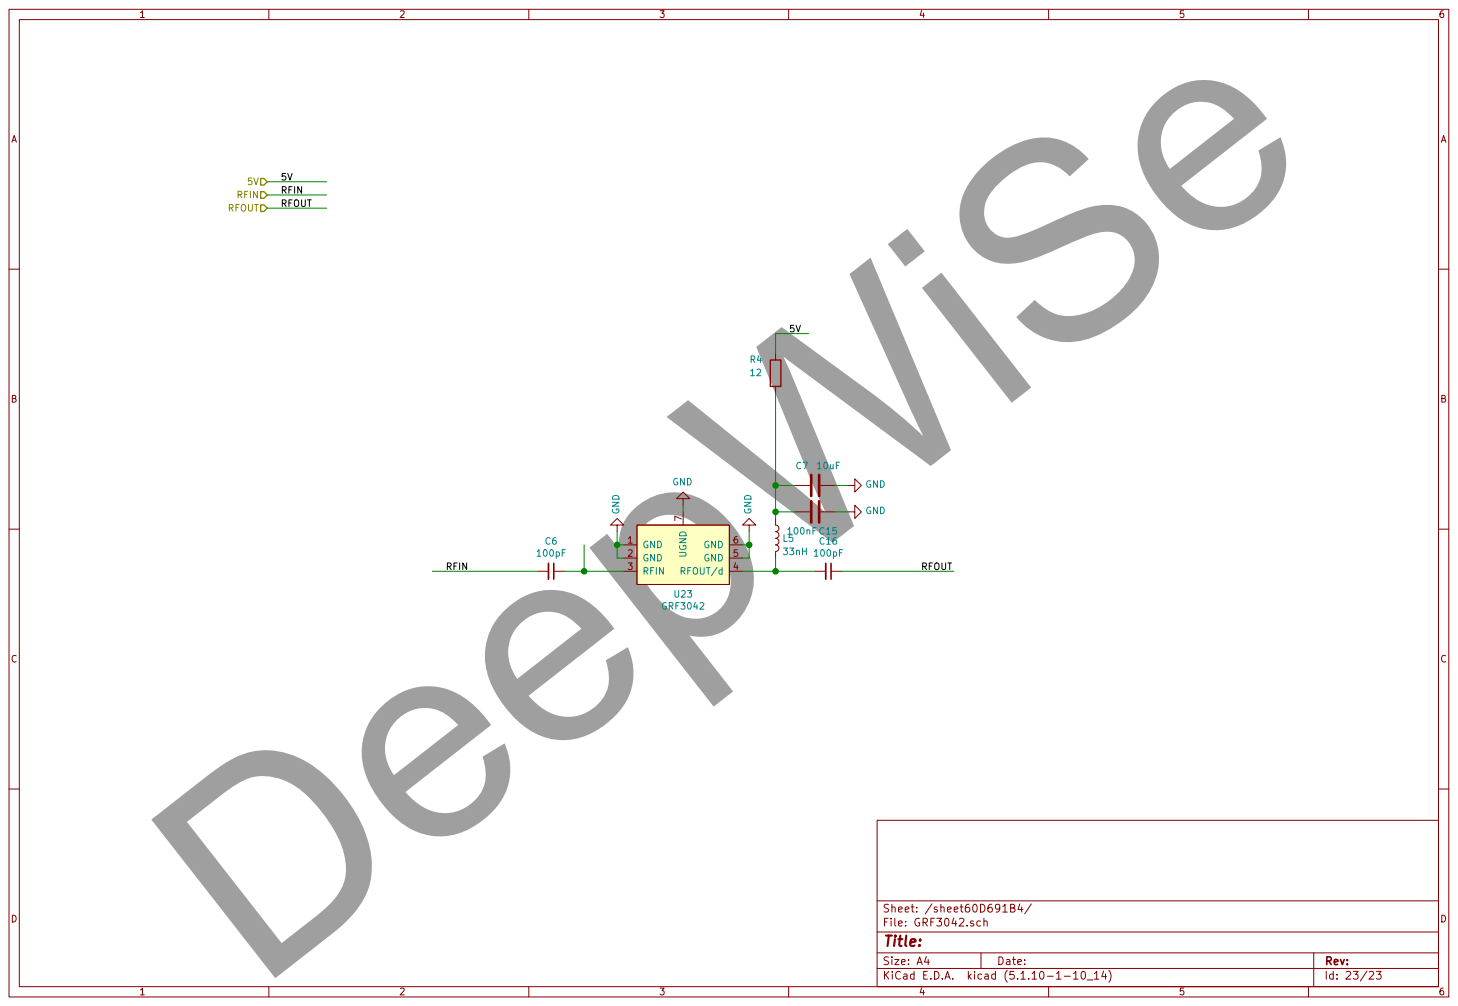
[picture p55: page 23]
