DeepWiSe888/Octopus/source/arm/stm32f7/Core/Src/main.c

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
/* Includes ------------------------------------------------------------------*/
#include "main.h"
#include "cmsis_os.h"

/* USER CODE BEGIN Includes */
#include <stdio.h>
#include "blas_tasks.h"
/* USER CODE END Includes */


CRC_HandleTypeDef hcrc;

USART_HandleTypeDef husart1;
USART_HandleTypeDef husart2;

SRAM_HandleTypeDef hsram1;
SDRAM_HandleTypeDef hsdram1;

osThreadId defaultTaskHandle;
osThreadId myTask02Handle;
osThreadId myTask03Handle;
void SystemClock_Config(void);
static void MX_GPIO_Init(void);
static void MX_USART1_Init(void);
static void MX_USART2_Init(void);
static void MX_CRC_Init(void);
static void MX_FMC_Init(void);
void StartDefaultTask(void const * argument);
void StartTask02(void const * argument);
void StartTask03(void const * argument);

/* USER CODE BEGIN 0 */
SemaphoreHandle_t xSemaphore;


/* USER CODE BEGIN 0 */
#ifdef __GNUC__
	#define PUTCHAR_PROTOTYPE int __io_putchar(int ch)
#else
	#define PUTCHAR_PROTOTYPE int fputc(int ch, FILE *f)
#endif

PUTCHAR_PROTOTYPE
{
	HAL_StatusTypeDef result = HAL_USART_Transmit(&husart2, (uint8_t *)&ch, 1, HAL_MAX_DELAY);
    return ch;
}


void HAL_GPIO_EXTI_Callback(uint16_t GPIO_Pin)
{

	 /*if(GPIO_Pin == GPIO_PIN_1)
	 {
		 static BaseType_t xHigherPriorityTaskWoken;
		 xHigherPriorityTaskWoken = pdFALSE;

		 xSemaphoreGiveFromISR( semFFT, &xHigherPriorityTaskWoken );

		 portYIELD_FROM_ISR( xHigherPriorityTaskWoken );
	 }
	 */

	 if(GPIO_Pin == GPIO_PIN_2)
	 {
		 static BaseType_t xHigherPriorityTaskWoken;
		 xHigherPriorityTaskWoken = pdFALSE;

		 //xSemaphoreGiveFromISR( semCNN, &xHigherPriorityTaskWoken );
		 xSemaphoreGiveFromISR( xSemaphore, &xHigherPriorityTaskWoken );

		 portYIELD_FROM_ISR( xHigherPriorityTaskWoken );

	 }
}
/* USER CODE END 0 */

/**
  * @brief  The application entry point.
  * @retval int
  */
int main(void)
{
  /* Enable I-Cache---------------------------------------------------------*/
  SCB_EnableICache();

  /* Enable D-Cache---------------------------------------------------------*/
  SCB_EnableDCache();

  /* MCU Configuration--------------------------------------------------------*/

  /* Reset of all peripherals, Initializes the Flash interface and the Systick. */
  HAL_Init();

  /* Configure the system clock */
  SystemClock_Config();

  /* Initialize all configured peripherals */
  MX_GPIO_Init();
  MX_USART1_Init();
  MX_USART2_Init();
  MX_CRC_Init();
  MX_FMC_Init();
  /* USER CODE BEGIN RTOS_MUTEX */
  /* add mutexes, ... */
  /* USER CODE END RTOS_MUTEX */

  /* USER CODE BEGIN RTOS_SEMAPHORES */
  /* add semaphores, ... */

	semFFT = xSemaphoreCreateBinary();

	  printf("1 create semaphore...\n");
	  xSemaphore = xSemaphoreCreateBinary();

  /* USER CODE END RTOS_SEMAPHORES */

  /* USER CODE BEGIN RTOS_TIMERS */
  /* start timers, add new ones, ... */
  /* USER CODE END RTOS_TIMERS */

  /* USER CODE BEGIN RTOS_QUEUES */
  /* add queues, ... */
  /* USER CODE END RTOS_QUEUES */

  /* Create the thread(s) */
  /* definition and creation of defaultTask */
  osThreadDef(defaultTask, StartDefaultTask, osPriorityNormal, 0, 1280);
  defaultTaskHandle = osThreadCreate(osThread(defaultTask), NULL);

  /* definition and creation of myTask02 */
  osThreadDef(myTask02, StartTask02, osPriorityIdle, 0, 128);
  myTask02Handle = osThreadCreate(osThread(myTask02), NULL);

  /* definition and creation of myTask03 */
  osThreadDef(myTask03, StartTask03, osPriorityIdle, 0, 128);
  myTask03Handle = osThreadCreate(osThread(myTask03), NULL);

  /* USER CODE BEGIN RTOS_THREADS */
  /* add threads, ... */
  //radarInit();
  /* USER CODE END RTOS_THREADS */

  /* Start scheduler */
  osKernelStart();

  /* We should never get here as control is now taken by the scheduler */
  /* Infinite loop */
  /* USER CODE BEGIN WHILE */
  while (1)
  {
    /* USER CODE END WHILE */

    /* USER CODE BEGIN 3 */
  }
  /* USER CODE END 3 */
}

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
/* USER CODE BEGIN 4 */
//#include "vmd.h"
/* USER CODE END 4 */

/* USER CODE BEGIN Header_StartDefaultTask */
/**
  * @brief  Function implementing the defaultTask thread.
  * @param  argument: Not used
  * @retval None
  */
/* USER CODE END Header_StartDefaultTask */
void StartDefaultTask(void const * argument)
{
  /* USER CODE BEGIN 5 */
	//testVMD();
  /* Infinite loop */
  //__asm
  //{
  //}

	osDelay(10*1000);

	 static BaseType_t xHigherPriorityTaskWoken = pdFALSE;

	 xSemaphoreGiveFromISR( xSemaphore, &xHigherPriorityTaskWoken );

	 xHigherPriorityTaskWoken = pdFALSE;
	 xSemaphoreGiveFromISR( xSemaphore, &xHigherPriorityTaskWoken );
  for(;;)
  {
    osDelay(1);
  }
  /* USER CODE END 5 */
}

/* USER CODE BEGIN Header_StartTask02 */
#include "vital_sign.h"
/**
* @brief Function implementing the myTask02 thread.
* @param argument: Not used
* @retval None
*/
/* USER CODE END Header_StartTask02 */
void StartTask02(void const * argument)
{
  /* USER CODE BEGIN StartTask02 */
  /* Infinite loop */
  //vitalSignDetect();

  printf("task 2 take semaphore...\n");
  if( xSemaphoreTake( xSemaphore, portTICK_RATE_MS*1000*300 ) == pdTRUE )
  {
	  printf("task 2  semaphore get.\n");

  }
  else
  {
	  printf("task 2 semaphore timeover.\n");
  }
  //return;
  for(;;)
  {
    osDelay(1);
  }
  /* USER CODE END StartTask02 */
}

/* USER CODE BEGIN Header_StartTask03 */
#include "occupancy.h"
/**
* @brief Function implementing the myTask03 thread.
* @param argument: Not used
* @retval None
*/
/* USER CODE END Header_StartTask03 */
void StartTask03(void const * argument)
{
  /* USER CODE BEGIN StartTask03 */
  //occupancyDetect();
  /* Infinite loop */
	  //return;

  printf("task 3 take semaphore...\n");
  if( xSemaphoreTake( xSemaphore, portTICK_RATE_MS*1000*300 ) == pdTRUE )
  {
	  printf("task 3  semaphore get.\n");

  }
  else
  {
	  printf("task 3 semaphore timeover.\n");
  }
  for(;;)
  {
    osDelay(1);
  }
  /* USER CODE END StartTask03 */
}

 /**
  * @brief  Period elapsed callback in non blocking mode
  * @note   This function is called  when TIM1 interrupt took place, inside
  * HAL_TIM_IRQHandler(). It makes a direct call to HAL_IncTick() to increment
  * a global variable "uwTick" used as application time base.
  * @param  htim : TIM handle
  * @retval None
  */
void HAL_TIM_PeriodElapsedCallback(TIM_HandleTypeDef *htim)
{
  if (htim->Instance == TIM1) {
    HAL_IncTick();
  }
}

/**
  * @brief  This function is executed in case of error occurrence.
  * @retval None
  */
void Error_Handler(void)
{
  /* USER CODE BEGIN Error_Handler_Debug */
  /* User can add his own implementation to report the HAL error return state */
  __disable_irq();
  while (1)
  {
  }
  /* USER CODE END Error_Handler_Debug */
}

#ifdef  USE_FULL_ASSERT
/**
  * @brief  Reports the name of the source file and the source line number
  *         where the assert_param error has occurred.
  * @param  file: pointer to the source file name
  * @param  line: assert_param error line source number
  * @retval None
  */
void assert_failed(uint8_t *file, uint32_t line)
{
  /* USER CODE BEGIN 6 */
  /* User can add his own implementation to report the file name and line number,
     ex: printf("Wrong parameters value: file %s on line %d\r\n", file, line) */
  /* USER CODE END 6 */
}
#endif /* USE_FULL_ASSERT */

/************************ (C) COPYRIGHT STMicroelectronics *****END OF FILE****/
