DeepWiSe888/Octopus/source/arm/stm32f7/bbb.ioc

PG4.Signal=FMC_A14_BA0
PG8.Signal=FMC_SDCLK
PG0.Signal=FMC_A10
PD4.Signal=FMC_NOE
PH1/OSC_OUT.Signal=RCC_OSC_OUT
PC3.Signal=FMC_SDCKE0
PD0.Signal=FMC_D2_DA2
PD8.Signal=FMC_D13_DA13
PE5.Signal=FMC_A21
PE9.Signal=FMC_D6_DA6
PE2.Signal=FMC_A23
PA8.Signal=USART1_CK
PF3.Signal=FMC_A3
PE10.Signal=FMC_D7_DA7
PD12.Signal=FMC_A17_ALE
PH2.Signal=GPXTI2
PF14.Signal=FMC_A8
PD15.Signal=FMC_D1_DA1
PG5.Signal=FMC_A15_BA1
PC2.Signal=FMC_SDNE0
PD1.Signal=FMC_D3_DA3
PC0.Signal=FMC_SDNWE
PD10.Signal=FMC_D15_DA15
PB14.Signal=USART1_TX
PE14.Signal=FMC_D11_DA11
PE15.Signal=FMC_D12_DA12
PE8.Signal=FMC_D5_DA5
PF13.Signal=FMC_A7
PA4.Signal=USART2_CK
PD11.Signal=FMC_A16_CLE
PE3.Signal=FMC_A19
PF4.Signal=FMC_A4
Mcu.UserName=STM32F767IGTx
PB15.Signal=USART1_RX
PG15.Signal=FMC_SDNCAS
PD13.Signal=FMC_A18
PF12.Signal=FMC_A6
PE13.Signal=FMC_D10_DA10
PF11.Signal=FMC_SDNRAS
PE4.Signal=FMC_A20
PF5.Signal=FMC_A5
PF0.Signal=FMC_A0
PE7.Signal=FMC_D4_DA4
PA3.Signal=USART2_RX
PC8.Signal=FMC_NE2
PD9.Signal=FMC_D14_DA14
PD5.Signal=FMC_NWE
PF2.Signal=FMC_A2
PE11.Signal=FMC_D8_DA8
PH0/OSC_IN.Signal=RCC_OSC_IN
PF15.Signal=FMC_A9
PF1.Signal=FMC_A1
PE6.Signal=FMC_A22
PE12.Signal=FMC_D9_DA9
PA2.Signal=USART2_TX
PD14.Signal=FMC_D0_DA0
