DeepWiSe888/Octopus/source/fpga/core/fft_ctrl.v

//****************************************************************************************//

module fft_ctrl(
    input      clk_100m,
    input      rst_n,
  
    input      fifo_rd_empty,
    output     fifo_rdreq,
      
    input      fft_ready,
    output reg fft_rst_n,
    output reg fft_valid,
    output     fft_sop,
    output     fft_eop
);

//reg define
reg         state;
reg  [4:0]  delay_cnt;
reg  [9:0]  fft_cnt;   
reg         rd_en;

//*****************************************************
//**                   
//***************************************************** 

assign fifo_rdreq = rd_en && (~fifo_rd_empty);             //fifo 
assign fft_sop    = (fft_cnt==10'd1)   ? fft_valid : 1'b0; // 
assign fft_eop    = (fft_cnt==10'd128) ? fft_valid : 1'b0; // 

// 
always @ (posedge clk_100m or negedge rst_n) begin
    if(!rst_n) begin
        state     <= 1'b0;
        rd_en     <= 1'b0;
        fft_valid <= 1'b0;
        fft_rst_n <= 1'b0;
        fft_cnt   <= 10'd0;
        delay_cnt <= 5'd0;
    end
    else begin
        case(state)
            1'b0: begin
                fft_valid <= 1'b0;
                fft_cnt   <= 10'd0;
                
                if(delay_cnt < 5'd31) begin // 
                    delay_cnt <= delay_cnt + 1'b1;
                    fft_rst_n <= 1'b0;
                end
                else begin
                    delay_cnt <= delay_cnt;
                    fft_rst_n <= 1'b1;
                end
                
                if((delay_cnt==5'd31)&&(fft_ready))
                    state <= 1'b1;
                else
                    state <= 1'b0;
            end
            1'b1: begin
                if(!fifo_rd_empty)
                    rd_en <= 1'b1;
                else
                    rd_en <= 1'b0;
                        
                if(fifo_rdreq) begin
                    fft_valid <= 1'b1;
                    if(fft_cnt < 10'd128)
                        fft_cnt <= fft_cnt + 1'b1;
                    else
                        fft_cnt <= 10'd1;
                end
                else begin
                    fft_valid <= 1'b0;
                    fft_cnt <= fft_cnt;
                end
            end
            default: state <= 1'b0;
        endcase
    end
end

endmodule 
