DeepWiSe888/Octopus/source/fpga/SDRAM/sdram.v

// sdram.v

// Generated using ACDS version 13.1 162 at 2021.07.22.15:08:24

`timescale 1 ps / 1 ps
module sdram (
		input  wire        clk_clk,                  //        clk.clk
		input  wire        reset_reset_n,            //      reset.reset_n
		input  wire [24:0] sdram_ctrl_address,       // sdram_ctrl.address
		input  wire [1:0]  sdram_ctrl_byteenable_n,  //           .byteenable_n
		input  wire        sdram_ctrl_chipselect,    //           .chipselect
		input  wire [15:0] sdram_ctrl_writedata,     //           .writedata
		input  wire        sdram_ctrl_read_n,        //           .read_n
		input  wire        sdram_ctrl_write_n,       //           .write_n
		output wire [15:0] sdram_ctrl_readdata,      //           .readdata
		output wire        sdram_ctrl_readdatavalid, //           .readdatavalid
		output wire        sdram_ctrl_waitrequest,   //           .waitrequest
		output wire [12:0] sdram_out_addr,           //  sdram_out.addr
		output wire [1:0]  sdram_out_ba,             //           .ba
		output wire        sdram_out_cas_n,          //           .cas_n
		output wire        sdram_out_cke,            //           .cke
		output wire        sdram_out_cs_n,           //           .cs_n
		inout  wire [15:0] sdram_out_dq,             //           .dq
		output wire [1:0]  sdram_out_dqm,            //           .dqm
		output wire        sdram_out_ras_n,          //           .ras_n
		output wire        sdram_out_we_n            //           .we_n
	);

	wire    rst_controller_reset_out_reset; // rst_controller:reset_out -> sdram:reset_n

	sdram_sdram sdram (
		.clk            (clk_clk),                         //   clk.clk
		.reset_n        (~rst_controller_reset_out_reset), // reset.reset_n
		.az_addr        (sdram_ctrl_address),              //    s1.address
		.az_be_n        (sdram_ctrl_byteenable_n),         //      .byteenable_n
		.az_cs          (sdram_ctrl_chipselect),           //      .chipselect
		.az_data        (sdram_ctrl_writedata),            //      .writedata
		.az_rd_n        (sdram_ctrl_read_n),               //      .read_n
		.az_wr_n        (sdram_ctrl_write_n),              //      .write_n
		.za_data        (sdram_ctrl_readdata),             //      .readdata
		.za_valid       (sdram_ctrl_readdatavalid),        //      .readdatavalid
		.za_waitrequest (sdram_ctrl_waitrequest),          //      .waitrequest
		.zs_addr        (sdram_out_addr),                  //  wire.export
		.zs_ba          (sdram_out_ba),                    //      .export
		.zs_cas_n       (sdram_out_cas_n),                 //      .export
		.zs_cke         (sdram_out_cke),                   //      .export
		.zs_cs_n        (sdram_out_cs_n),                  //      .export
		.zs_dq          (sdram_out_dq),                    //      .export
		.zs_dqm         (sdram_out_dqm),                   //      .export
		.zs_ras_n       (sdram_out_ras_n),                 //      .export
		.zs_we_n        (sdram_out_we_n)                   //      .export
	);

	altera_reset_controller #(
		.NUM_RESET_INPUTS          (1),
		.OUTPUT_RESET_SYNC_EDGES   ("deassert"),
		.SYNC_DEPTH                (2),
		.RESET_REQUEST_PRESENT     (0),
		.RESET_REQ_WAIT_TIME       (1),
		.MIN_RST_ASSERTION_TIME    (3),
		.RESET_REQ_EARLY_DSRT_TIME (1),
		.USE_RESET_REQUEST_IN0     (0),
		.USE_RESET_REQUEST_IN1     (0),
		.USE_RESET_REQUEST_IN2     (0),
		.USE_RESET_REQUEST_IN3     (0),
		.USE_RESET_REQUEST_IN4     (0),
		.USE_RESET_REQUEST_IN5     (0),
		.USE_RESET_REQUEST_IN6     (0),
		.USE_RESET_REQUEST_IN7     (0),
		.USE_RESET_REQUEST_IN8     (0),
		.USE_RESET_REQUEST_IN9     (0),
		.USE_RESET_REQUEST_IN10    (0),
		.USE_RESET_REQUEST_IN11    (0),
		.USE_RESET_REQUEST_IN12    (0),
		.USE_RESET_REQUEST_IN13    (0),
		.USE_RESET_REQUEST_IN14    (0),
		.USE_RESET_REQUEST_IN15    (0),
		.ADAPT_RESET_REQUEST       (0)
	) rst_controller (
		.reset_in0      (~reset_reset_n),                 // reset_in0.reset
		.clk            (clk_clk),                        //       clk.clk
		.reset_out      (rst_controller_reset_out_reset), // reset_out.reset
		.reset_req      (),                               // (terminated)
		.reset_req_in0  (1'b0),                           // (terminated)
		.reset_in1      (1'b0),                           // (terminated)
		.reset_req_in1  (1'b0),                           // (terminated)
		.reset_in2      (1'b0),                           // (terminated)
		.reset_req_in2  (1'b0),                           // (terminated)
		.reset_in3      (1'b0),                           // (terminated)
		.reset_req_in3  (1'b0),                           // (terminated)
		.reset_in4      (1'b0),                           // (terminated)
		.reset_req_in4  (1'b0),                           // (terminated)
		.reset_in5      (1'b0),                           // (terminated)
		.reset_req_in5  (1'b0),                           // (terminated)
		.reset_in6      (1'b0),                           // (terminated)
		.reset_req_in6  (1'b0),                           // (terminated)
		.reset_in7      (1'b0),                           // (terminated)
		.reset_req_in7  (1'b0),                           // (terminated)
		.reset_in8      (1'b0),                           // (terminated)
		.reset_req_in8  (1'b0),                           // (terminated)
		.reset_in9      (1'b0),                           // (terminated)
		.reset_req_in9  (1'b0),                           // (terminated)
		.reset_in10     (1'b0),                           // (terminated)
		.reset_req_in10 (1'b0),                           // (terminated)
		.reset_in11     (1'b0),                           // (terminated)
		.reset_req_in11 (1'b0),                           // (terminated)
		.reset_in12     (1'b0),                           // (terminated)
		.reset_req_in12 (1'b0),                           // (terminated)
		.reset_in13     (1'b0),                           // (terminated)
		.reset_req_in13 (1'b0),                           // (terminated)
		.reset_in14     (1'b0),                           // (terminated)
		.reset_req_in14 (1'b0),                           // (terminated)
		.reset_in15     (1'b0),                           // (terminated)
		.reset_req_in15 (1'b0)                            // (terminated)
	);

endmodule
