DeepWiSe888/Octopus/source/window_prj/x4driver/8051_firmware.h

/**
* Embedded X4 Contains the default 8051 code.
* Used for programming in the X4 internal SRAM.
*/
static const uint8_t  data_8051_onboard[] = {
    0x02,0x00,0x42,0x02,0x05,0x09,0x00,0x00,0x00,0x00,0x00,0x02,0x05,0x3c,0x00,0x00,
    0x00,0x00,0x00,0x02,0x05,0x18,0x00,0x00,0x00,0x80,0xfb,0xe4,0x79,0x21,0x78,0x34,
    0xb8,0x00,0x02,0x80,0x04,0xf7,0x09,0xd8,0xfc,0x78,0x10,0x90,0x00,0x4e,0x7a,0x09,
    0xba,0x00,0x02,0x80,0x07,0xe4,0x93,0xa3,0xf6,0x08,0xda,0xf9,0x12,0x05,0x7f,0x12,
    0x00,0x16,0x75,0xd0,0x00,0x75,0x81,0xbf,0x53,0x92,0xf8,0x02,0x00,0x1b,0x01,0xff,
    0x28,0x1f,0x0f,0x01,0x00,0x00,0x00,0xc3,0xe7,0x96,0x08,0x09,0xe7,0x96,0x08,0x09,
    0xe7,0x96,0x08,0x09,0xe7,0x96,0x22,0xe4,0xcf,0xc0,0xe0,0xe4,0xce,0xc0,0xe0,0xe4,
    0xcd,0xc0,0xe0,0xe4,0xcc,0xc0,0xe0,0x75,0xf0,0x20,0xe6,0x26,0xf6,0x08,0xe6,0x33,
    0xf6,0x08,0xe6,0x33,0xf6,0x08,0xe6,0x33,0xf6,0x18,0x18,0x18,0xec,0x33,0xfc,0xed,
    0x33,0xfd,0xee,0x33,0xfe,0xef,0x33,0xff,0xc3,0xec,0x97,0x09,0xed,0x97,0x09,0xee,
    0x97,0x09,0xef,0x97,0x19,0x19,0x19,0x40,0x0f,0xff,0xec,0x97,0xfc,0x09,0xed,0x97,
    0xfd,0x09,0xee,0x97,0xfe,0x19,0x19,0x06,0xd5,0xf0,0xbf,0xec,0xf7,0x09,0xed,0xf7,
    0x09,0xee,0xf7,0x09,0xef,0xf7,0x19,0x19,0x19,0xd0,0xe0,0xfc,0xd0,0xe0,0xfd,0xd0,
    0xe0,0xfe,0xd0,0xe0,0xff,0x22,0x12,0x01,0x3e,0x18,0x18,0x18,0x12,0x00,0x67,0x12,
    0x01,0x2d,0x19,0x19,0x19,0x22,0x12,0x01,0x2d,0x19,0x19,0x19,0x08,0x08,0x08,0xe6,
    0x18,0x18,0x18,0x20,0xe7,0xe0,0x12,0x00,0x67,0x12,0x01,0x3e,0x18,0x18,0x18,0x22,
    0x09,0x09,0x09,0xe7,0x19,0x19,0x19,0x20,0xe7,0xdc,0x08,0x08,0x08,0xe6,0x18,0x18,
    0x18,0x20,0xe7,0x03,0x02,0x00,0x67,0x12,0x01,0x3e,0x18,0x18,0x18,0x12,0x00,0x67,
    0x12,0x01,0x3e,0x18,0x18,0x18,0x12,0x01,0x2d,0x19,0x19,0x19,0x22,0xe4,0xc3,0x97,
    0xf7,0x09,0xe4,0x97,0xf7,0x09,0xe4,0x97,0xf7,0x09,0xe4,0x97,0xf7,0x22,0xe4,0xc3,
    0x96,0xf6,0x08,0xe4,0x96,0xf6,0x08,0xe4,0x96,0xf6,0x08,0xe4,0x96,0xf6,0x22,0x70,
    0x09,0x08,0x08,0x08,0x22,0x60,0x16,0x18,0x18,0x18,0xc6,0xc3,0x33,0xc6,0x08,0xc6,
    0x33,0xc6,0x08,0xc6,0x33,0xc6,0x08,0xc6,0x33,0xc6,0xd5,0xe0,0xea,0x22,0xe6,0x27,
    0xf6,0x08,0x09,0xe6,0x37,0xf6,0x08,0x09,0xe6,0x37,0xf6,0x08,0x09,0xe6,0x37,0xf6,
    0x22,0xe6,0x47,0xf6,0x08,0x09,0xe6,0x47,0xf6,0x08,0x09,0xe6,0x47,0xf6,0x08,0x09,
    0xe6,0x47,0xf6,0x22,0xe7,0xf6,0x08,0x09,0xe7,0xf6,0x08,0x09,0xe7,0xf6,0x08,0x09,
    0xe7,0xf6,0x22,0xc9,0xc0,0xe0,0xe7,0xf6,0x08,0x09,0xe7,0xf6,0x08,0x09,0xe7,0xf6,
    0x08,0x09,0xe7,0xf6,0xd0,0xe0,0xf9,0x22,0xb9,0x00,0x10,0xbb,0x00,0x08,0xe8,0x8a,
    0xf0,0x84,0xf8,0xaa,0xf0,0x22,0xe4,0xfb,0xc8,0xfa,0x22,0xeb,0x70,0x22,0x7b,0x10,
    0xc8,0x33,0xc8,0xc9,0x33,0xc9,0x33,0x50,0x07,0xc3,0x9a,0xc3,0xdb,0xf2,0x80,0x06,
    0x9a,0x50,0x01,0x2a,0xdb,0xea,0xc8,0x33,0xf4,0xc8,0xc9,0x33,0xf4,0xc9,0xfa,0x22,
    0x75,0xf0,0x08,0xe4,0xc8,0x33,0xc8,0xc9,0x33,0xc9,0x33,0xc9,0x9a,0xc9,0x9b,0x50,
    0x04,0xc9,0x2a,0xc9,0x3b,0xd5,0xf0,0xec,0xfb,0xc8,0x33,0xf4,0xc8,0xe4,0xc9,0xfa,
    0x22,0xe4,0x73,0x53,0x92,0xf8,0xd0,0x83,0xd0,0x82,0xce,0xc0,0xe0,0xef,0xc0,0xe0,
    0xc0,0x20,0x78,0x08,0xe6,0x08,0xc0,0xe0,0xde,0xfa,0xe4,0x73,0xc0,0xd0,0x74,0x07,
    0x2f,0xd0,0xd0,0xf8,0xd0,0xe0,0xf6,0x18,0xdf,0xfa,0xd0,0x20,0xd0,0xe0,0xff,0xd0,
    0xe0,0xfe,0x53,0x92,0xf8,0x22,0xc0,0x92,0x53,0x92,0xf8,0xc8,0xc0,0xe0,0xe9,0xc0,
    0xe0,0xa9,0x81,0x19,0x19,0x19,0xe5,0x83,0xc7,0xf5,0x83,0x19,0xe5,0x82,0xc7,0xf5,
    0x82,0xea,0xc0,0xe0,0xeb,0xc0,0xe0,0xec,0xc0,0xe0,0xed,0xc0,0xe0,0xee,0xc0,0xe0,
    0xef,0xc0,0xe0,0xc0,0xd0,0xc0,0xf0,0xc0,0x20,0x79,0x08,0xe7,0x09,0xc0,0xe0,0xd8,
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


/**
* Size of the embedded 8051 code.
*/
static const uint32_t  data_8051_size = 1843;
