DeepWiSe888/Octopus/source/arm/stm32f7/Core/fmc/fmc.c

//---------------- Include files ------------------------//

#include "fsmc.h"
#include "stm32f7xx_hal.h"


//---------------- Function Prototype -------------------//

static int initialize(void);

//---------------- Variable -----------------------------//


FSMC_T fsmc = {
	.initialize = initialize
};


static int initialize(void)
{
  GPIO_InitTypeDef GPIO_InitStruct;
	FMC_NORSRAM_TimingTypeDef Timing;
	SRAM_HandleTypeDef hsram1;
	
  /** Perform the SRAM1 memory initialization sequence
  */
  hsram1.Instance = FMC_NORSRAM_DEVICE;
  hsram1.Extended = FMC_NORSRAM_EXTENDED_DEVICE;

	__HAL_RCC_GPIOB_CLK_ENABLE();
  __HAL_RCC_GPIOE_CLK_ENABLE();
  __HAL_RCC_GPIOD_CLK_ENABLE();
	


  /* Peripheral clock enable */
  __HAL_RCC_FMC_CLK_ENABLE();
  
  /** FMC GPIO Configuration  
	PD6   ------> FMC_NWAIT
	PD3   ------> FMC_CLK
	PB7   ------> NADV
  PD5   ------> FMC_NWE
  PD4   ------> FMC_NOE	
	PD7   ------> CS0
	
  PD14  ------> FMC_D0
  PD15  ------> FMC_D1	
  PD0   ------> FMC_D2
  PD1   ------> FMC_D3	
  PE7   ------> FMC_D4
  PE8   ------> FMC_D5
  PE9   ------> FMC_D6
  PE10  ------> FMC_D7
  PE11  ------> FMC_D8
  PE12  ------> FMC_D9
  PE13  ------> FMC_D10
  PE14  ------> FMC_D11
  PE15  ------> FMC_D12
  PD8   ------> FMC_D13
  PD9   ------> FMC_D14
  PD10  ------> FMC_D15


  PD11  ------> FMC_A16
  PD12  ------> FMC_A17
  PD13  ------> FMC_A18
  PE3   ------> FMC_A19
  PE4   ------> FMC_A20
  PE5   ------> FMC_A21
  PE6   ------> FMC_A22
  PE2   ------> FMC_A23
  */
	
	//NADV
	GPIO_InitStruct.Pin = GPIO_PIN_7;
  GPIO_InitStruct.Mode = GPIO_MODE_AF_PP;
  GPIO_InitStruct.Pull = GPIO_NOPULL;
  GPIO_InitStruct.Speed = GPIO_SPEED_FREQ_VERY_HIGH;	
  GPIO_InitStruct.Alternate = GPIO_AF12_FMC;
  HAL_GPIO_Init(GPIOB, &GPIO_InitStruct);	
	
  GPIO_InitStruct.Pin = GPIO_PIN_0|GPIO_PIN_1|GPIO_PIN_3|GPIO_PIN_4|GPIO_PIN_5
													|GPIO_PIN_6|GPIO_PIN_7|GPIO_PIN_8|GPIO_PIN_9|GPIO_PIN_10
													|GPIO_PIN_11|GPIO_PIN_12|GPIO_PIN_13|GPIO_PIN_14|GPIO_PIN_15;
 
  GPIO_InitStruct.Mode = GPIO_MODE_AF_PP;
  GPIO_InitStruct.Pull = GPIO_NOPULL;
  GPIO_InitStruct.Speed = GPIO_SPEED_FREQ_VERY_HIGH;
  GPIO_InitStruct.Alternate = GPIO_AF12_FMC;
  HAL_GPIO_Init(GPIOD, &GPIO_InitStruct);
	

  GPIO_InitStruct.Pin = GPIO_PIN_3|GPIO_PIN_4|GPIO_PIN_5 
                          |GPIO_PIN_6|GPIO_PIN_7|GPIO_PIN_8|GPIO_PIN_9 
                          |GPIO_PIN_10|GPIO_PIN_11|GPIO_PIN_12|GPIO_PIN_13 
                          |GPIO_PIN_14|GPIO_PIN_15;
  
	GPIO_InitStruct.Mode = GPIO_MODE_AF_PP;
  GPIO_InitStruct.Pull = GPIO_NOPULL;
  GPIO_InitStruct.Speed = GPIO_SPEED_FREQ_VERY_HIGH;
  GPIO_InitStruct.Alternate = GPIO_AF12_FMC;
  HAL_GPIO_Init(GPIOE, &GPIO_InitStruct);

  /* Timing */
  Timing.AddressSetupTime = 7;
  Timing.AddressHoldTime = 1;
  Timing.DataSetupTime = 6;
  Timing.BusTurnAroundDuration = 0;
  Timing.CLKDivision = 0;
  Timing.DataLatency = 0;
  Timing.AccessMode = FMC_ACCESS_MODE_A;
  /* ExtTiming */	
		
  /* hsram1.Init */
  hsram1.Init.NSBank = FMC_NORSRAM_BANK1;
  hsram1.Init.DataAddressMux = FMC_DATA_ADDRESS_MUX_ENABLE;
  hsram1.Init.MemoryType = FMC_MEMORY_TYPE_NOR;
  hsram1.Init.MemoryDataWidth = FMC_NORSRAM_MEM_BUS_WIDTH_16;
  hsram1.Init.BurstAccessMode = FMC_BURST_ACCESS_MODE_DISABLE;
  hsram1.Init.WaitSignalPolarity = FMC_WAIT_SIGNAL_POLARITY_LOW;
  hsram1.Init.WaitSignalActive = FMC_WAIT_TIMING_BEFORE_WS;
  hsram1.Init.WriteOperation = FMC_WRITE_OPERATION_ENABLE;
  hsram1.Init.WaitSignal = FMC_WAIT_SIGNAL_DISABLE;
  hsram1.Init.ExtendedMode = FMC_EXTENDED_MODE_DISABLE;
  hsram1.Init.AsynchronousWait = FMC_ASYNCHRONOUS_WAIT_DISABLE;
  hsram1.Init.WriteBurst = FMC_WRITE_BURST_DISABLE;
  hsram1.Init.ContinuousClock = FMC_CONTINUOUS_CLOCK_SYNC_ASYNC;//
  hsram1.Init.WriteFifo = FMC_WRITE_FIFO_ENABLE;//
  hsram1.Init.PageSize = FMC_PAGE_SIZE_NONE;//
	
	if(HAL_SRAM_Init(&hsram1,&Timing,NULL) != HAL_OK){
		while(1);
	}
	
	return 0;
} 
