DeepWiSe888/Octopus/source/FPGA_qxp_prj/src/ip_core/global_clk/global_clk_inst.vhd

	component global_clk is
		port (
			inclk  : in  std_logic := 'X'; -- inclk
			outclk : out std_logic         -- outclk
		);
	end component global_clk;

	u0 : component global_clk
		port map (
			inclk  => CONNECTED_TO_inclk,  --  altclkctrl_input.inclk
			outclk => CONNECTED_TO_outclk  -- altclkctrl_output.outclk
		);
