DeepWiSe888/Octopus/source/FPGA_qxp_prj/src/ip_core/global_clk/synthesis/global_clk.v

// global_clk.v

// Generated using ACDS version 17.1 590

`timescale 1 ps / 1 ps
module global_clk (
		input  wire  inclk,  //  altclkctrl_input.inclk
		output wire  outclk  // altclkctrl_output.outclk
	);

	global_clk_altclkctrl_0 altclkctrl_0 (
		.inclk  (inclk),  //  altclkctrl_input.inclk
		.outclk (outclk)  // altclkctrl_output.outclk
	);

endmodule
