DeepWiSe888/Octopus/source/FPGA_qxp_prj/src/ip_core/wfifo_8x2k_inst.v

wfifo_8x2k	wfifo_8x2k_inst (
	.data ( data_sig ),
	.rdclk ( rdclk_sig ),
	.rdreq ( rdreq_sig ),
	.wrclk ( wrclk_sig ),
	.wrreq ( wrreq_sig ),
	.q ( q_sig ),
	.rdusedw ( rdusedw_sig ),
	.wrusedw ( wrusedw_sig )
	);
