DeepWiSe888/Octopus/source/arm/stm32f7/Core/fmc/fsmc.h

//-----------------define-------------------------------//
#ifndef __fsmc_h__
#define __fsmc_h__

//-----------------Include files-------------------------//

//----------------- Define ------------------------------//

#define fpga_write(offset,data)	*((volatile unsigned short int *)(0x60000000 + (offset << 1))) = data

#define fpga_read(offset)	*((volatile unsigned short int *)(0x60000000 + (offset << 1)))

//----------------- Typedef -----------------------------//
typedef struct{
	int (* initialize)(void);
}FSMC_T;
//---------------- Extern -------------------------------//

extern FSMC_T fsmc;

#endif //__fsmc_h__
