DeepWiSe888/Octopus/(commit log)

2021-07-20 schematics uploading
2021-07-23 add makefile for stm32f7 (stm32cubeide recommanded or keil).
2021-07-24 add freeRTOS codes.
    [bbb Debug.cfg]
2021-07-31 update task thread define.
2021-08-03 fix thread function.
2021-08-09 updated arm/readme.md
2022-05-16 update FPGA prj
    [c5_pin_model_dump.txt, gg.stp]
