DeepWiSe888/Octopus/(notices)

Notices in the files:
source/arm/stm32f7/Core/Src/main.c:
© Copyright (c) 2021 STMicroelectronics.
All rights reserved.
This software component is licensed by ST under Ultimate Liberty license
